podonoghue/SolderingStation/Mechanical/OLED_128x64_2-42inch.png

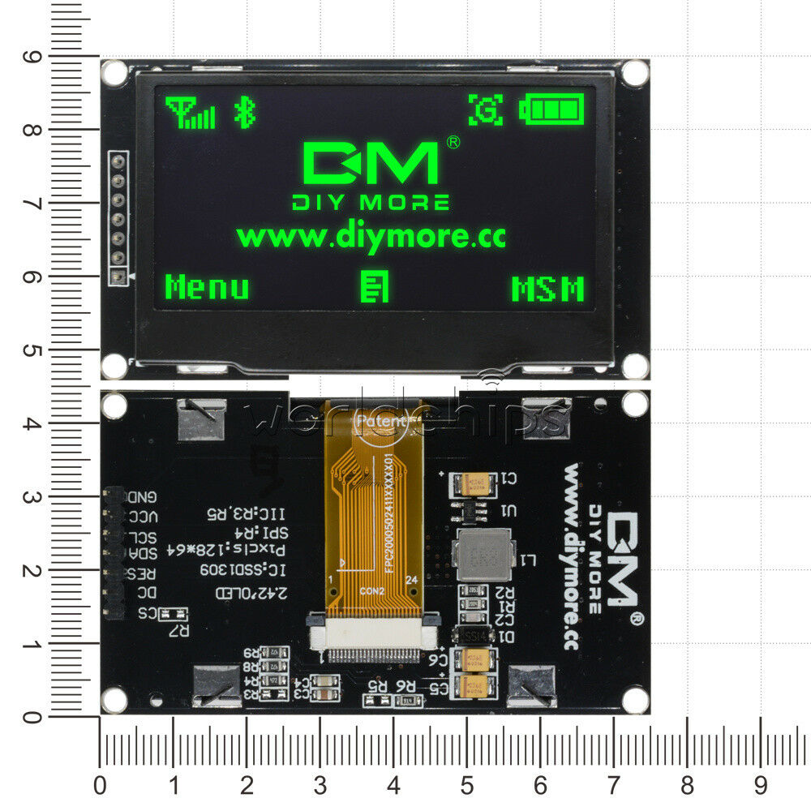
Mechanical/OLED_128x64_2-42inch.png
