podonoghue/SolderingStation/Mechanical/OLED_128x64_2-42inch#2.png

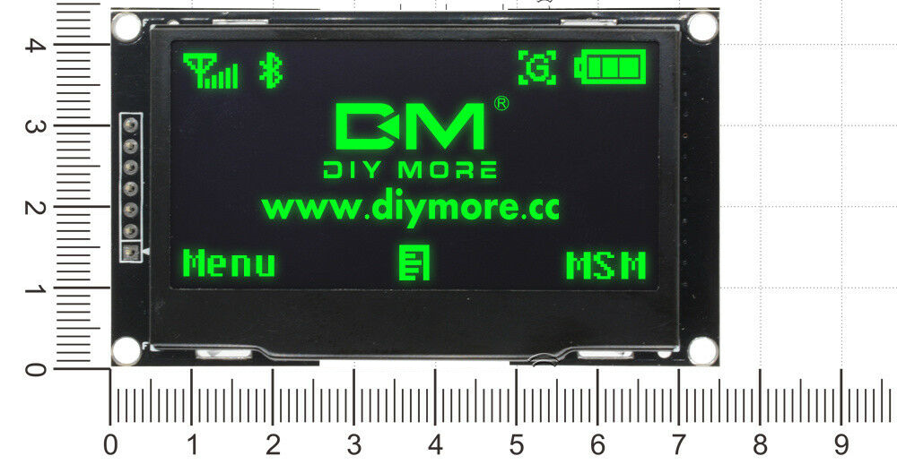
Mechanical/OLED_128x64_2-42inch#2.png
