podonoghue/SolderingStation/README.md

# SolderingStation

Soldering Station - Work in Progress
