podonoghue/SolderingStation/PCB_Controller_V4/ReadMe.md

# Main PCB
This PCB is mounted directly behind the fron panel and supports the main controls and buttons along with the majority of the circuitry.
 
[Documentation](https://raw.githubusercontent.com/podonoghue/SolderingStation/master/PCB_Controller_V4/SolderingStation_V4.PDF)
