podonoghue/SolderingStation/PCB_Setback/ReadMe.md

# Setback PCB

Small PCB mounted on back panel to allow connection of stand sensors
 
[Documentation](https://raw.githubusercontent.com/podonoghue/SolderingStation/master/PCB_Setback/Setback_V1.PDF)
