podonoghue/SolderingStation/PCB_Quad/ReadMe.md

# Quadrature Encoder daughter board
A small adapter board to transition between the main board and a quadrature encoder.  
Allows more flexible depth of the main board.
 
[Documentation](https://raw.githubusercontent.com/podonoghue/SolderingStation/master/PCB_Quad/QuadSwitch.PDF)
