podonoghue/SolderingStation/PCB_Rectifier/ReadMe.md

# Synchronous Rectifier
Synchronous Rectifier intended to provide 12/24V to a resitive load from centre-tapper 12V+12V transformer
 
[Documentation](https://raw.githubusercontent.com/podonoghue/SolderingStation/master/PCB_Rectifier/SynchronousRectifier.PDF)
