podonoghue/SolderingStation/Software/KinetisBootloader/README.md

# Booloader for Sodlering Station
This is a USB based bootloader.  
It is activated by holding down the menu button
while plugging in the usb lead.
