podonoghue/SolderingStation/Resources/Thermister (ntc_mf58, 10k B3950).pdf

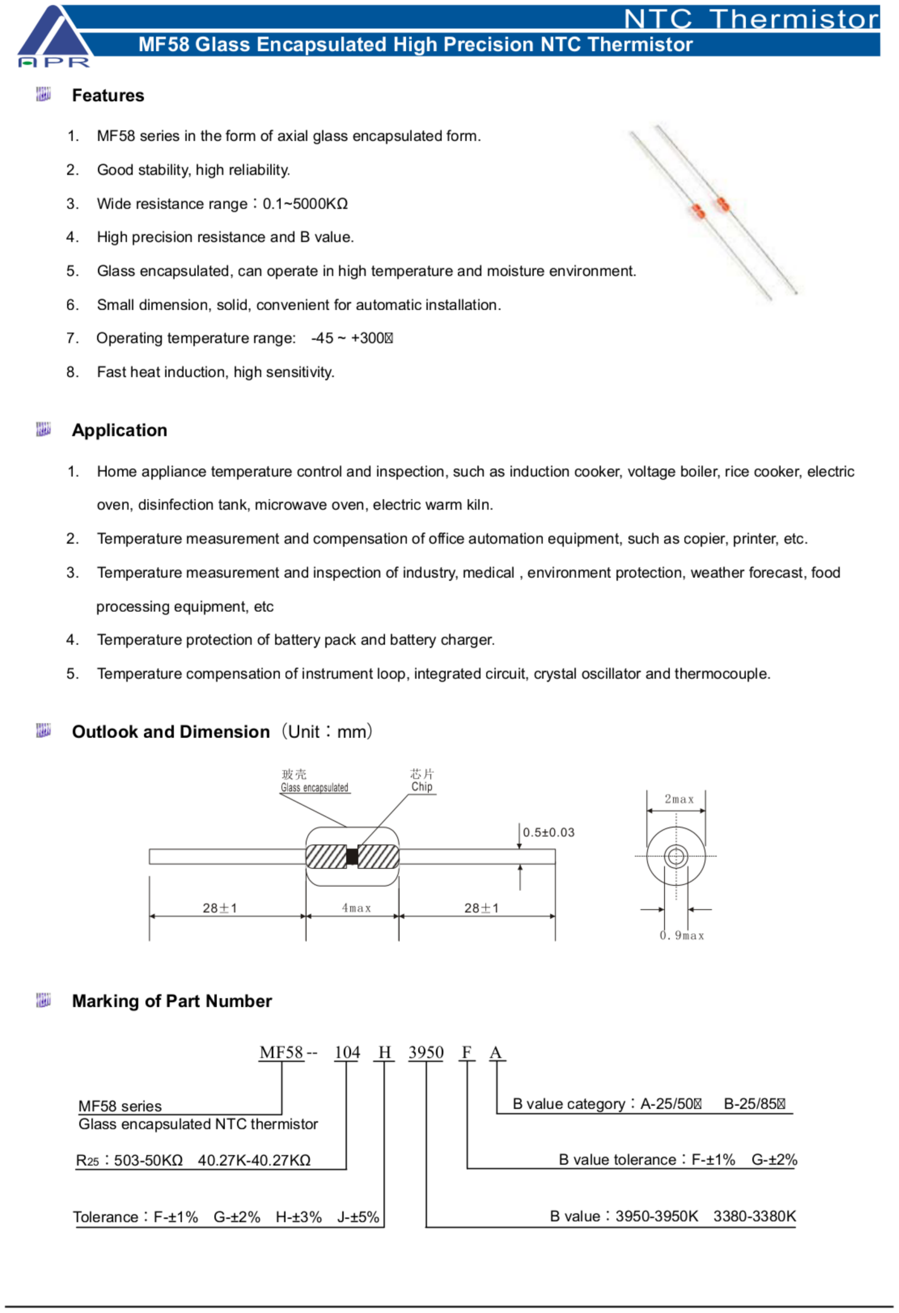
[picture p3: page 1]
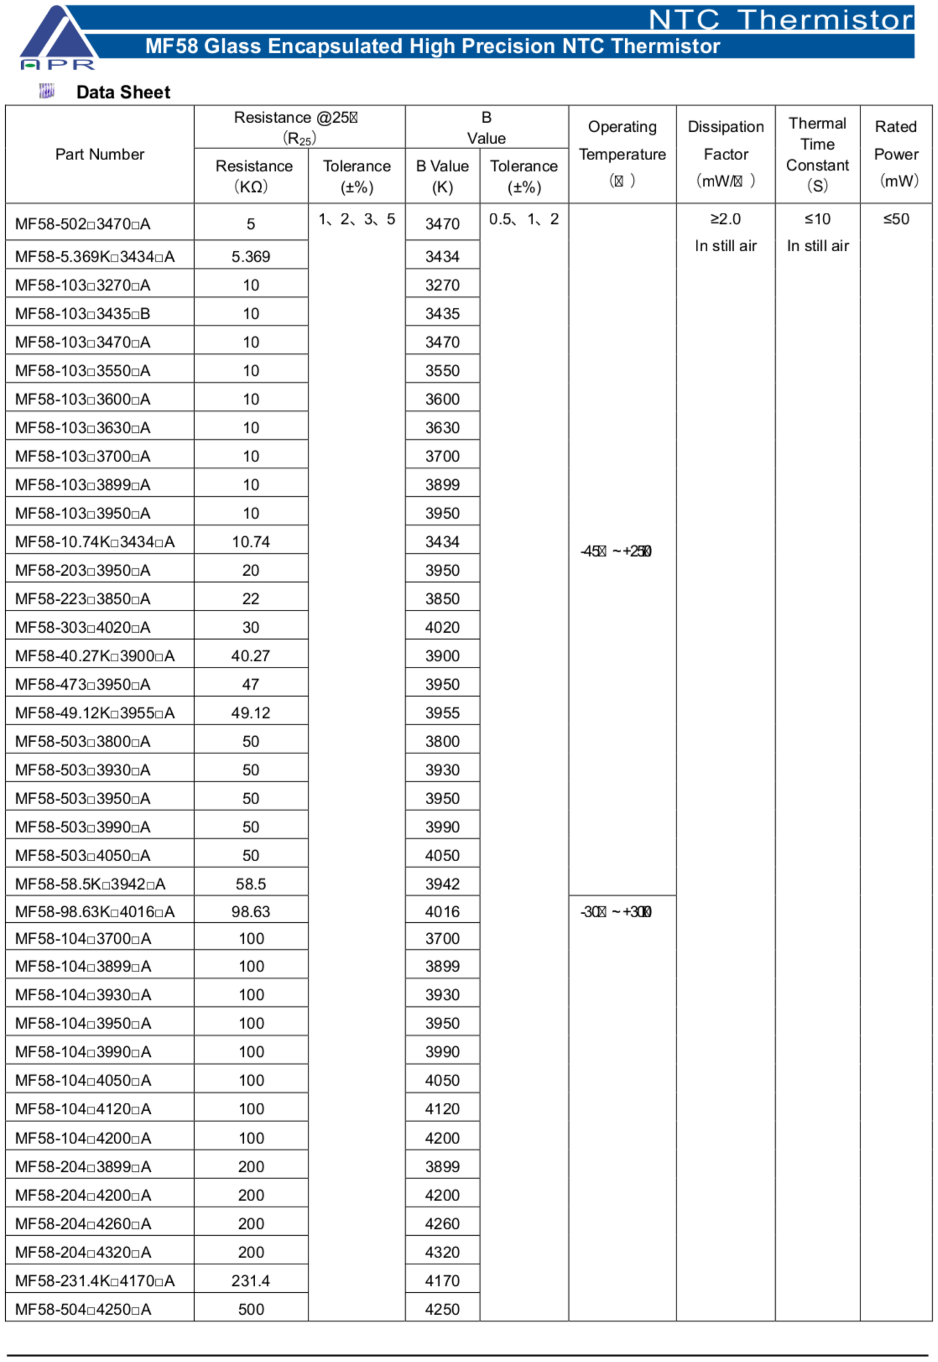
[picture p4: page 2]
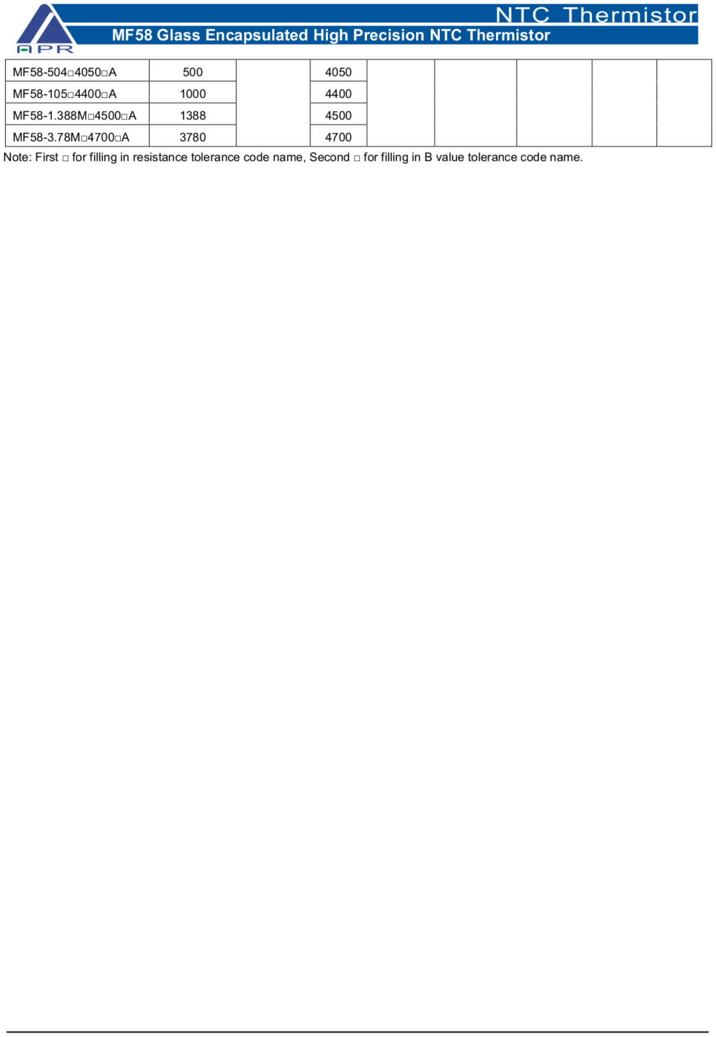
[picture p5: page 3]
