podonoghue/SolderingStation/Mechanical/Box2.png

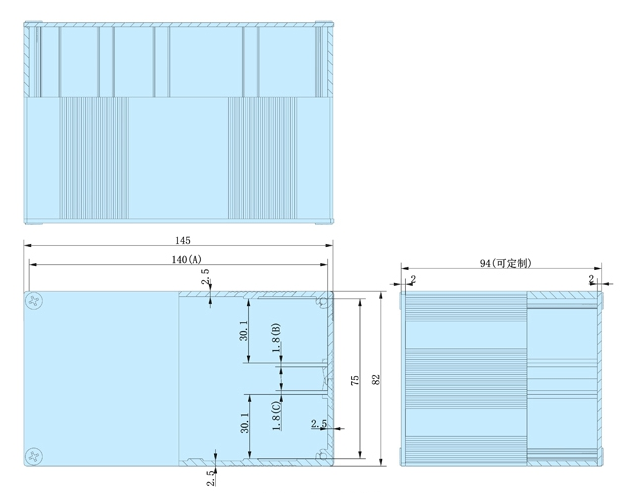
Mechanical/Box2.png
