podonoghue/SolderingStation/Mechanical/Box3.png

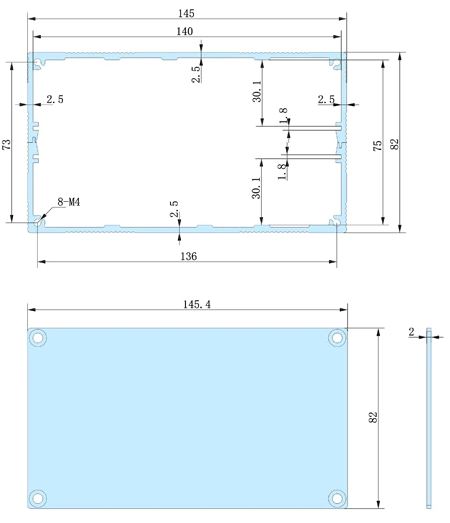
Mechanical/Box3.png
