podonoghue/SolderingStation/Mechanical/Box.png

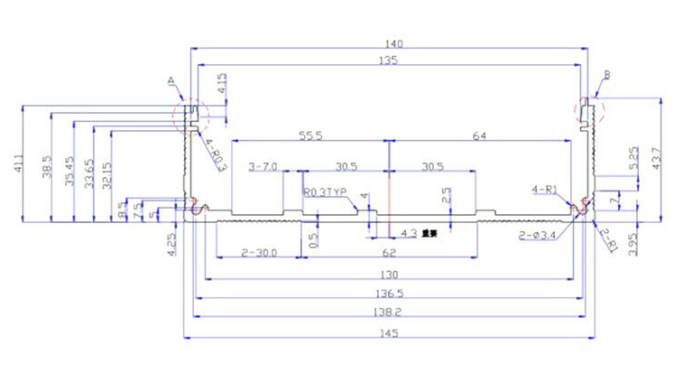
Mechanical/Box.png
