podonoghue/SolderingStation/Mechanical/Oled.png

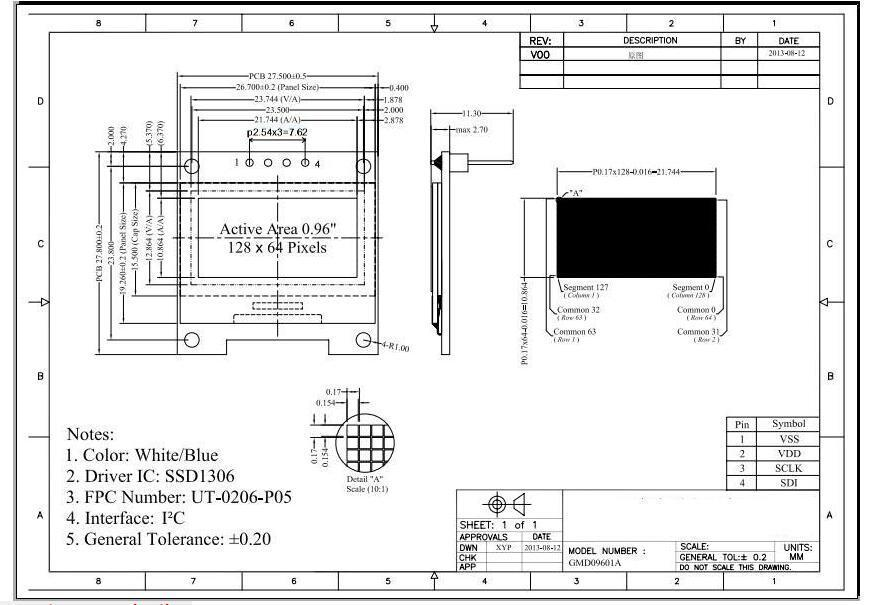
Mechanical/Oled.png
