podonoghue/SolderingStation/Resources/Thermocouple without clamping.png

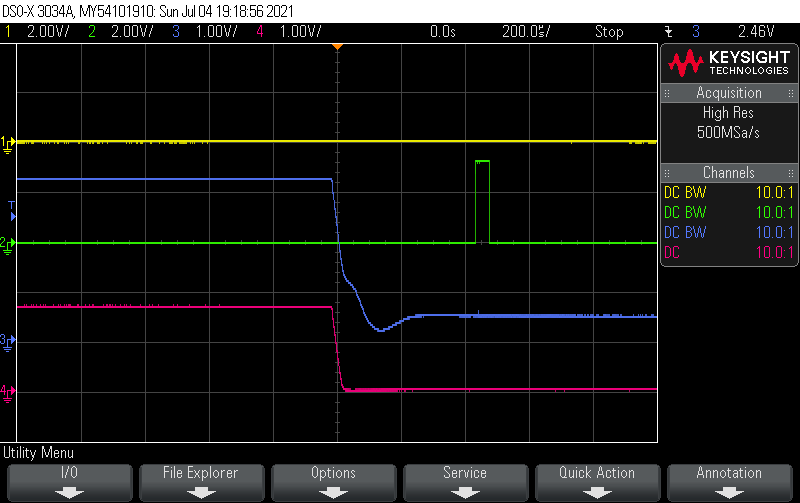
Resources/Thermocouple without clamping.png
