podonoghue/SolderingStation/Mechanical/User Library-3_5MM Panel Mount Audio Jack - 3 Connector/User Library-3.5MM Panel Mount Audio Jack - 3 Connector.sldasm

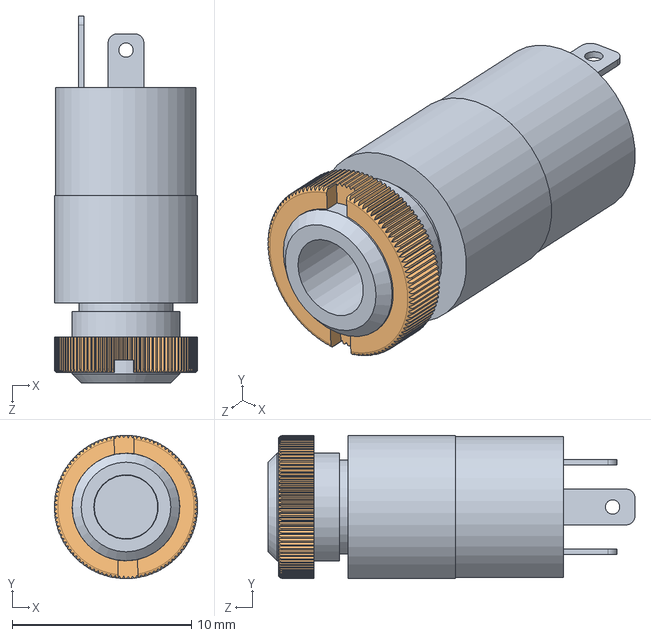
[picture p11: CAD file, 2021-06-08]
Mechanical/User Library-3_5MM Panel Mount Audio Jack - 3 Connector/User Library-3.5MM Panel Mount Audio Jack - 3 Connector.sldasm
8.00 x 8.00 x 20.5 mm
User Library-3.5MM Panel Mount Audio Jack - 3 Connector_3.5MM Panel Mount Audio Jack - 4 Connector - korpus
User Library-3.5MM Panel Mount Audio Jack - 3 Connector_3.5MM Panel Mount Audio Jack - 4 Connector - nakr_X2_0119_X0_tka
