podonoghue/SolderingStation/Mechanical/985IEC_Connector with Fuse/IEC_Connector with fuse.SLDASM

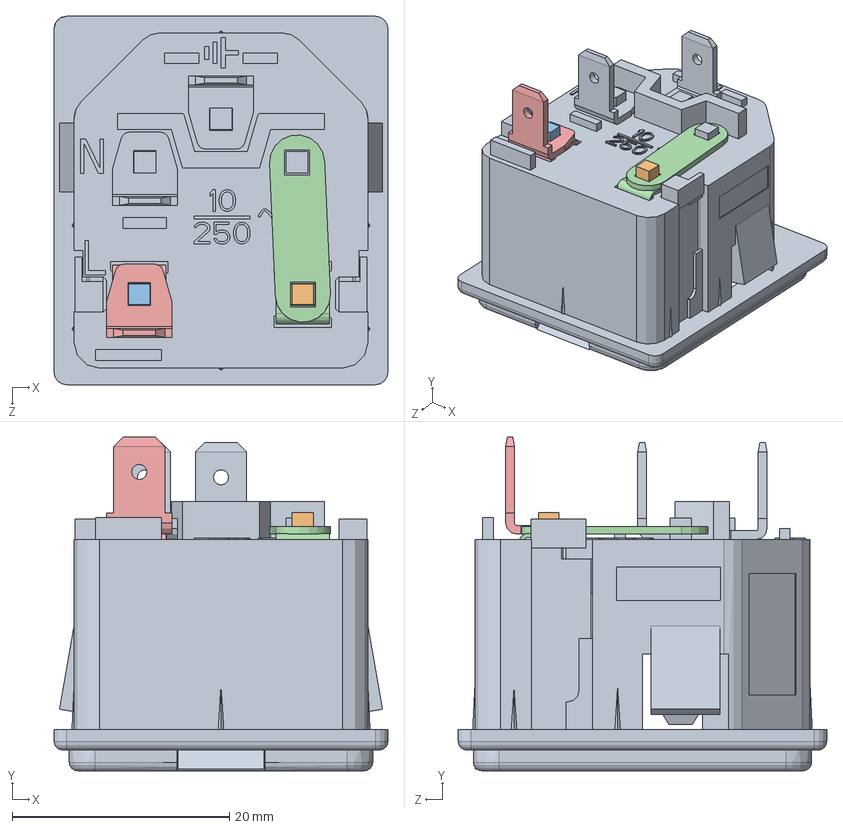
[picture p12: CAD file, 2021-06-08]
Mechanical/985IEC_Connector with Fuse/IEC_Connector with fuse.SLDASM
30.7 x 30.7 x 33.9 mm
pf0011-10-48_01
pf0011-10-48_02
pf0011-10-48_03
pf0011-10-48_04
pf0011-10-48_05
