podonoghue/SolderingStation/Mechanical/CaseExtrusion.SLDPRT

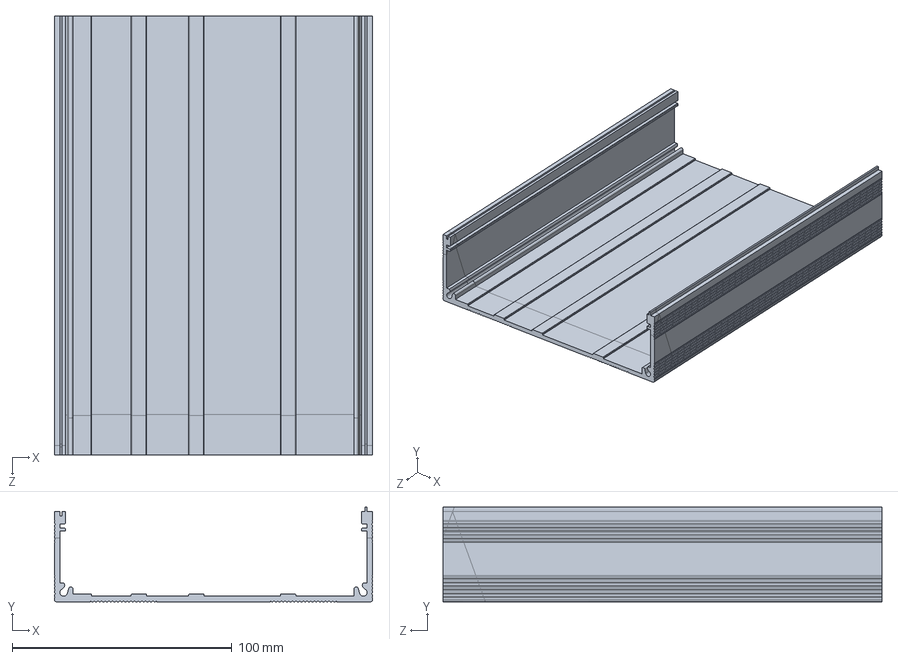
[picture p13: CAD file, 2021-06-08]
Mechanical/CaseExtrusion.SLDPRT
145.0 x 43.1 x 200.0 mm
