podonoghue/SolderingStation/PCB_Setback/Setback.step

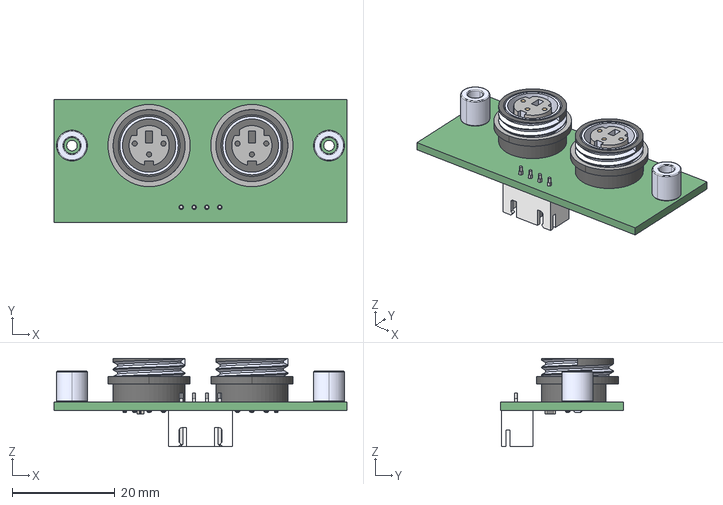
[picture p14: CAD file, 2021-06-08]
PCB_Setback/Setback.step
57.0 x 24.0 x 17.2 mm
