podonoghue/SolderingStation/Mechanical/RockerSwitch/RockerSwitch.SLDPRT

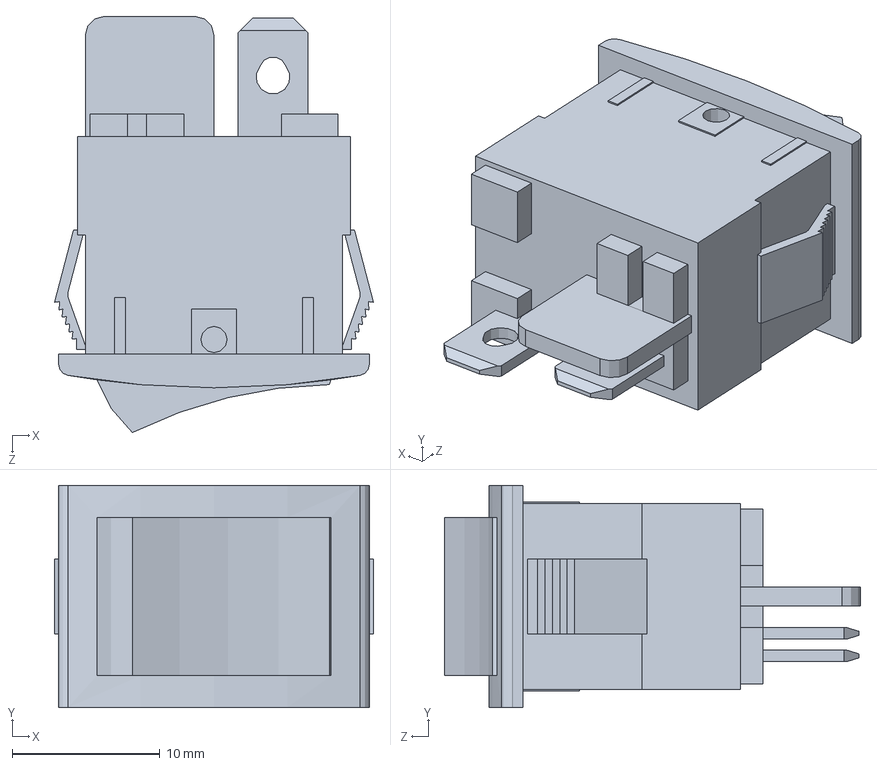
[picture p15: CAD file, 2021-06-08]
Mechanical/RockerSwitch/RockerSwitch.SLDPRT
21.6 x 15.0 x 28.1 mm
