podonoghue/SolderingStation/Mechanical/Triad Magnetics-VPT48-3300.SLDPRT

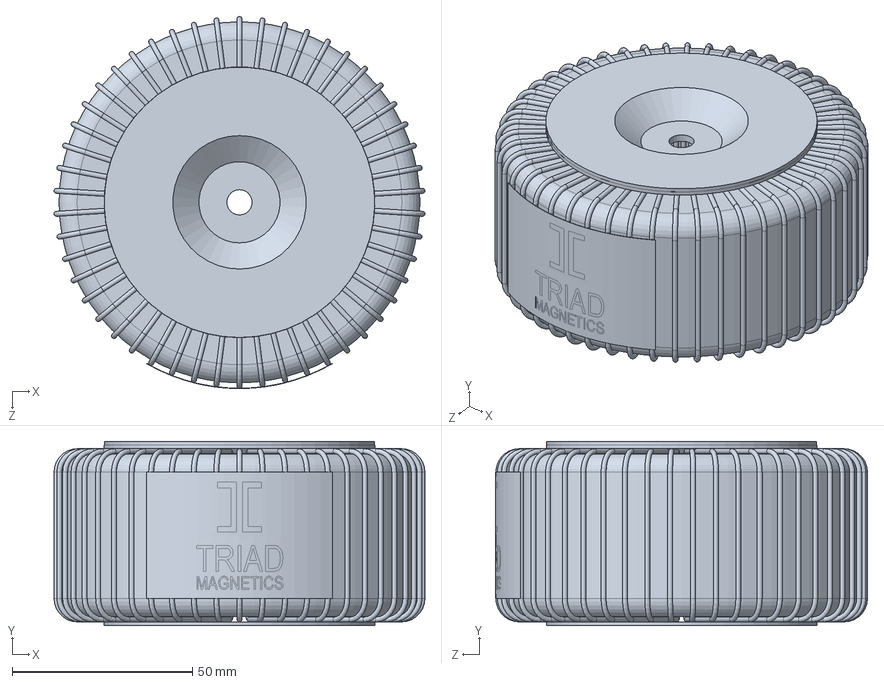
[picture p16: CAD file, 2021-06-08]
Mechanical/Triad Magnetics-VPT48-3300.SLDPRT
102.8 x 51.0 x 103.1 mm
