podonoghue/SolderingStation/Mechanical/OLED_128x64.STEP

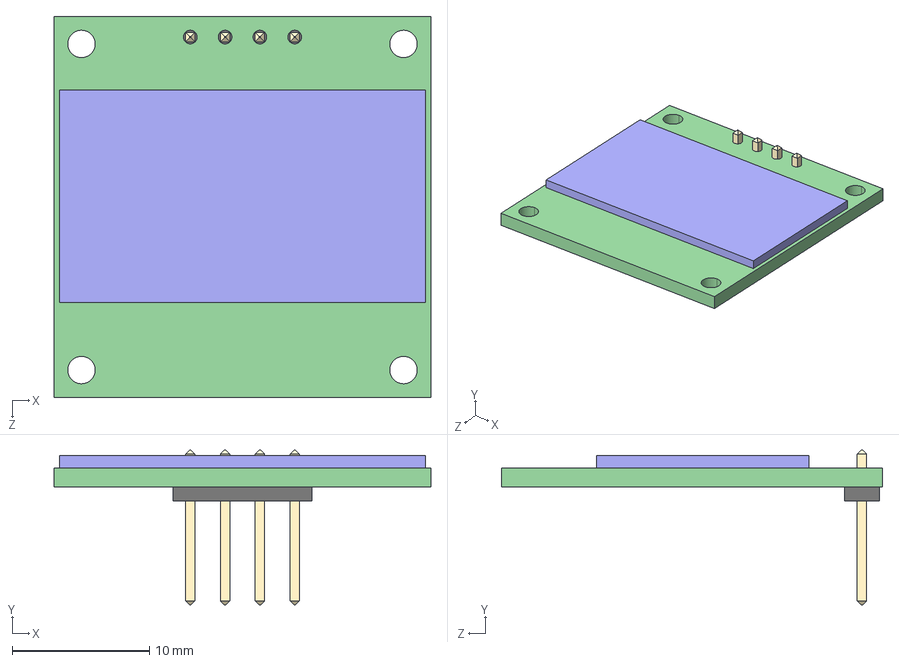
[picture p17: CAD file, 2021-06-08]
Mechanical/OLED_128x64.STEP
27.5 x 11.3 x 27.8 mm
