podonoghue/SolderingStation/Mechanical/CaseExtrusion-ModifiedTop.sldprt

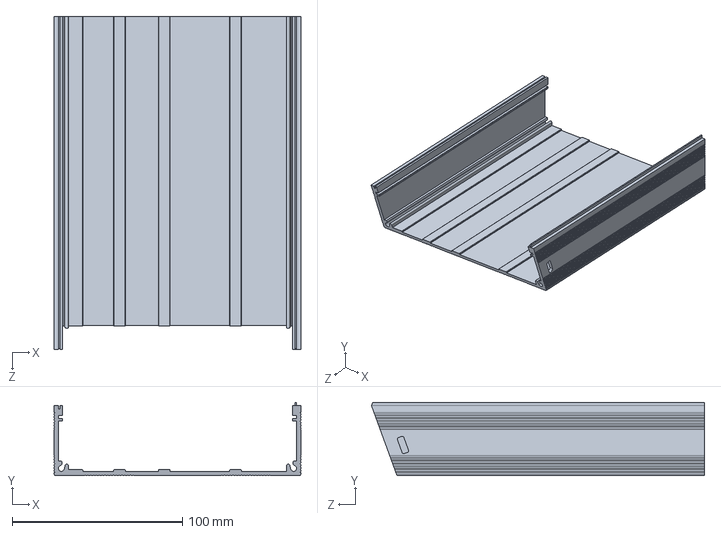
[picture p18: CAD file, 2021-06-08]
Mechanical/CaseExtrusion-ModifiedTop.sldprt
145.0 x 43.1 x 195.6 mm
