podonoghue/SolderingStation/Mechanical/AmphenolPlug.SLDPRT

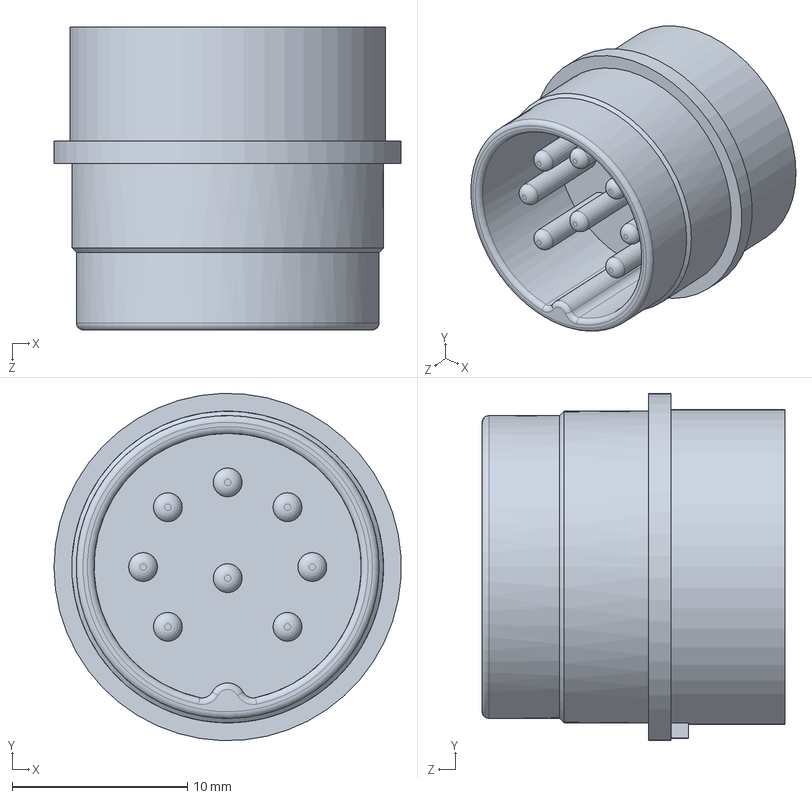
[picture p19: CAD file, 2021-06-08]
Mechanical/AmphenolPlug.SLDPRT
19.8 x 19.8 x 17.3 mm
