podonoghue/SolderingStation/Mechanical/CaseExtrusion-ModifiedBottom.sldprt

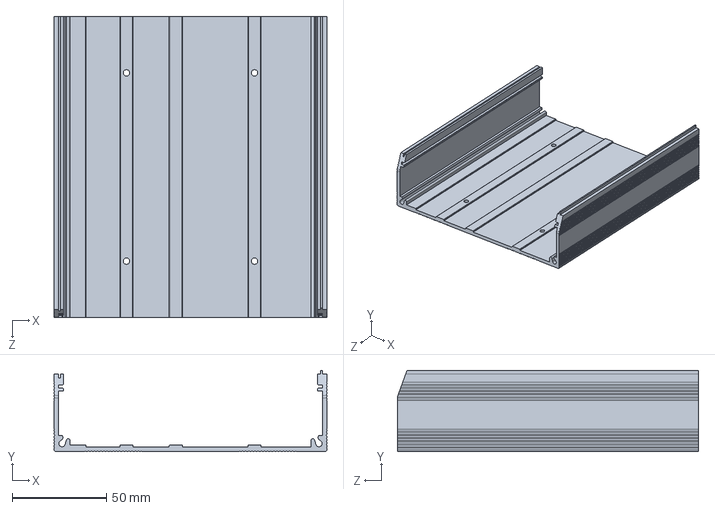
[picture p20: CAD file, 2021-06-08]
Mechanical/CaseExtrusion-ModifiedBottom.sldprt
145.0 x 43.1 x 160.0 mm
