podonoghue/SolderingStation/Mechanical/IEC_Connector_Fused_Flanges (Schurter 6200).step

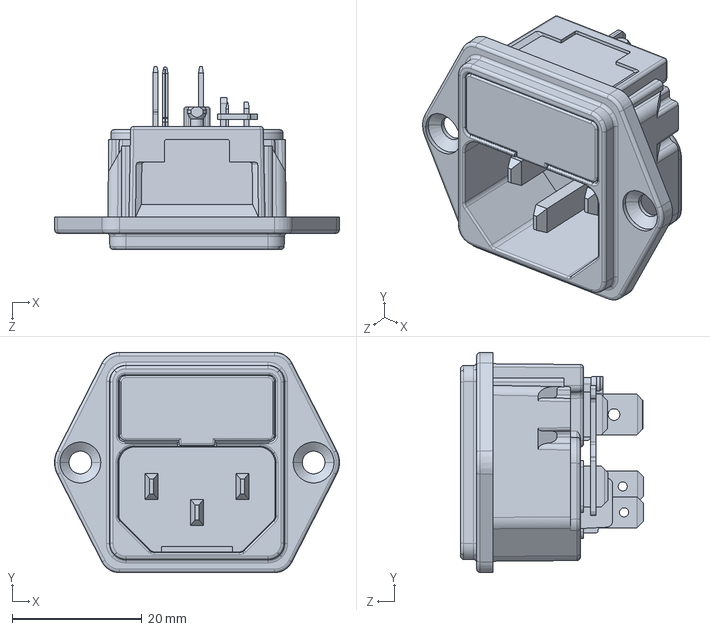
[picture p21: CAD file, 2021-06-08]
Mechanical/IEC_Connector_Fused_Flanges (Schurter 6200).step
44.0 x 34.0 x 28.3 mm
