podonoghue/SolderingStation/Mechanical/Knob.SLDPRT

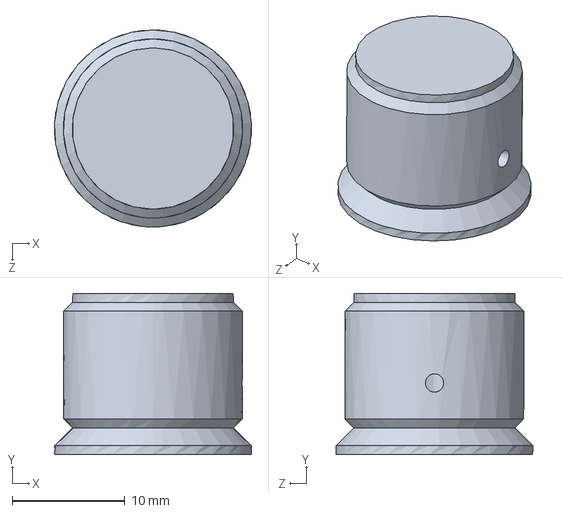
[picture p22: CAD file, 2021-06-08]
Mechanical/Knob.SLDPRT
17.4 x 14.3 x 17.5 mm
