podonoghue/SolderingStation/Mechanical/FrontPanel-Flat.STEP

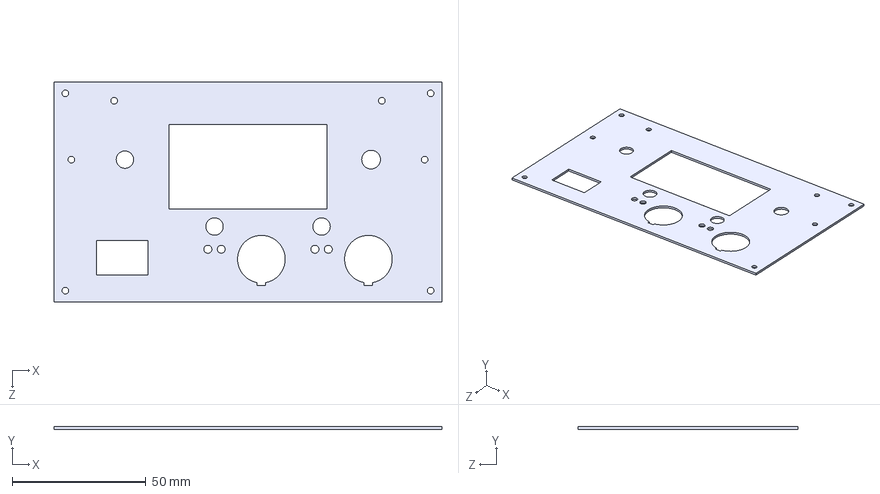
[picture p23: CAD file, 2021-06-08]
Mechanical/FrontPanel-Flat.STEP
145.0 x 1.00 x 82.2 mm
