podonoghue/SolderingStation/Mechanical/IEC_Connector with Fuse.SLDPRT

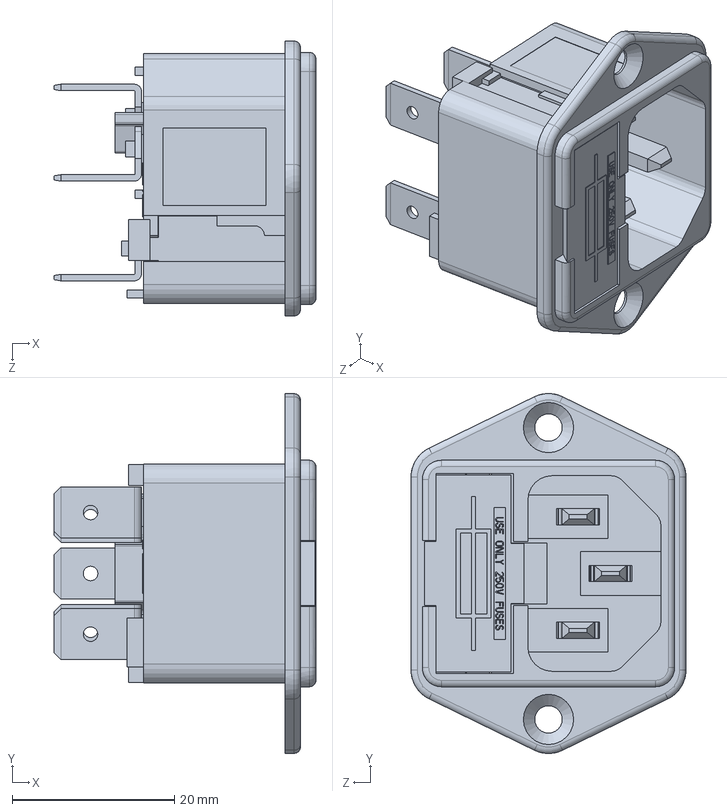
[picture p24: CAD file, 2021-06-08]
Mechanical/IEC_Connector with Fuse.SLDPRT
32.3 x 44.4 x 33.9 mm
