podonoghue/SolderingStation/Mechanical/Front Panel Bezel #2.SLDPRT

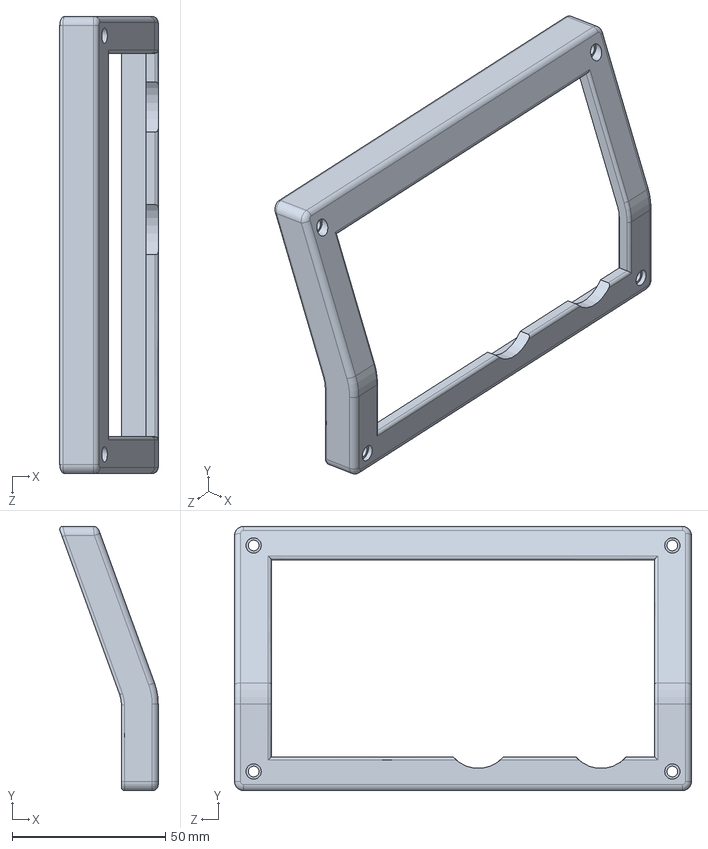
[picture p25: CAD file, 2021-06-08]
Mechanical/Front Panel Bezel #2.SLDPRT
32.1 x 86.2 x 149.0 mm
