podonoghue/SolderingStation/Mechanical/OledBezel.SLDPRT

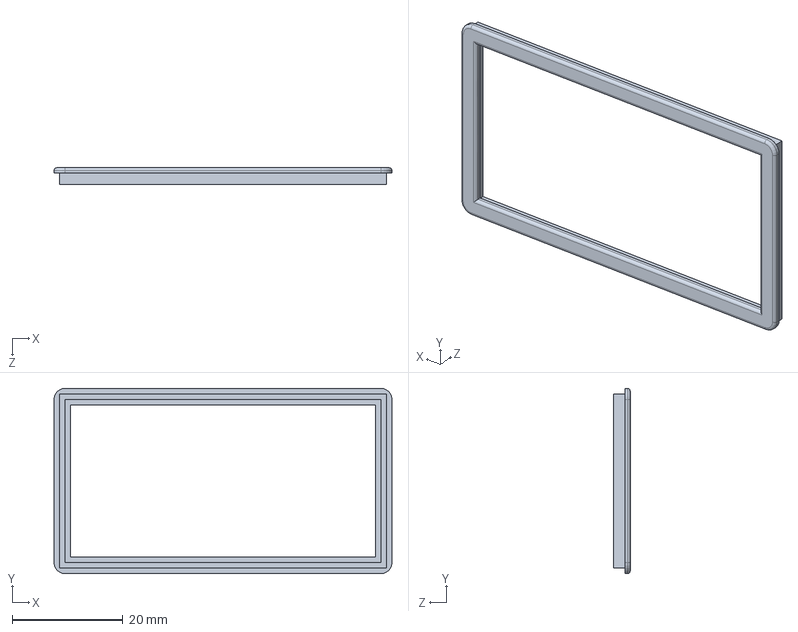
[picture p26: CAD file, 2021-06-08]
Mechanical/OledBezel.SLDPRT
61.1 x 33.5 x 3.00 mm
