podonoghue/SolderingStation/Mechanical/AmphenolSocket.SLDPRT

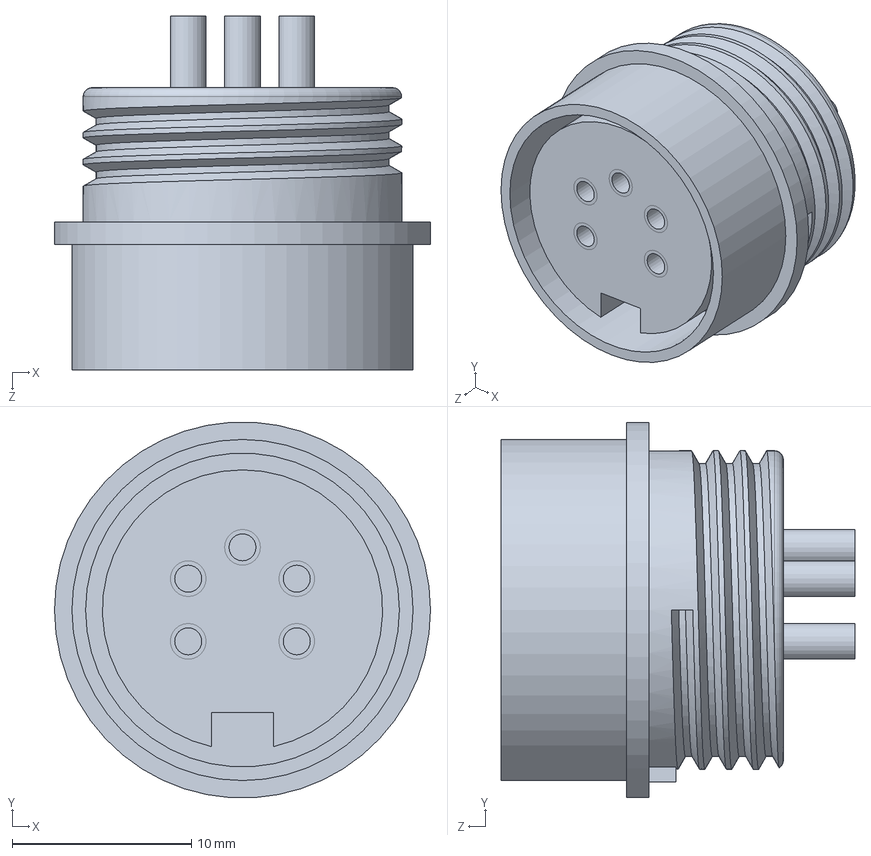
[picture p27: CAD file, 2021-06-08]
Mechanical/AmphenolSocket.SLDPRT
21.0 x 21.0 x 19.8 mm
