podonoghue/SolderingStation/Mechanical/Rear Panel.SLDPRT

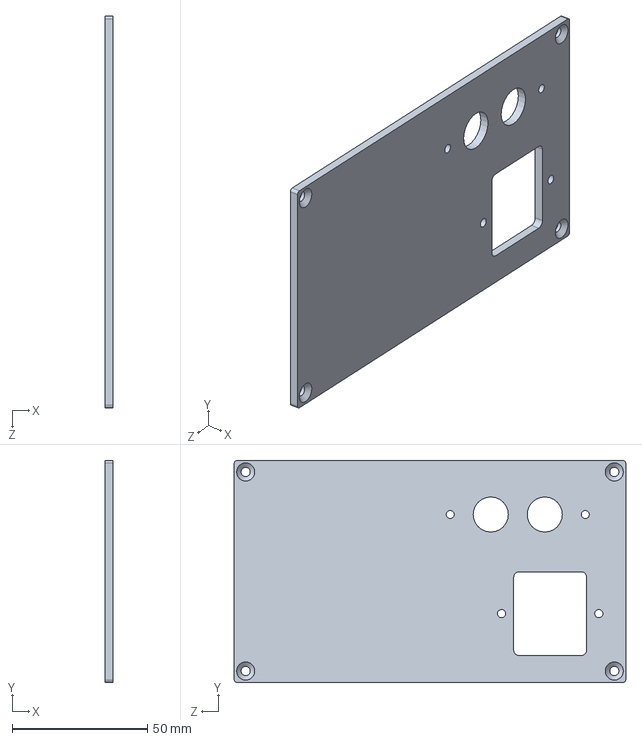
[picture p28: CAD file, 2021-06-08]
Mechanical/Rear Panel.SLDPRT
3.00 x 82.2 x 145.0 mm
