podonoghue/SolderingStation/Mechanical/Front Panel.SLDPRT

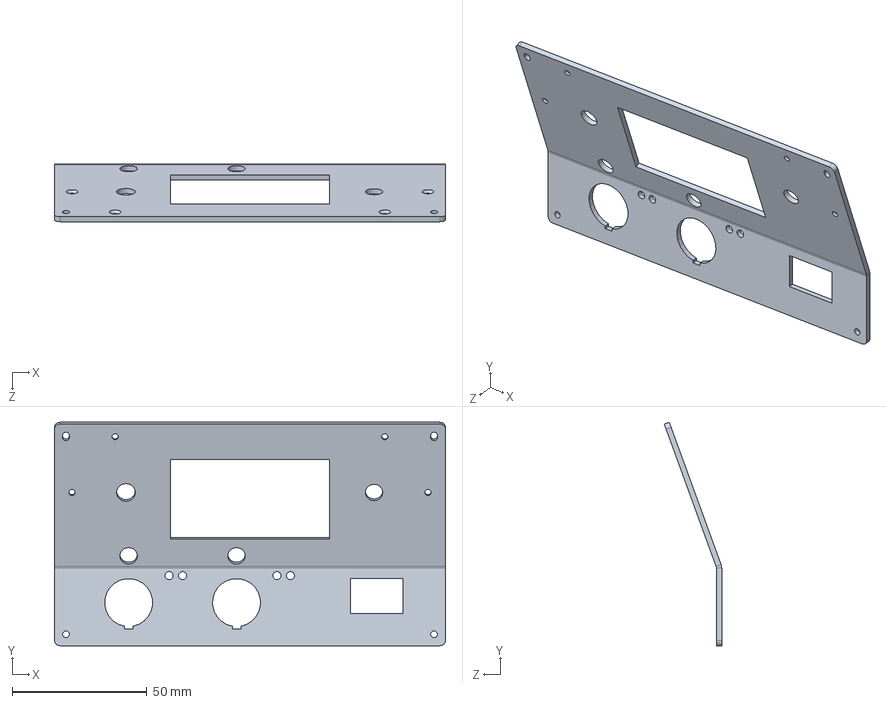
[picture p29: CAD file, 2021-06-08]
Mechanical/Front Panel.SLDPRT
145.0 x 82.9 x 21.3 mm
