podonoghue/SolderingStation/Mechanical/Transformer Mounting Plate.SLDPRT

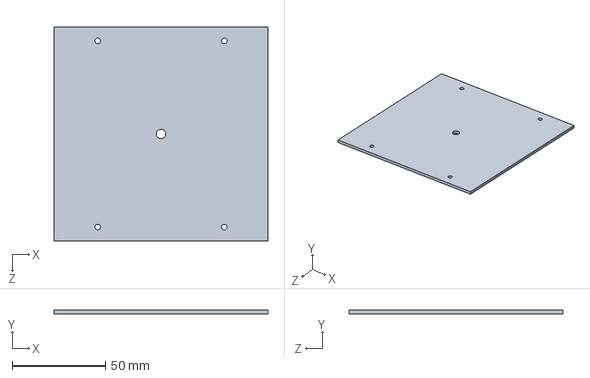
[picture p30: CAD file, 2021-06-08]
Mechanical/Transformer Mounting Plate.SLDPRT
115.0 x 2.00 x 115.0 mm
