podonoghue/SolderingStation/Mechanical/b32-2000.SLDPRT

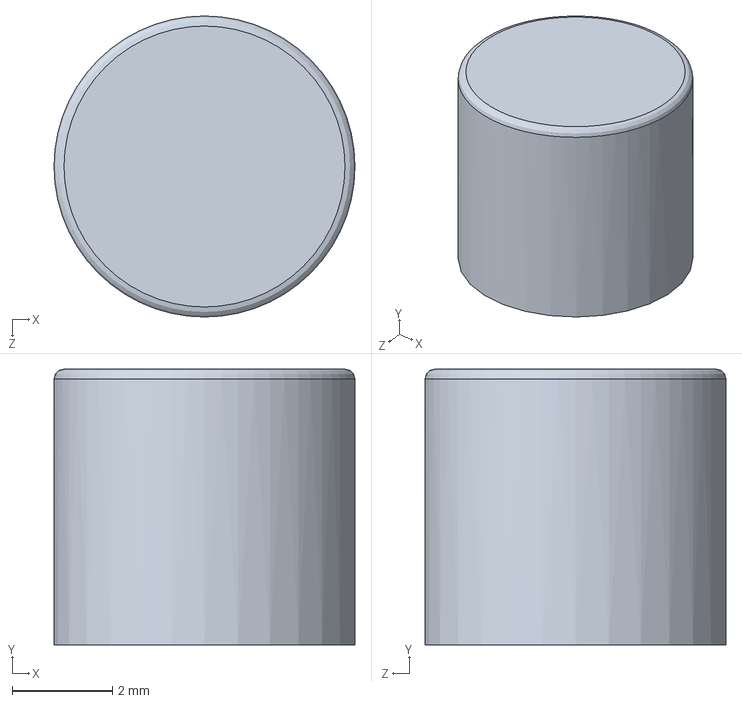
[picture p31: CAD file, 2021-06-08]
Mechanical/b32-2000.SLDPRT
6.00 x 5.50 x 6.00 mm
