podonoghue/SolderingStation/Mechanical/b32-1600.SLDPRT

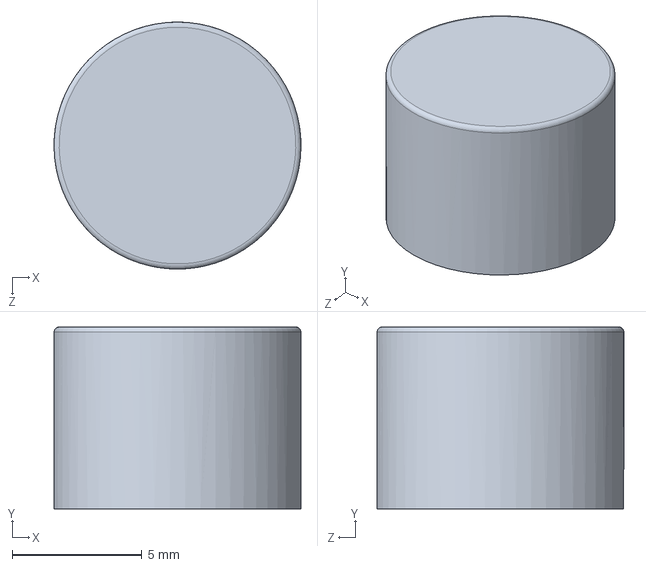
[picture p32: CAD file, 2021-06-08]
Mechanical/b32-1600.SLDPRT
9.50 x 7.00 x 9.50 mm
