podonoghue/SolderingStation/Mechanical/ToroidalTransformer.SLDPRT

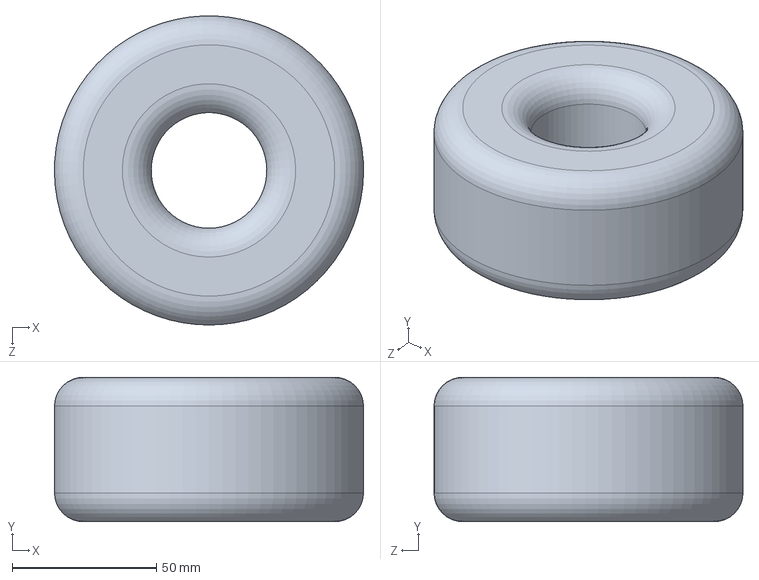
[picture p33: CAD file, 2021-06-08]
Mechanical/ToroidalTransformer.SLDPRT
107.0 x 50.0 x 107.0 mm
