podonoghue/SolderingStation/(list of files, cad)

Other CAD files:
Mechanical/985IEC_Connector with Fuse/pf0011-10-48.SLDASM
Mechanical/985IEC_Connector with Fuse/pf0011-10-48_02.SLDPRT
Mechanical/User Library-3_5MM Panel Mount Audio Jack - 3 Connector/User Library-3.5MM Panel Mount Audio Jack - 3 Connector_3.5MM Panel Mount Audio Jack - 4 Connector - nakr_X2_0119_X0_tka.sldprt
Mechanical/985IEC_Connector with Fuse/pf0011-10-48_01.SLDPRT
Mechanical/User Library-3_5MM Panel Mount Audio Jack - 3 Connector/User Library-3.5MM Panel Mount Audio Jack - 3 Connector_3.5MM Panel Mount Audio Jack - 4 Connector - korpus.sldprt
Mechanical/985IEC_Connector with Fuse/pf0011-10-48_05.SLDPRT
Mechanical/985IEC_Connector with Fuse/pf0011-10-48_04.SLDPRT
Mechanical/PTC_FUSE_0805.step.SLDPRT
Mechanical/985IEC_Connector with Fuse/pf0011-10-48_03.SLDPRT
Mechanical/AmphenolSocket2.SLDPRT
Mechanical/User Library-t3506-009.SLDPRT
Mechanical/Setback.step
Mechanical/Front Panel Bezel.SLDPRT
Mechanical/Mini-DIN-socket-3-pin.step.SLDPRT
Mechanical/430450412.SLDPRT
Mechanical/985IEC_Connector with Fuse/IEC_Connector with Fuse Screw mount.SLDPRT
Mechanical/Front Panel Bezel_old.SLDPRT
Mechanical/FrontPanel-Flat.SLDPRT
Mechanical/IEC_Connector_Fused_Flanges (Schurter 6200).SLDPRT
Mechanical/OLED_128x64.SLDPRT
Mechanical/RockerSwitch/46984.SLDPRT
Mechanical/Setback.SLDASM
