podonoghue/SolderingStation/Resources/Hakko Tip Guide (AliExpress).png

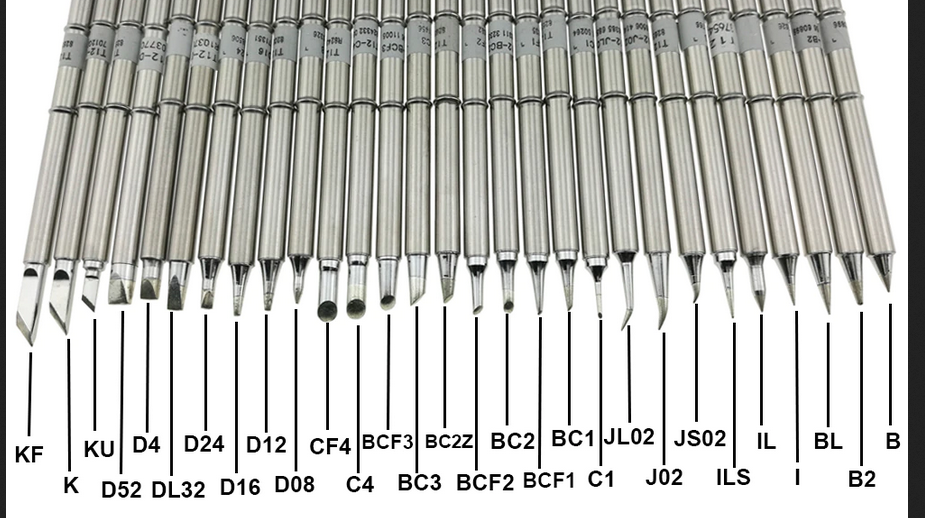
Resources/Hakko Tip Guide (AliExpress).png
