podonoghue/SolderingStation/Resources/Testing/BCF2/2_.01_loadtest.png

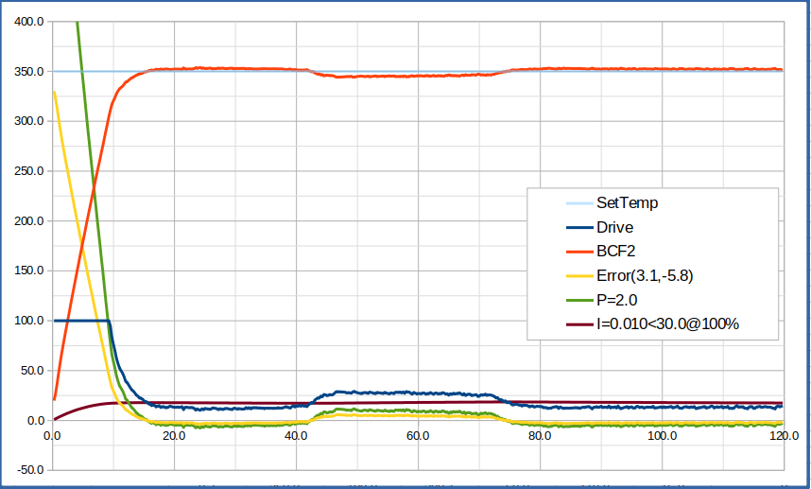
Resources/Testing/BCF2/2_.01_loadtest.png
