podonoghue/SolderingStation/PCB_Controller_V4/TipWiring.pdf

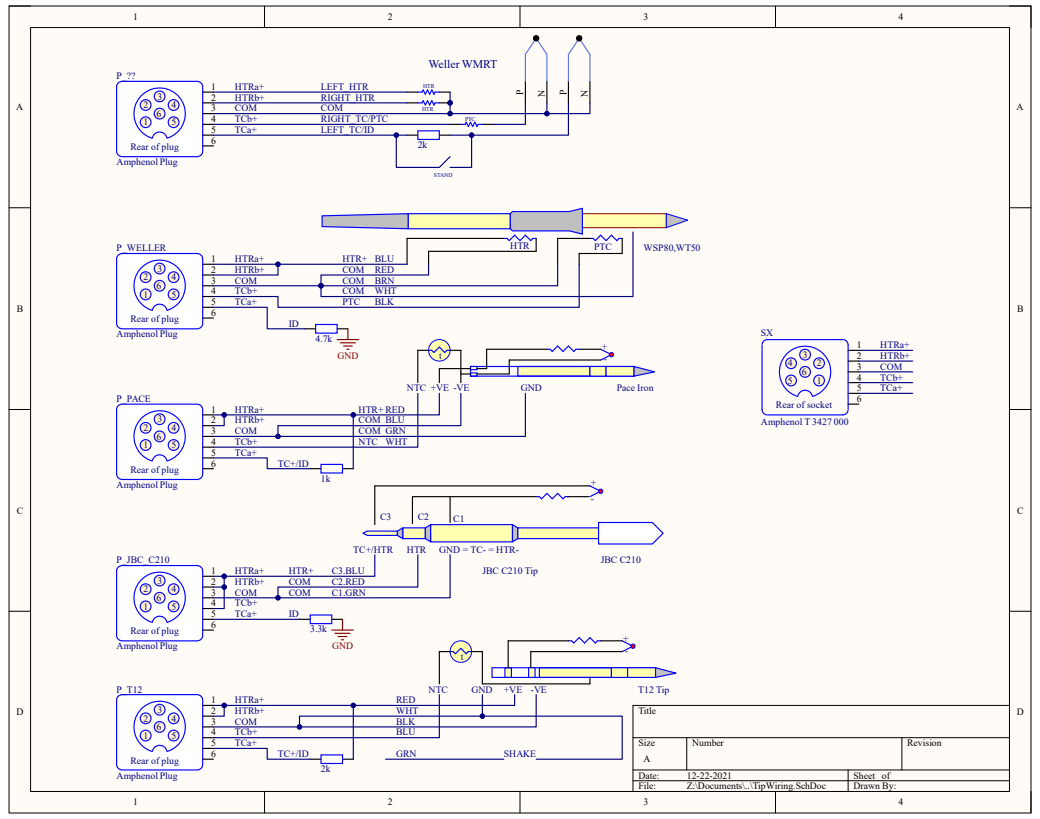
[picture p36: page 1]
Title; Size; Number; Revision; Date:; Sheet of; File:; Z:\Documents\..\TipWiring.SchDoc; Drawn By:; NTC; T12 Tip; RED; BLK; GRN; WHT; BLU; SHAKE; TC+/HTR; HTR GND = TC- = HTR-; JBC C210 Tip; JBC C210; P_JBC_C210; P_PACE; GRN WHT; C2.RED C1.GRN; C3.BLU; P_WELLER; WHT BLK; HTR; PTC; WSP80,WT50; GND; Pace Iron; BRN; HTRb+; HTRa+; TCa+; COM TCb+; HTR+ COM COM COM PTC; HTR+ COM COM NTC; HTR+ COM COM; COM; LEFT_HTR RIGHT_HTR; LEFT_TC/ID; RIGHT_TC/PTC; STAND; Weller WMRT

Rear of plug
Amphenol Plug

Rear of socket
Amphenol T 3427 000

GND +VE -VE
