podonoghue/SolderingStation/Simulation/12V-On-Waveforms.pdf

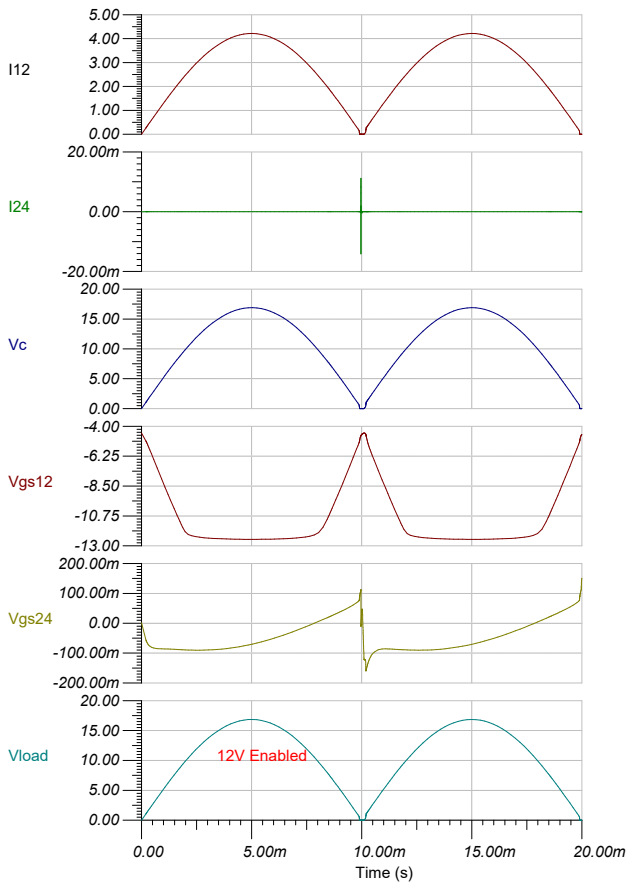
[picture p37: page 1]
Time (s); Vgs12; Vgs24; Vload; 12V Enabled
