podonoghue/SolderingStation/Simulation/24V-On-Waveforms.pdf

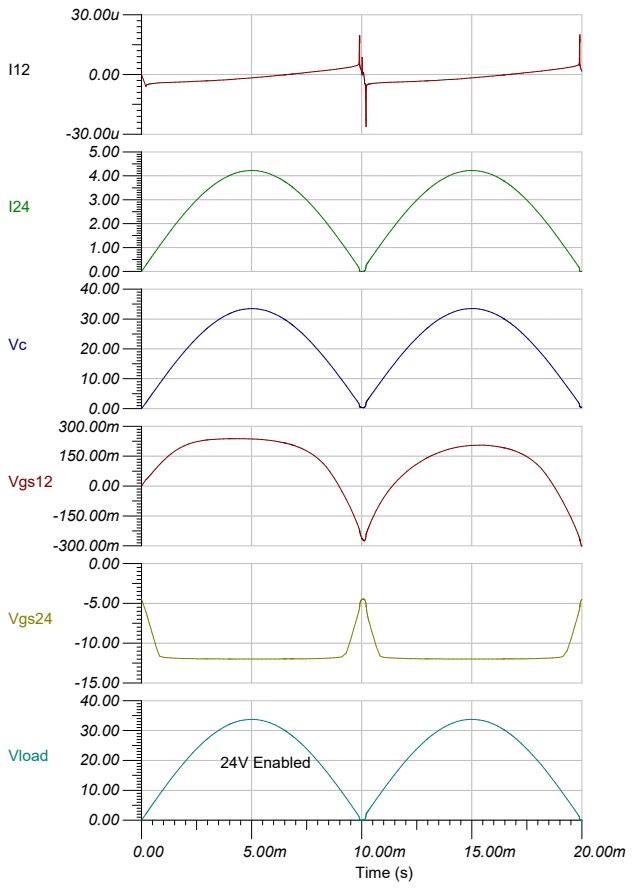
[picture p38: page 1]
Time (s); Vgs12; Vgs24; Vload; 24V Enabled
