podonoghue/SolderingStation/PCB_Setback/Setback_V1.PDF

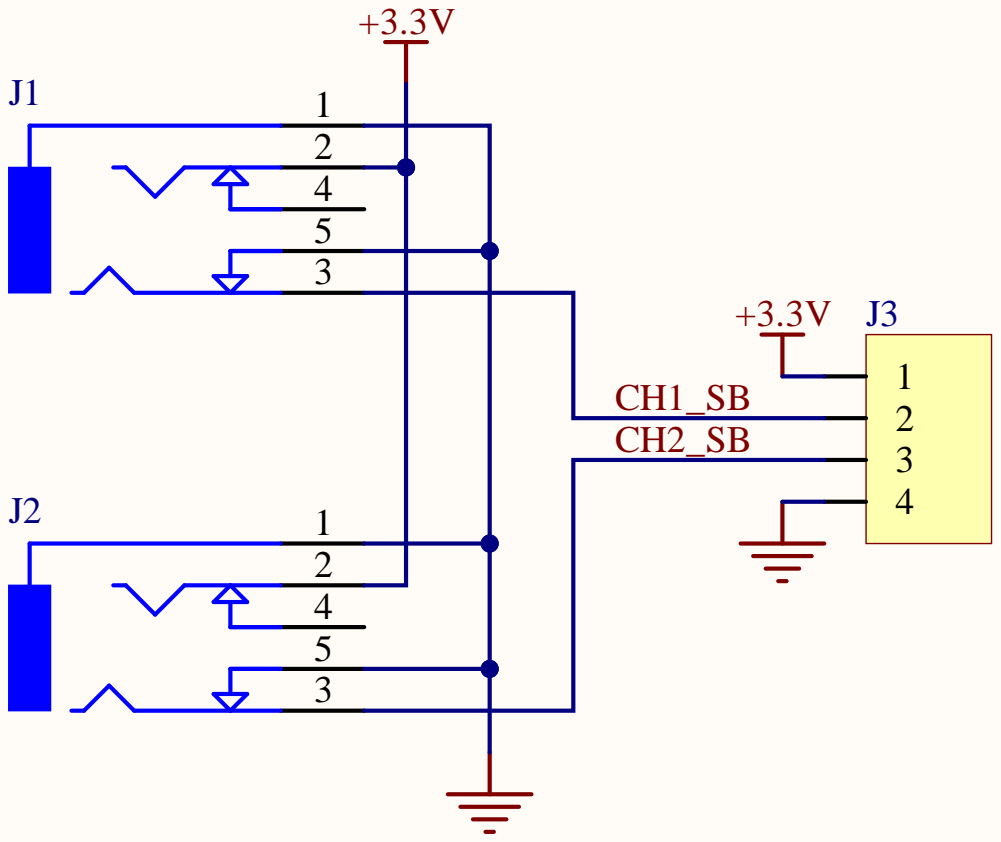
[picture p39: page 1]

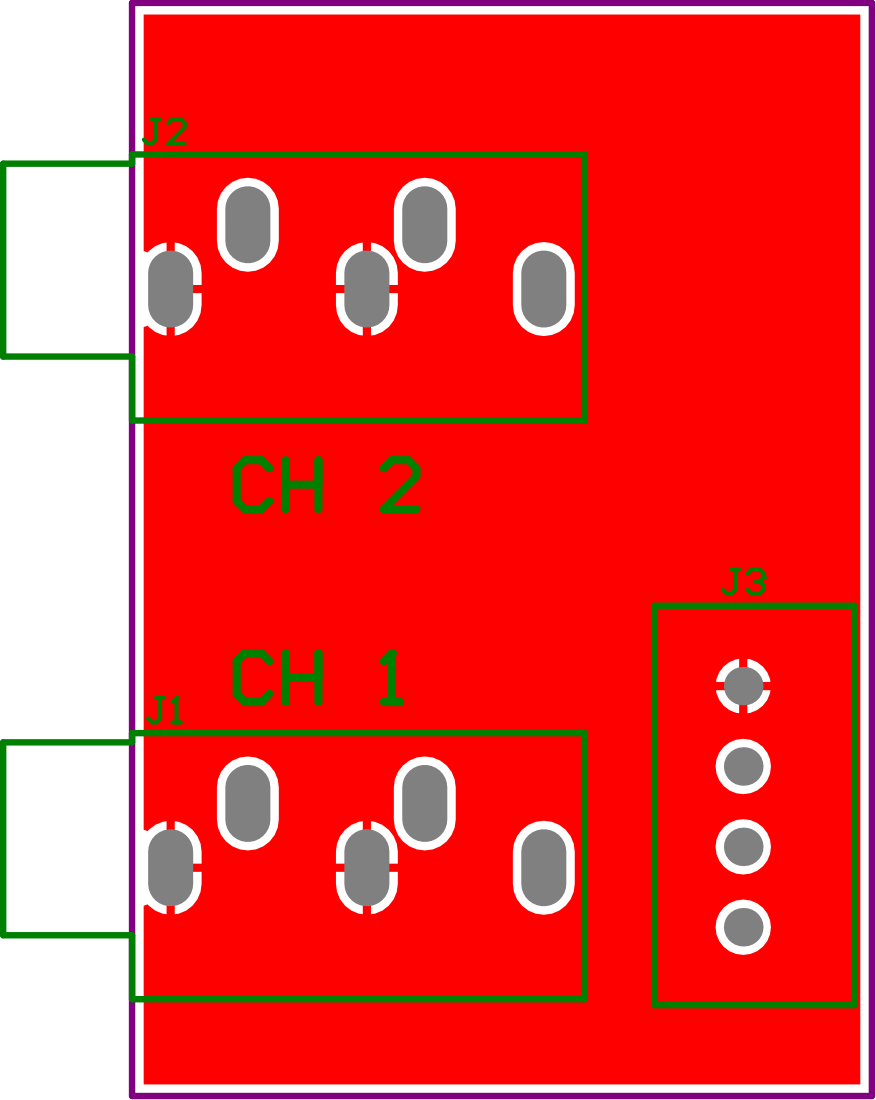
[picture p40: page 2]

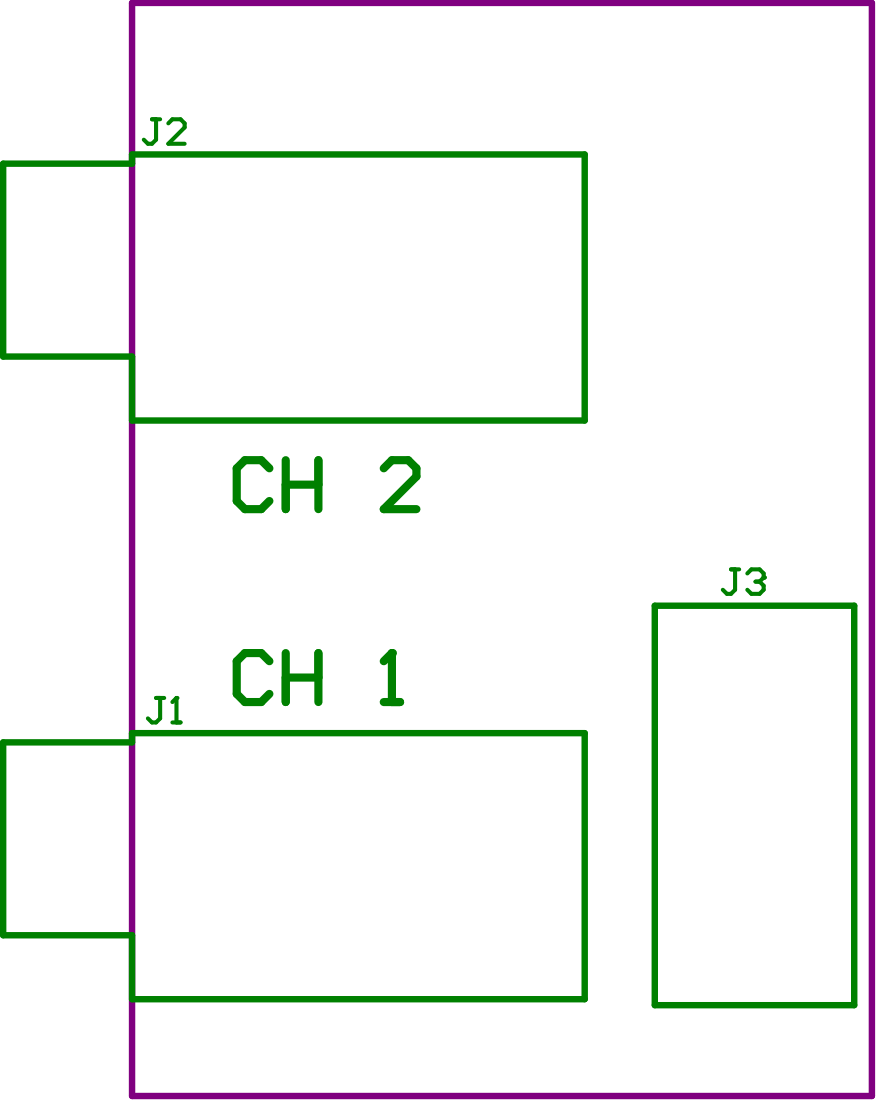
[picture p41: page 3]

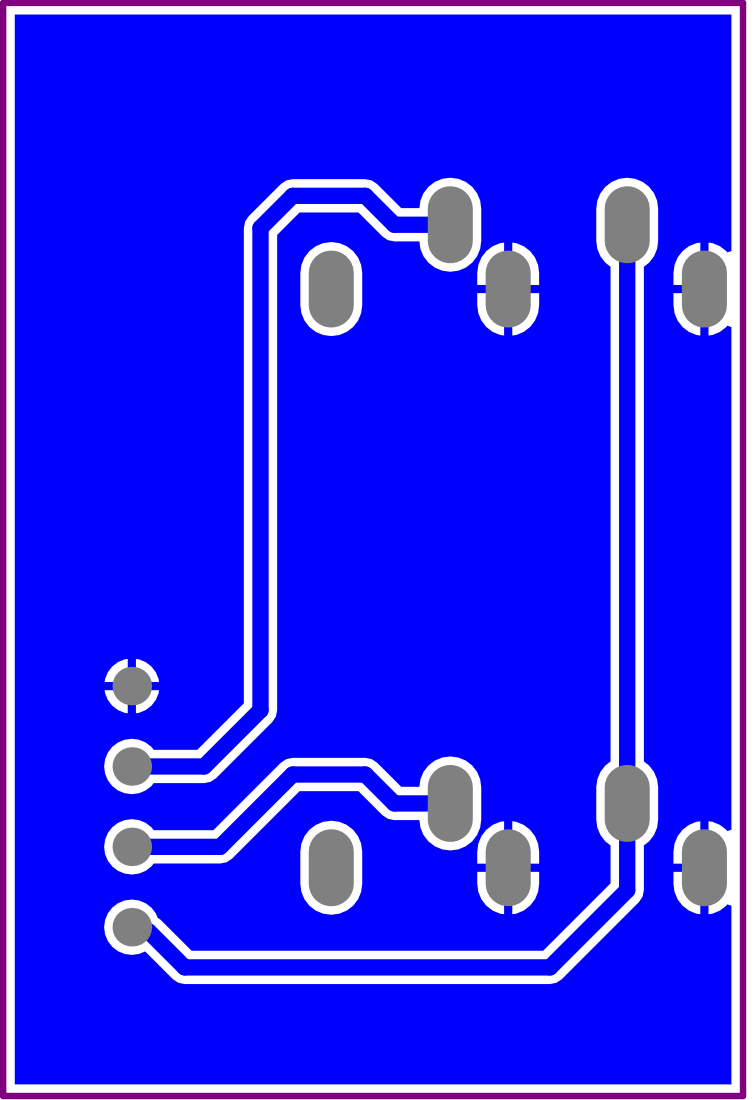
[picture p42: page 4]

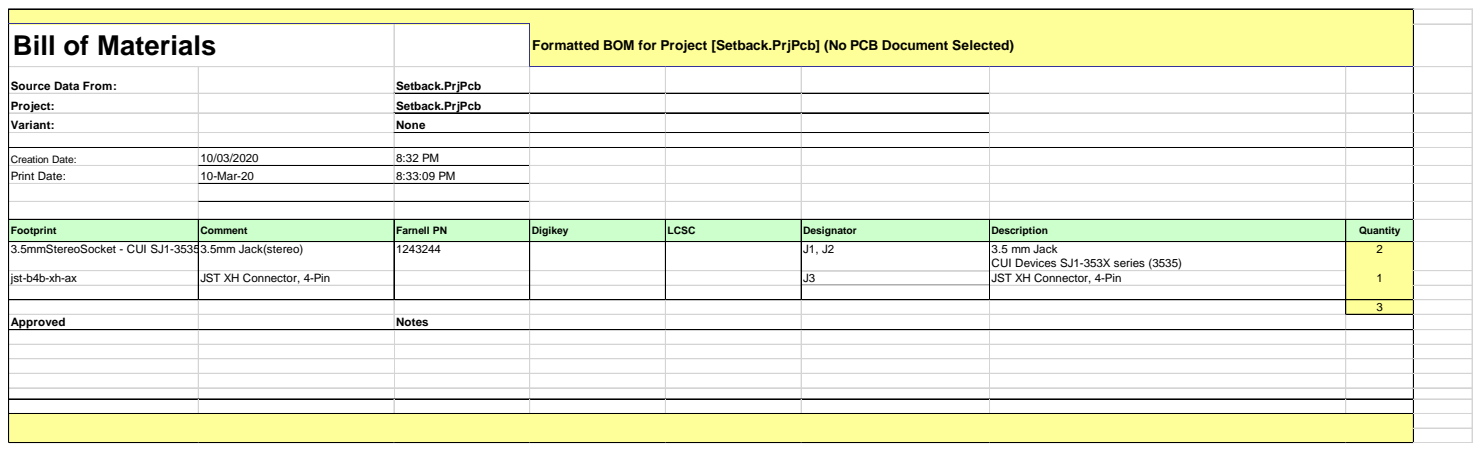
[picture p43: page 5]

Bill of Materials | Formatted BOM for Project [Setback.PrjPcb] (No PCB Document Selected)

Source Data From: | Setback.PrjPcb
Project: | Setback.PrjPcb
Variant: | None

Creation Date: | 10/03/2020 | 8:32 PM
Print Date: | 10-Mar-20 | 8:33:09 PM

Footprint | Comment | Farnell PN | Digikey | LCSC | Designator | Description | Quantity
3.5mmStereoSocket - CUI SJ1-35353.5mm Jack(stereo) | | 1243244 | | | J1, J2 | 3.5 mm Jack CUI Devices SJ1-353X series (3535) | 2

jst-b4b-xh-ax | JST XH Connector, 4-Pin | | | | J3 | JST XH Connector, 4-Pin | 1

Approved | Notes

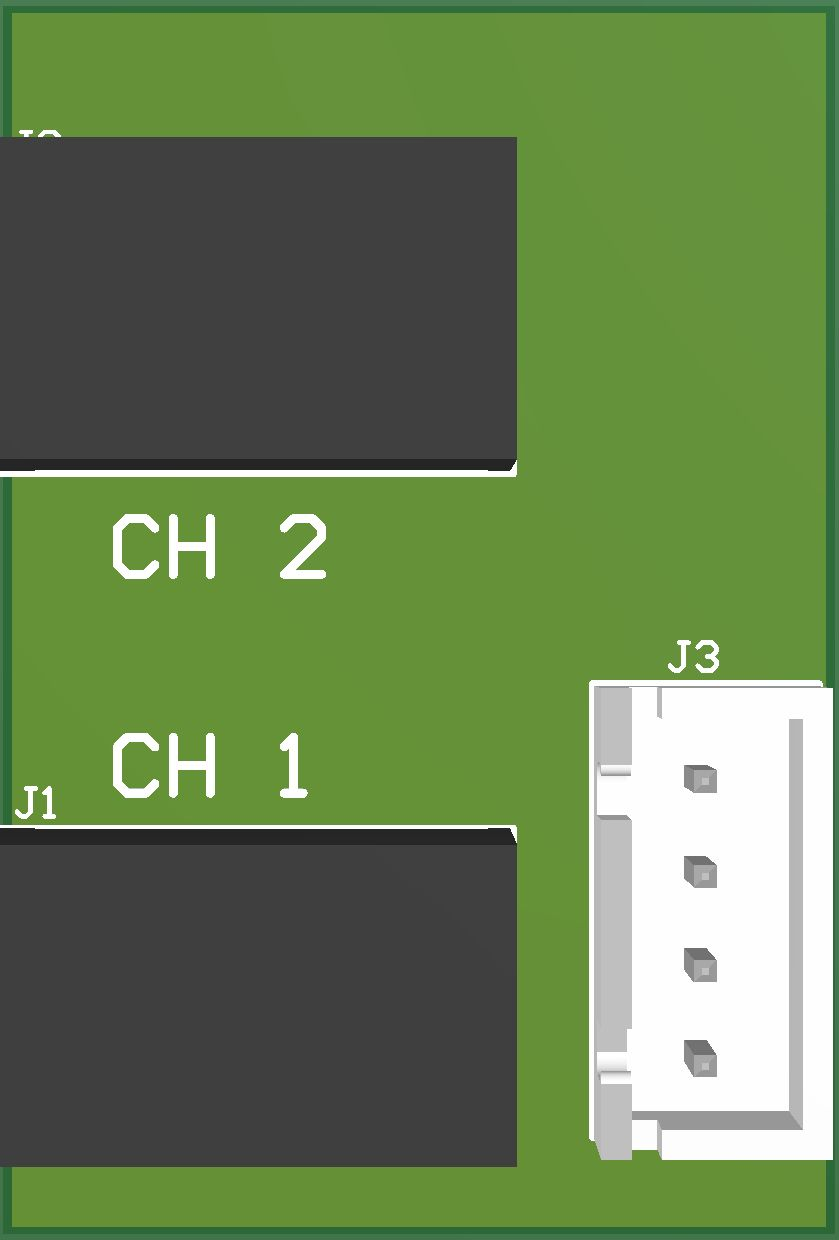
[picture p44: page 6]
