podonoghue/SolderingStation/Resources/Pace Schematic.pdf

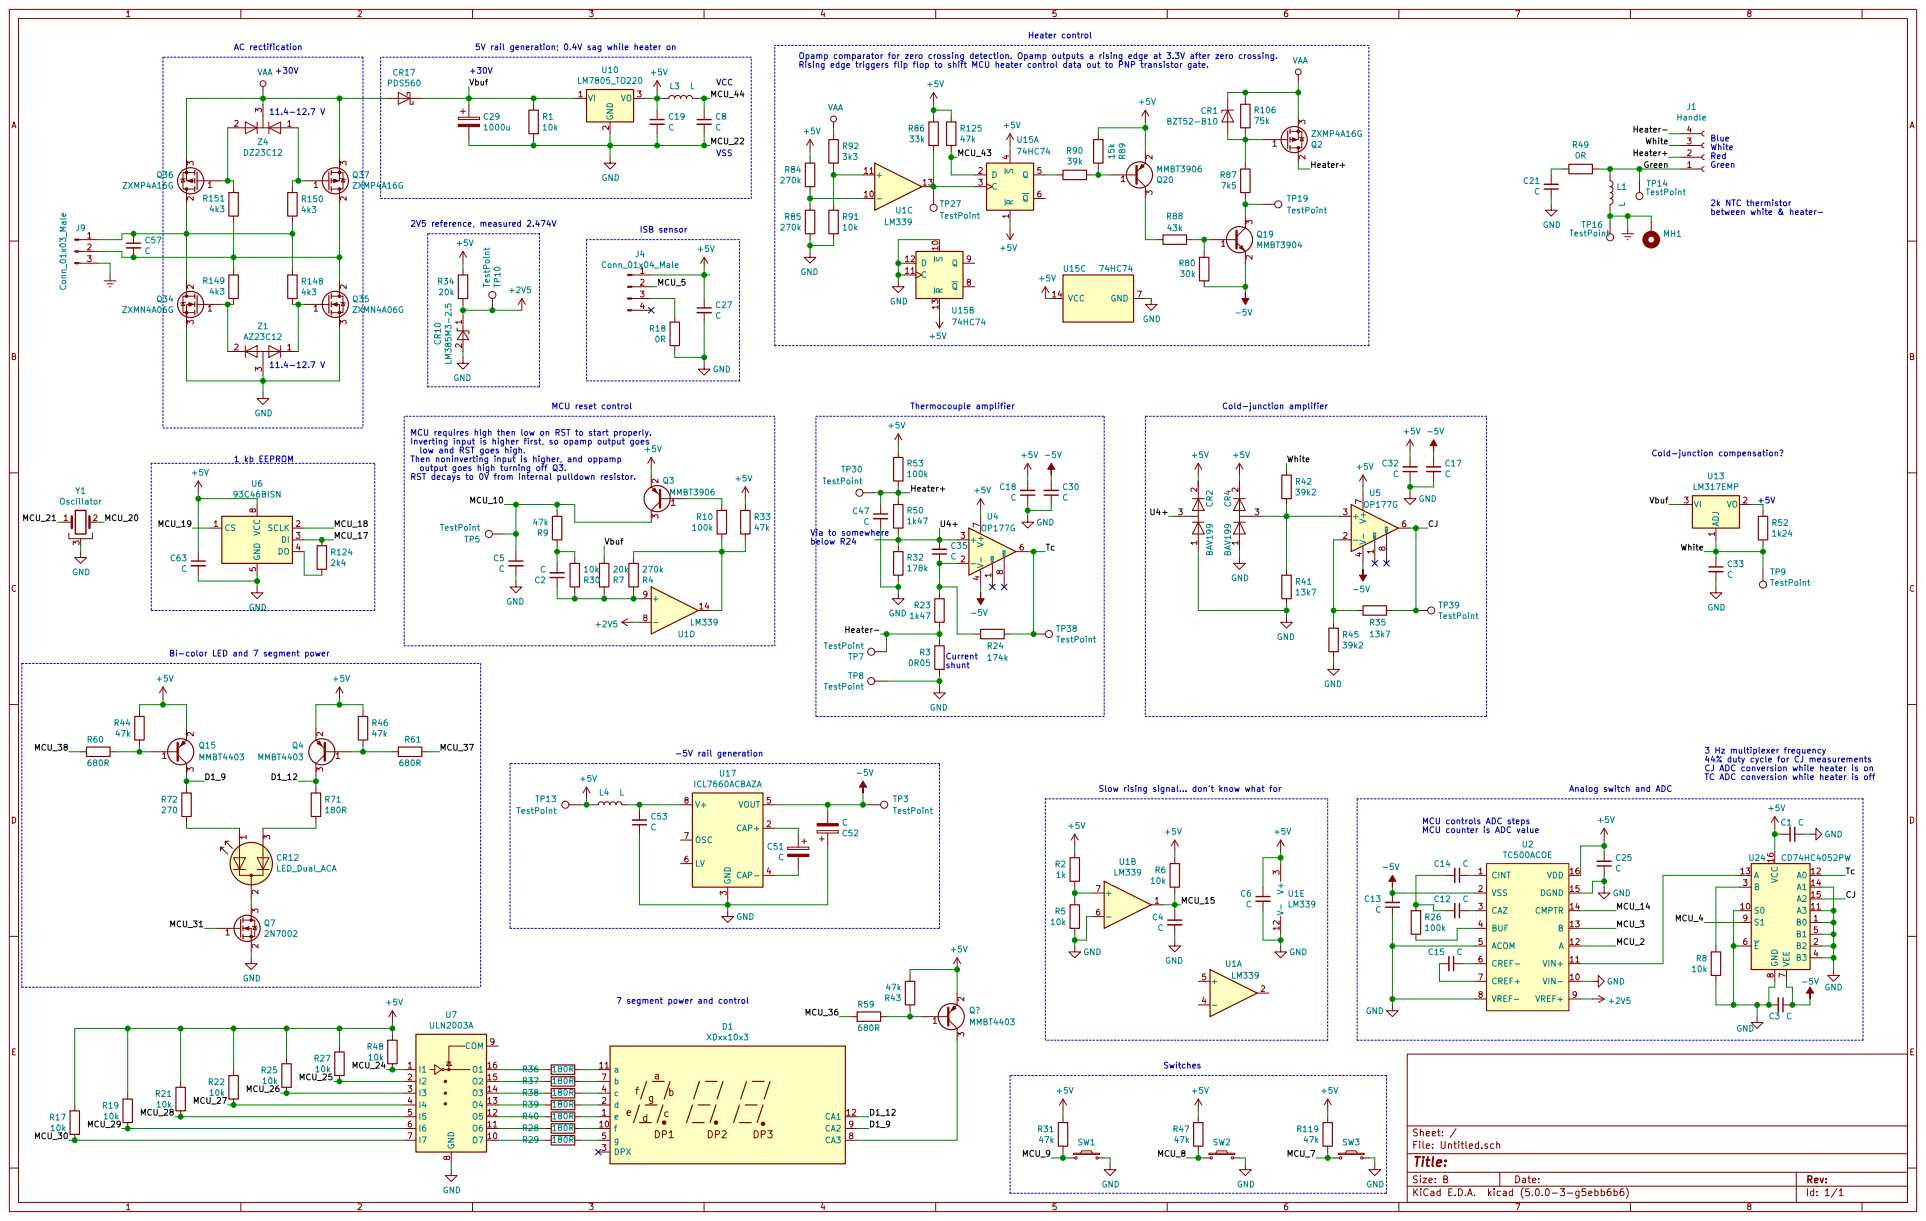
[picture p45: page 1]

3k3 VAA Opamp comparator for zero crossing detection. Opamp outputs a rising edge at 3.3V after zero crossing.
Rising edge triggers flip flop to shift MCU heater control data out to PNP transistor gate.
+5VMCU_44

C27 CMCU_22 C5C MCU_10 GND MCU requires high then low on RST to start properly.

2k NTC thermistor between white & heater- Heater+ R53

Inverting input is higher first, so opamp output goes
low and RST goes high.
Then noninverting input is higher, and oppamp
output goes high turning off Q3.
RST decays to 0V from internal pulldown resistor.

3 Y1 Oscillator MCU_21 MCU_20 CS 1 SCLK 2 DI 3 DO 4 GND

Bi-color LED and 7 segment power

3 Hz multiplexer frequency
44% duty cycle for CJ measurements CJ ADC conversion while heater is on TC ADC conversion while heater is off
+5V GND

Id: 1/1 Title: File: Untitled.sch Sheet: /
