podonoghue/SolderingStation/Resources/WMRT_Schaltbild_R1.00.pdf

D

1 | 2 | 3 | 4

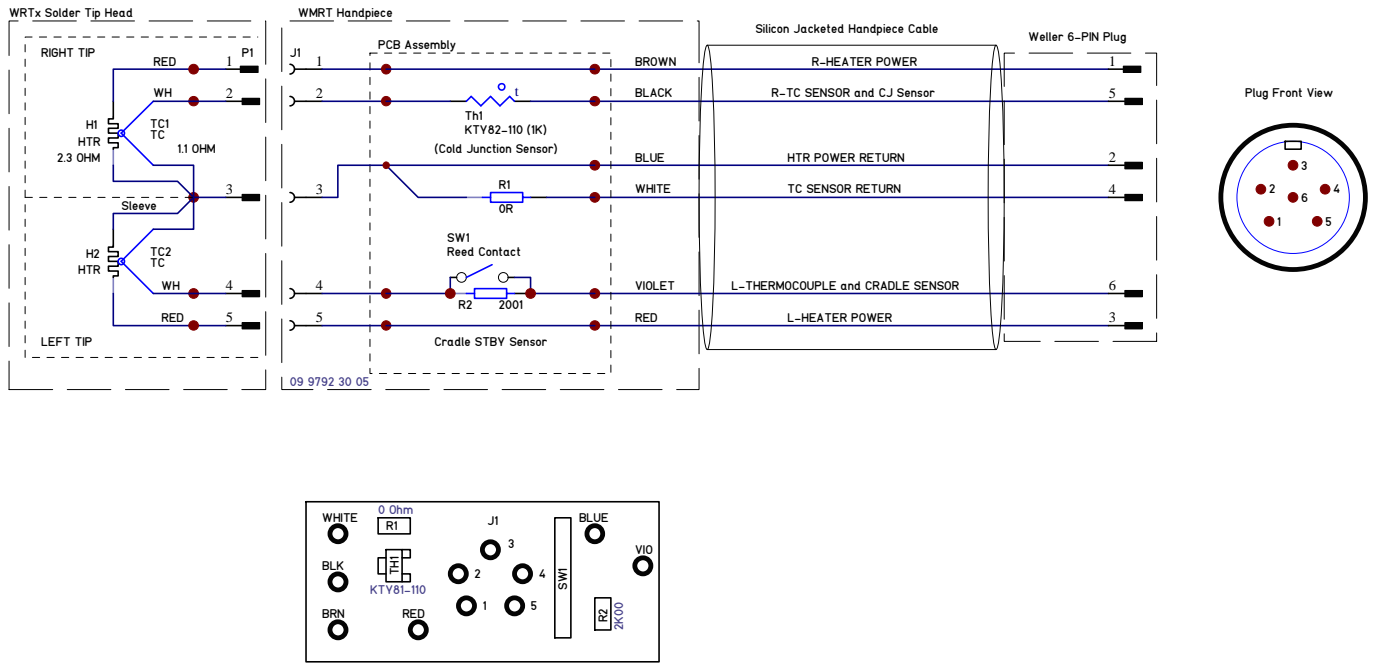
[picture p46: page 1]
GJO; 13028G-WMRT-E01; 5-Jun-2018; WMRT.sch; Size:; Drw. Nr; File:; Rev:; Sheet; Drw. Type:; Scale:; Prj. Nr; Date; Name; Drawn; Modified; Checked; Approval:; Change; PCB Nr.; Used in; Repl.for; Prototype; Production; EMR Technologies; PCB Name: n/a; PCB Type:; Build No.; BOM Done?; H1 HTR; H2 HTR; WRTx Solder Tip Head; WMRT Handpiece; SW1 Reed Contact; Th1 KTY82-110 (1K); BROWN; BLACK; BLUE; WHITE; VIOLET; RED; PCB Assembly; (Cold Junction Sensor); RIGHT TIP; LEFT TIP; 5 BRN; BLK; VIO; 2.3 OHM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

Silicon Jacketed Handpiece Cable

Weller 6-PIN Plug

R-TC SENSOR and CJ Sensor

Plug Front View

HTR POWER RETURN

TC SENSOR RETURN

L-THERMOCOUPLE and CRADLE SENSOR

Cradle STBY Sensor

Unless otherwise specified, all values are as follows:
resistor values are in Ohms, i.e. 0R47, 5R6, 220, 5K6, 22K
capacitor values are in Microfarads, i.e. 220p, 0u1, 2u2, 33
inductor values are in Microhenries, i.e. 0u22, 5u6, 68, 2m2

Title
Weller WMRT Wiring Schematic

11447 - 111A Ave
Edmonton, Alberta, Canada,

This drawing is our property. Duplication,
unauthorized use of any kind is prohibited.

Notification Nr. Index

Without Approval use only for inquiry.

Requires TGL-017 Font
