podonoghue/SolderingStation/Resources/weller_driver_v11_circuit_diagram.pdf

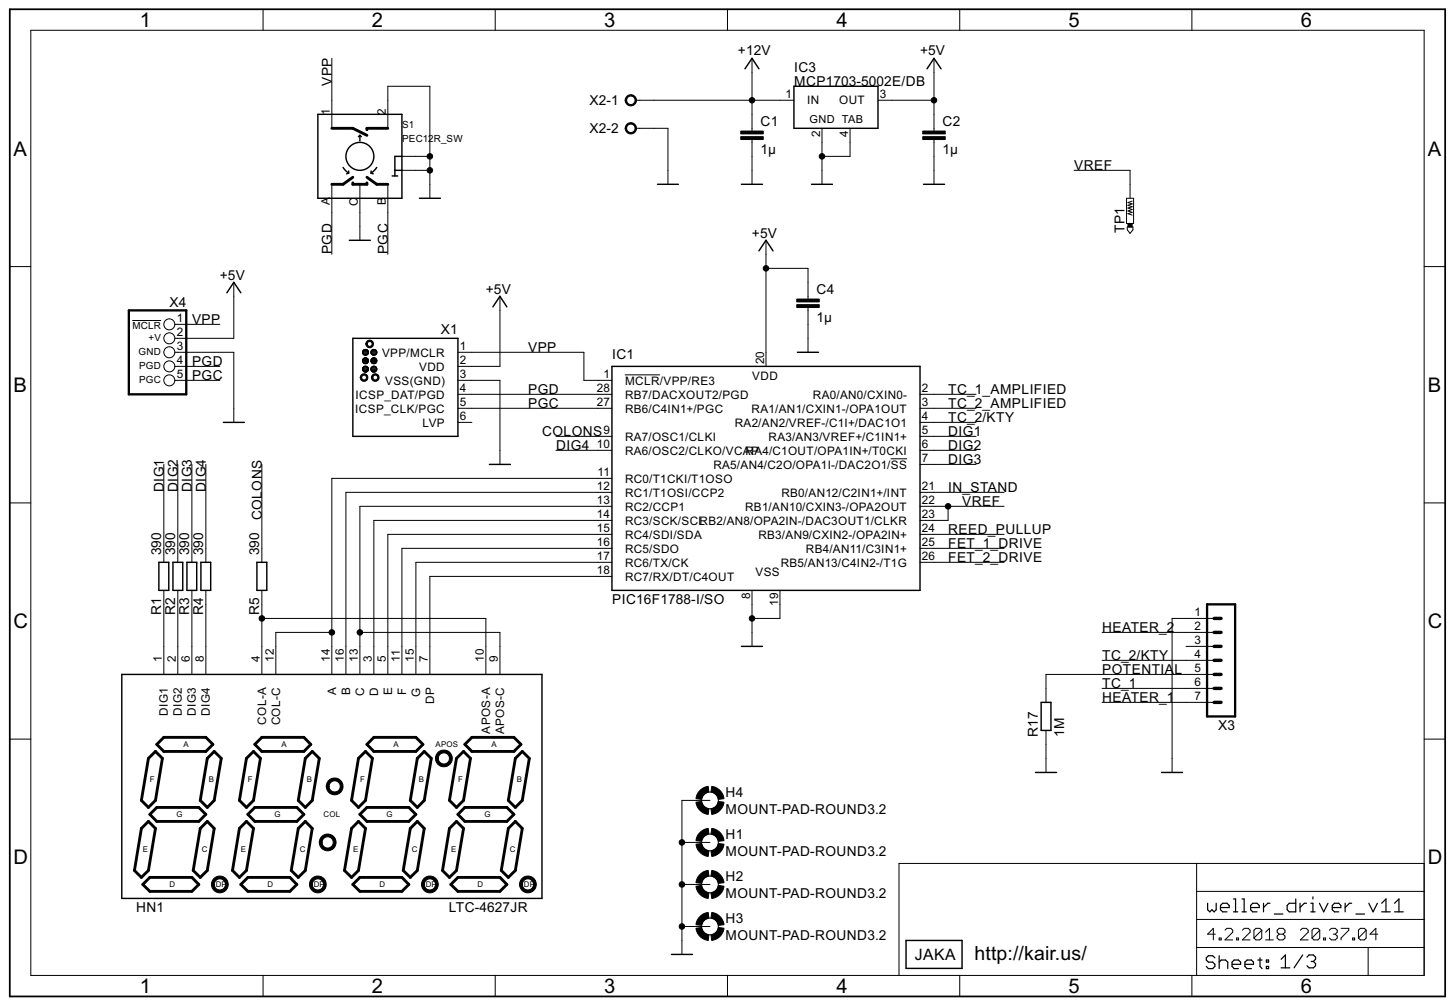
[picture p47: page 1]

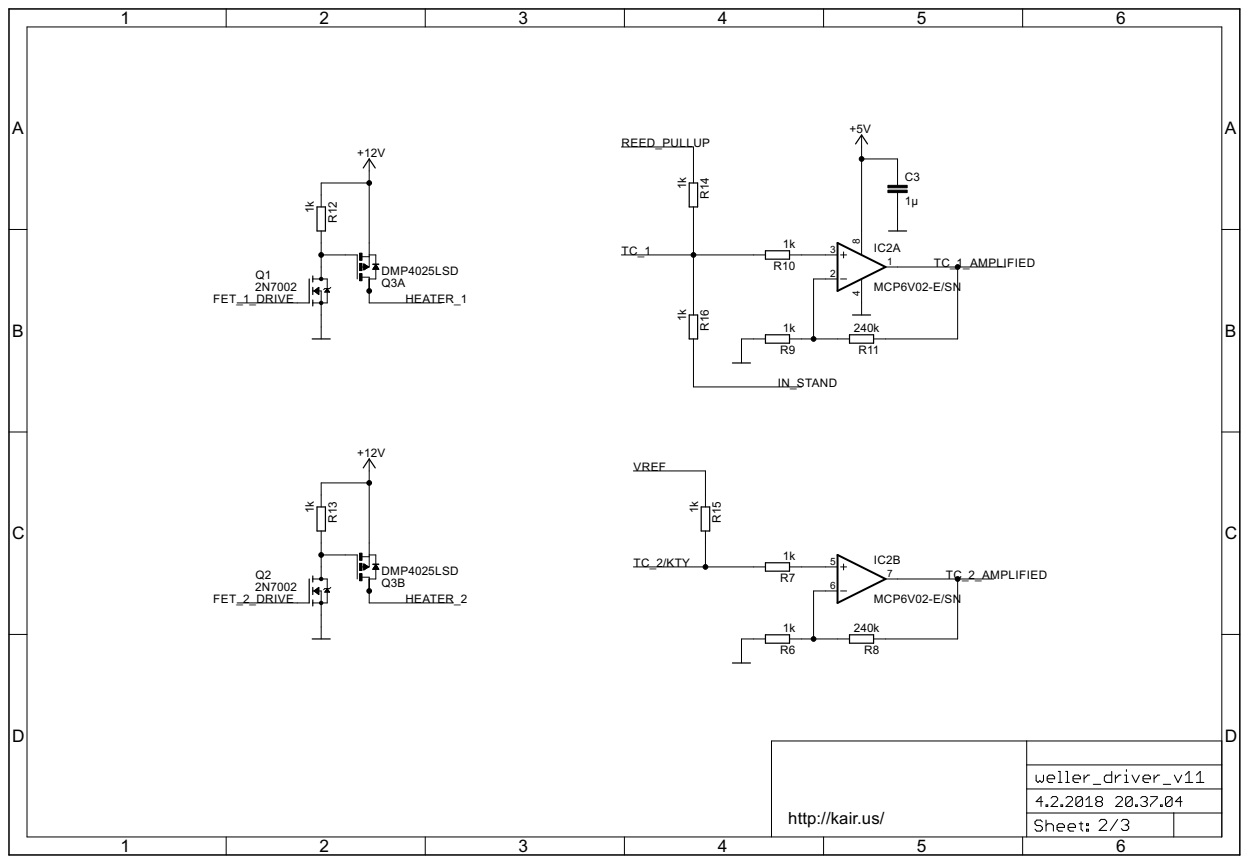
[picture p48: page 2]

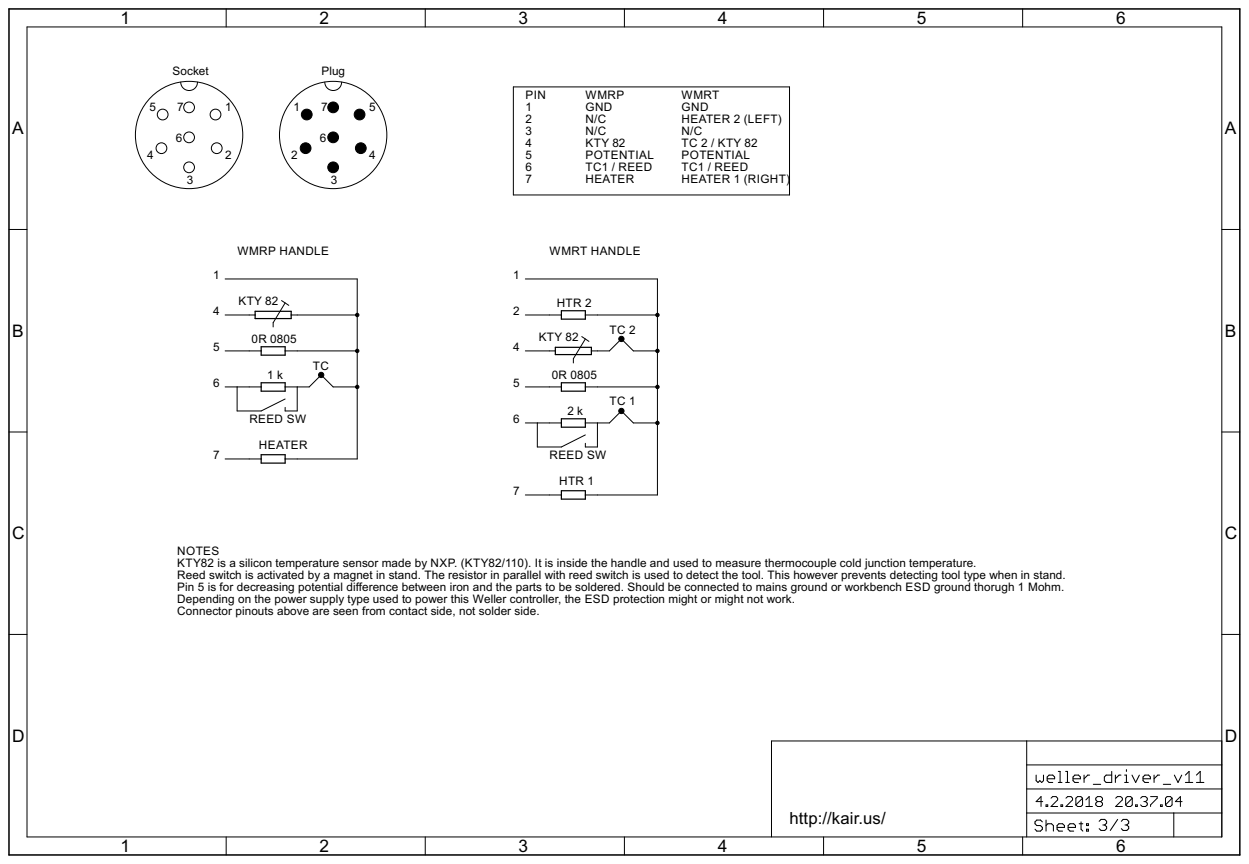
[picture p49: page 3]

Plug

NOTES
KTY82 is a silicon temperature sensor made by NXP. (KTY82/110). It is inside the handle and used to measure thermocouple cold junction temperature.
Reed switch is activated by a magnet in stand. The resistor in parallel with reed switch is used to detect the tool. This however prevents detecting tool type when in stand. Pin 5 is for decreasing potential difference between iron and the parts to be soldered. Should be connected to mains ground or workbench ESD ground thorugh 1 Mohm. Depending on the power supply type used to power this Weller controller, the ESD protection might or might not work. Connector pinouts above are seen from contact side, not solder side.
