podonoghue/SolderingStation/PCB_Controller_V4/TipWiring_alt.pdf

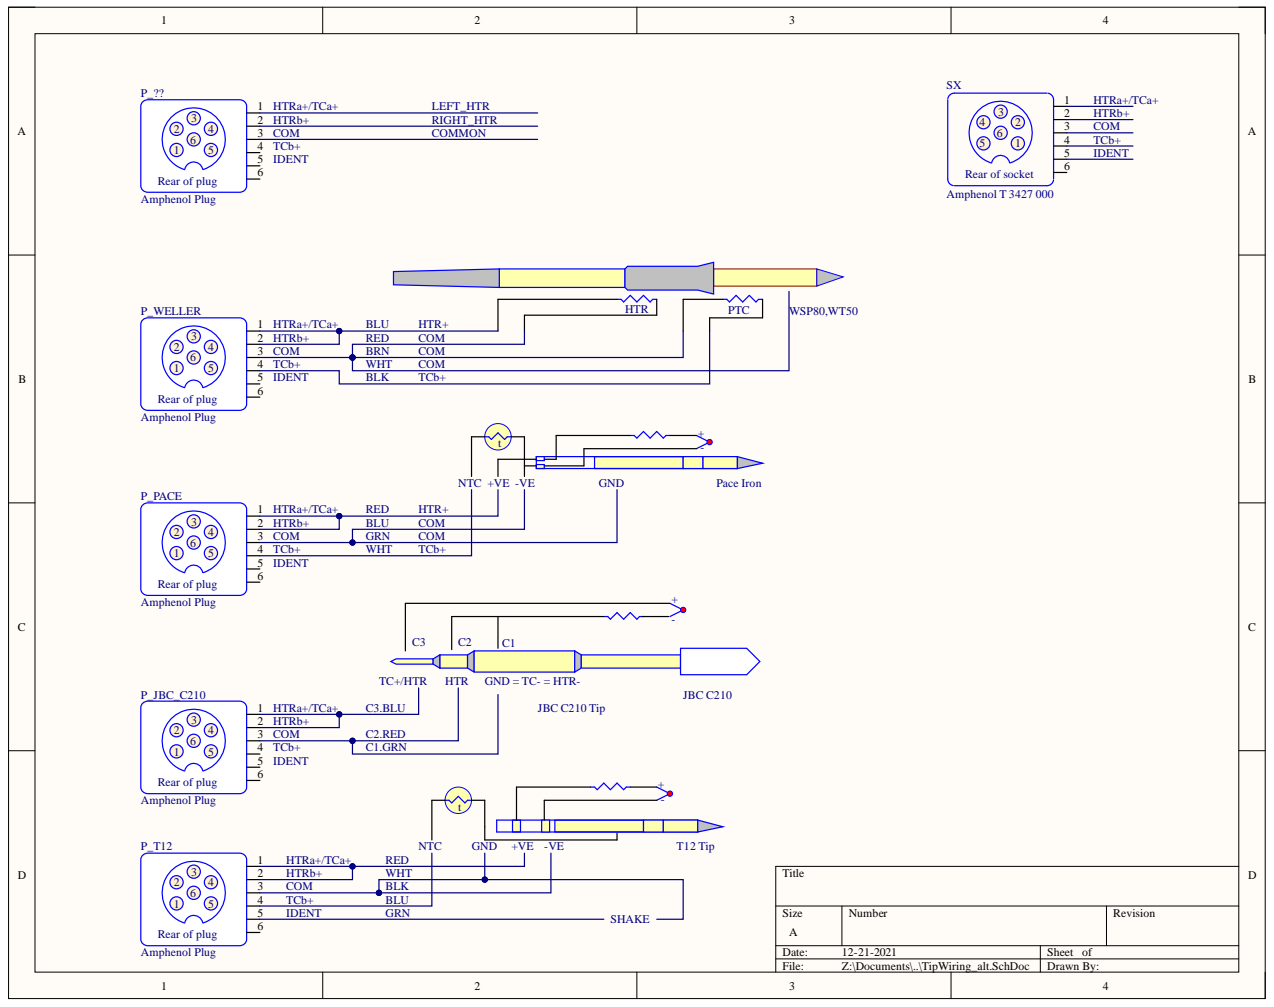
[picture p50: page 1]

Size A | Number | Revision

Date: 12-21-2021 | Sheet of
File: Z:\Documents\..\TipWiring_alt.SchDoc | Drawn By:
