podonoghue/SolderingStation/Simulation/Rectifier Schematic.pdf

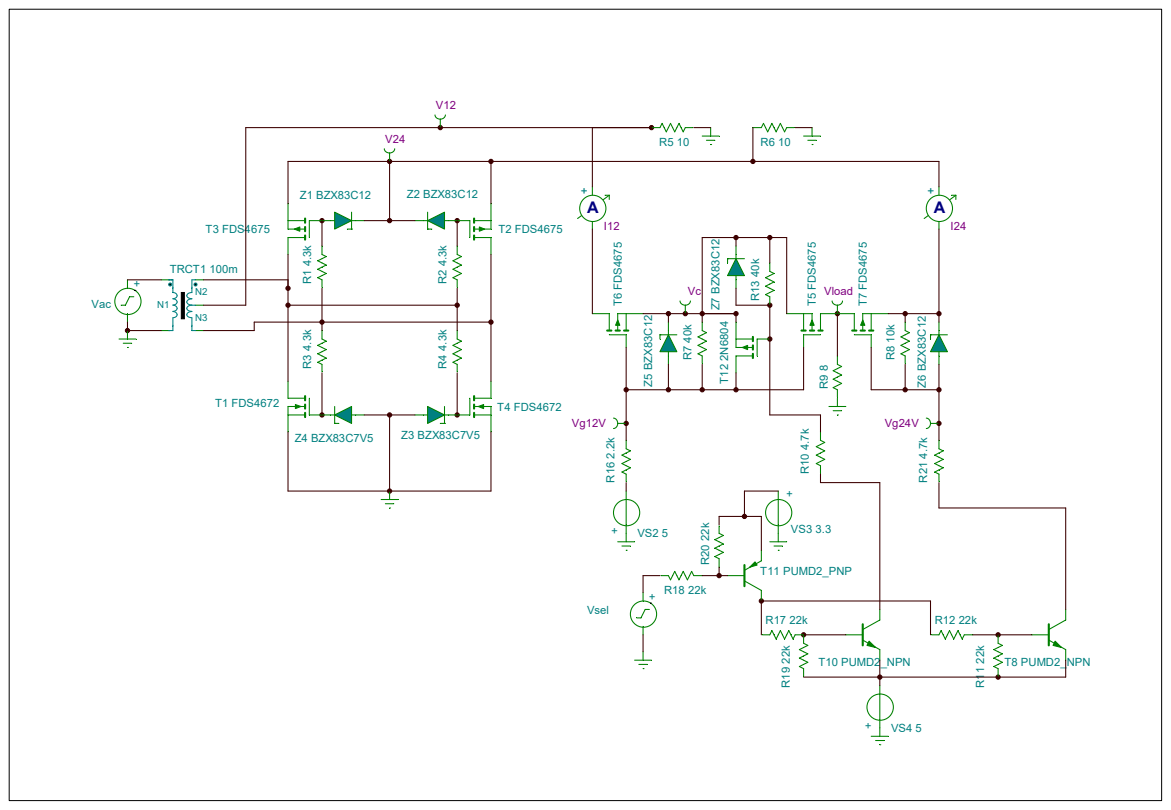
[picture p51: page 1]
