podonoghue/SolderingStation/PCB_Rectifier/SynchronousRectifier.PDF

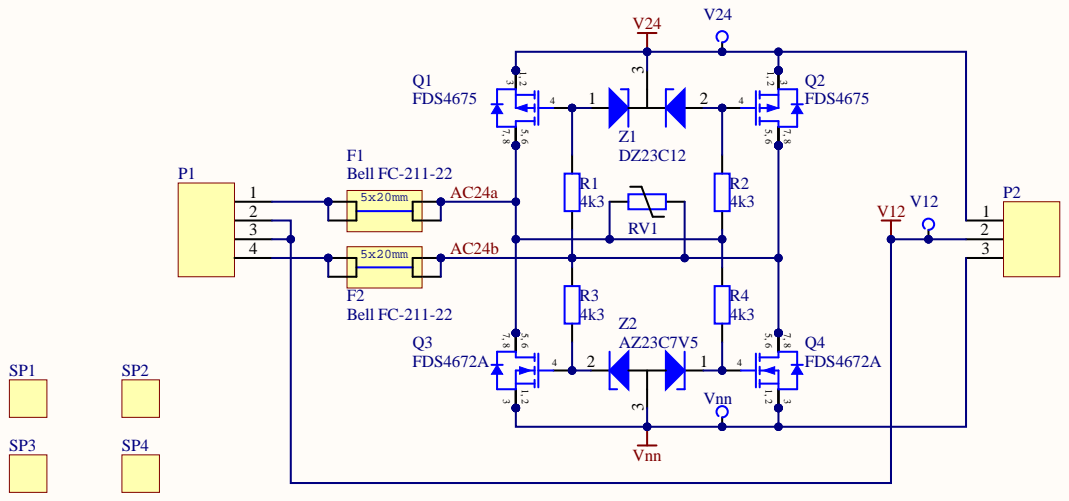
[picture p52: page 1]

Size A | Numbe r | Revision 1.0

Date: 12-05-2021 | Sheet of
File: Z:\Documents\..\SynchronousRectifier . S chDrawn oc | By:

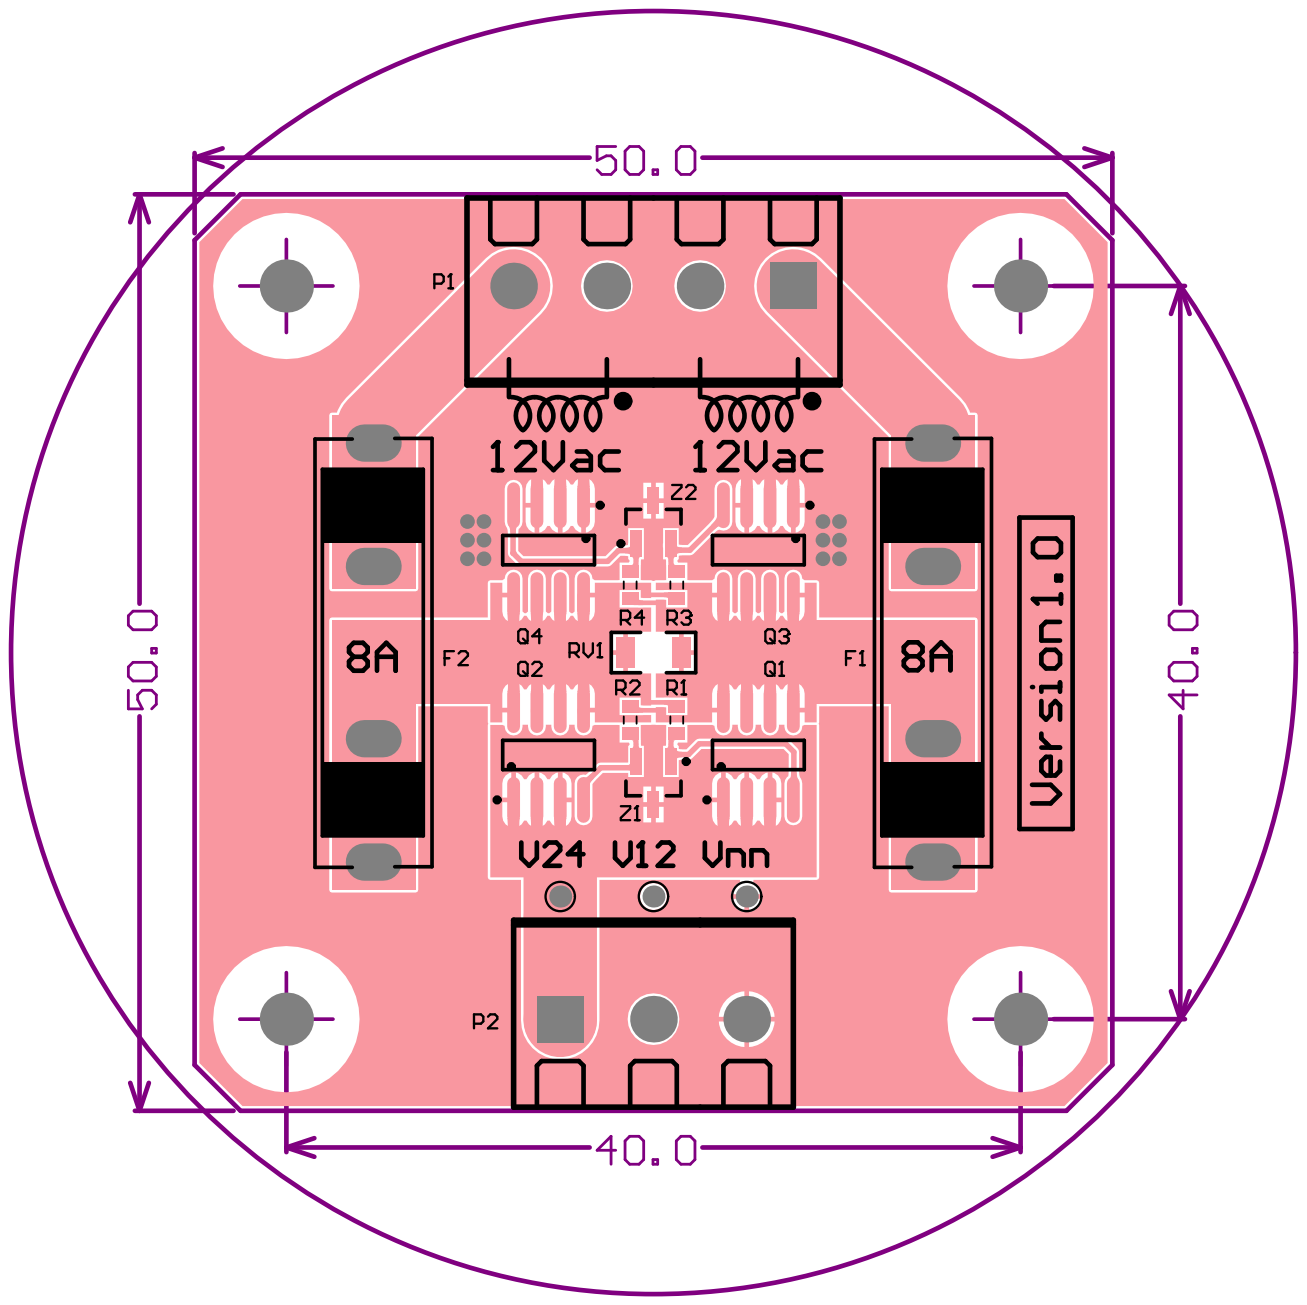
[picture p53: page 2]

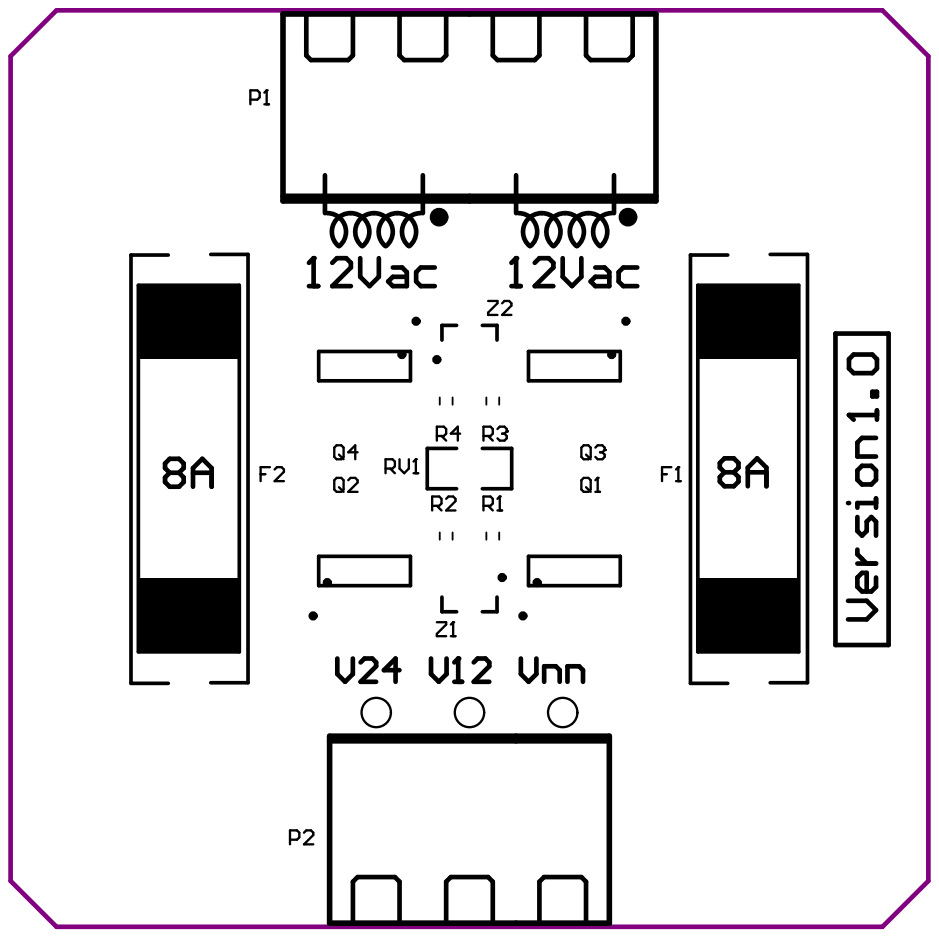
[picture p54: page 3]

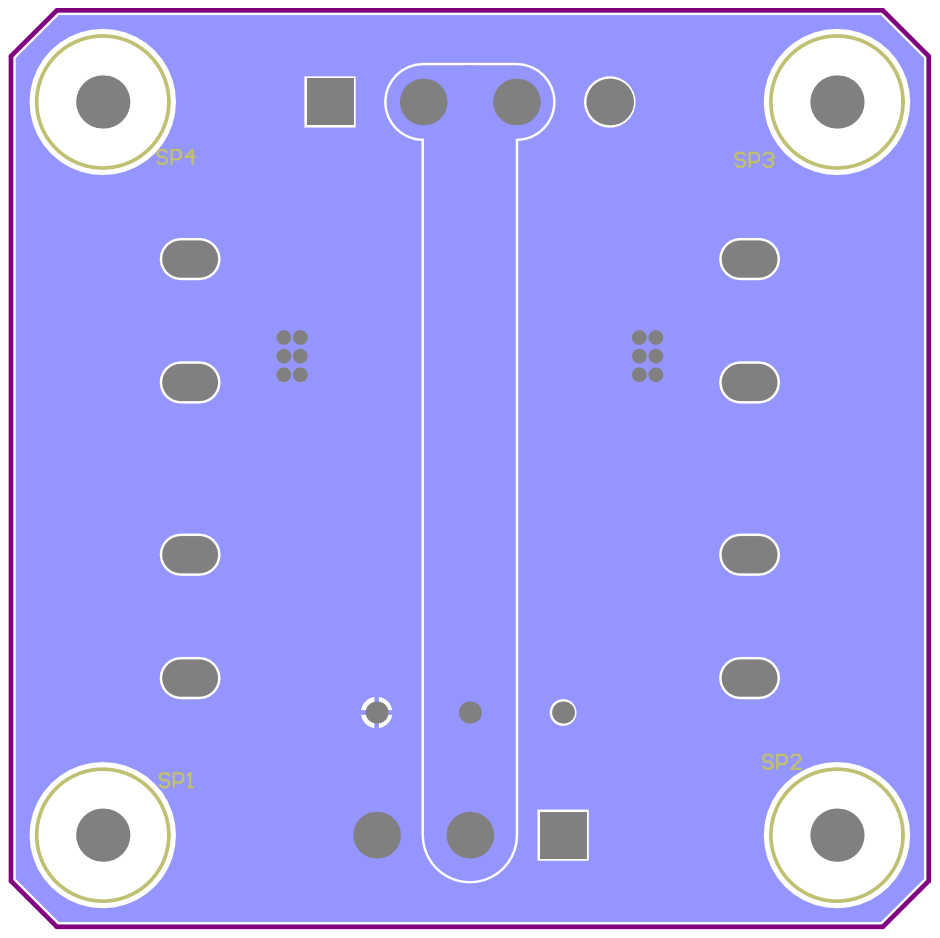
[picture p55: page 4]

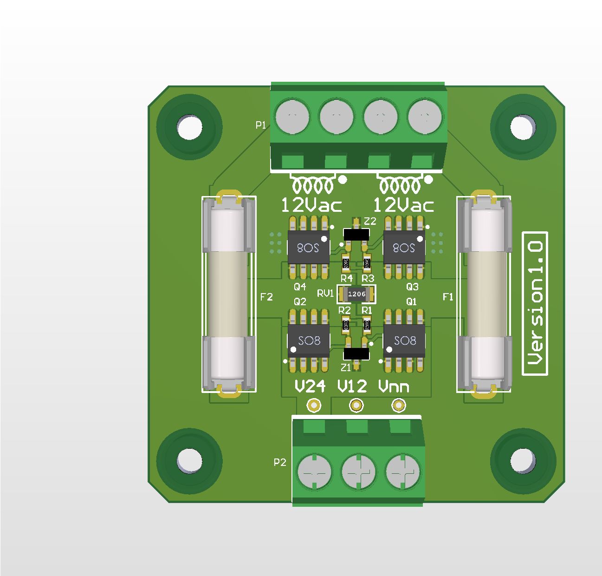
[picture p56: page 5]
