podonoghue/SolderingStation/PCB_Quad/QuadSwitch.PDF

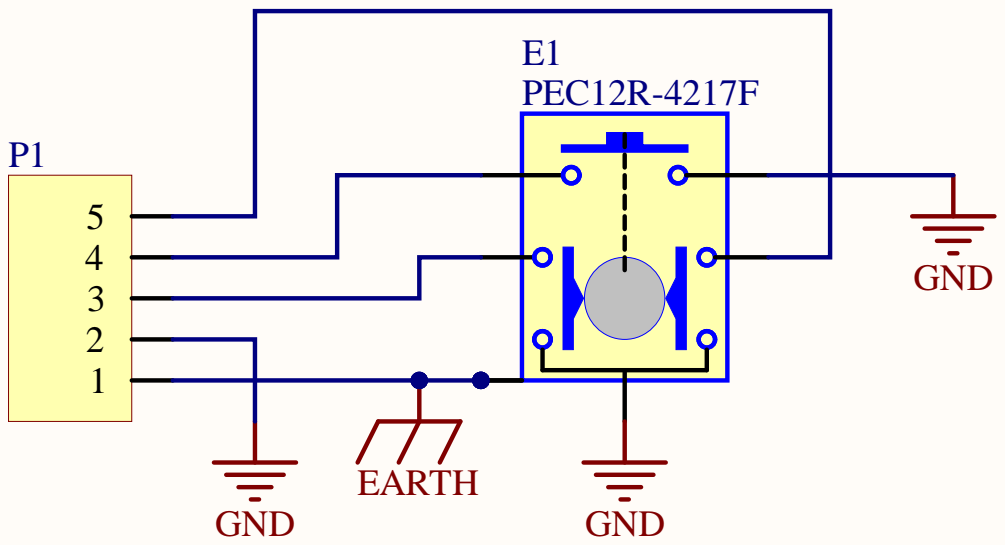
[picture p57: page 1]

Size A | Numbe r | Revision

Date: 7/27/2021 | Sheet of
File: Z:\Documents\..\QuadSwitch.S chDoc | Drawn By:

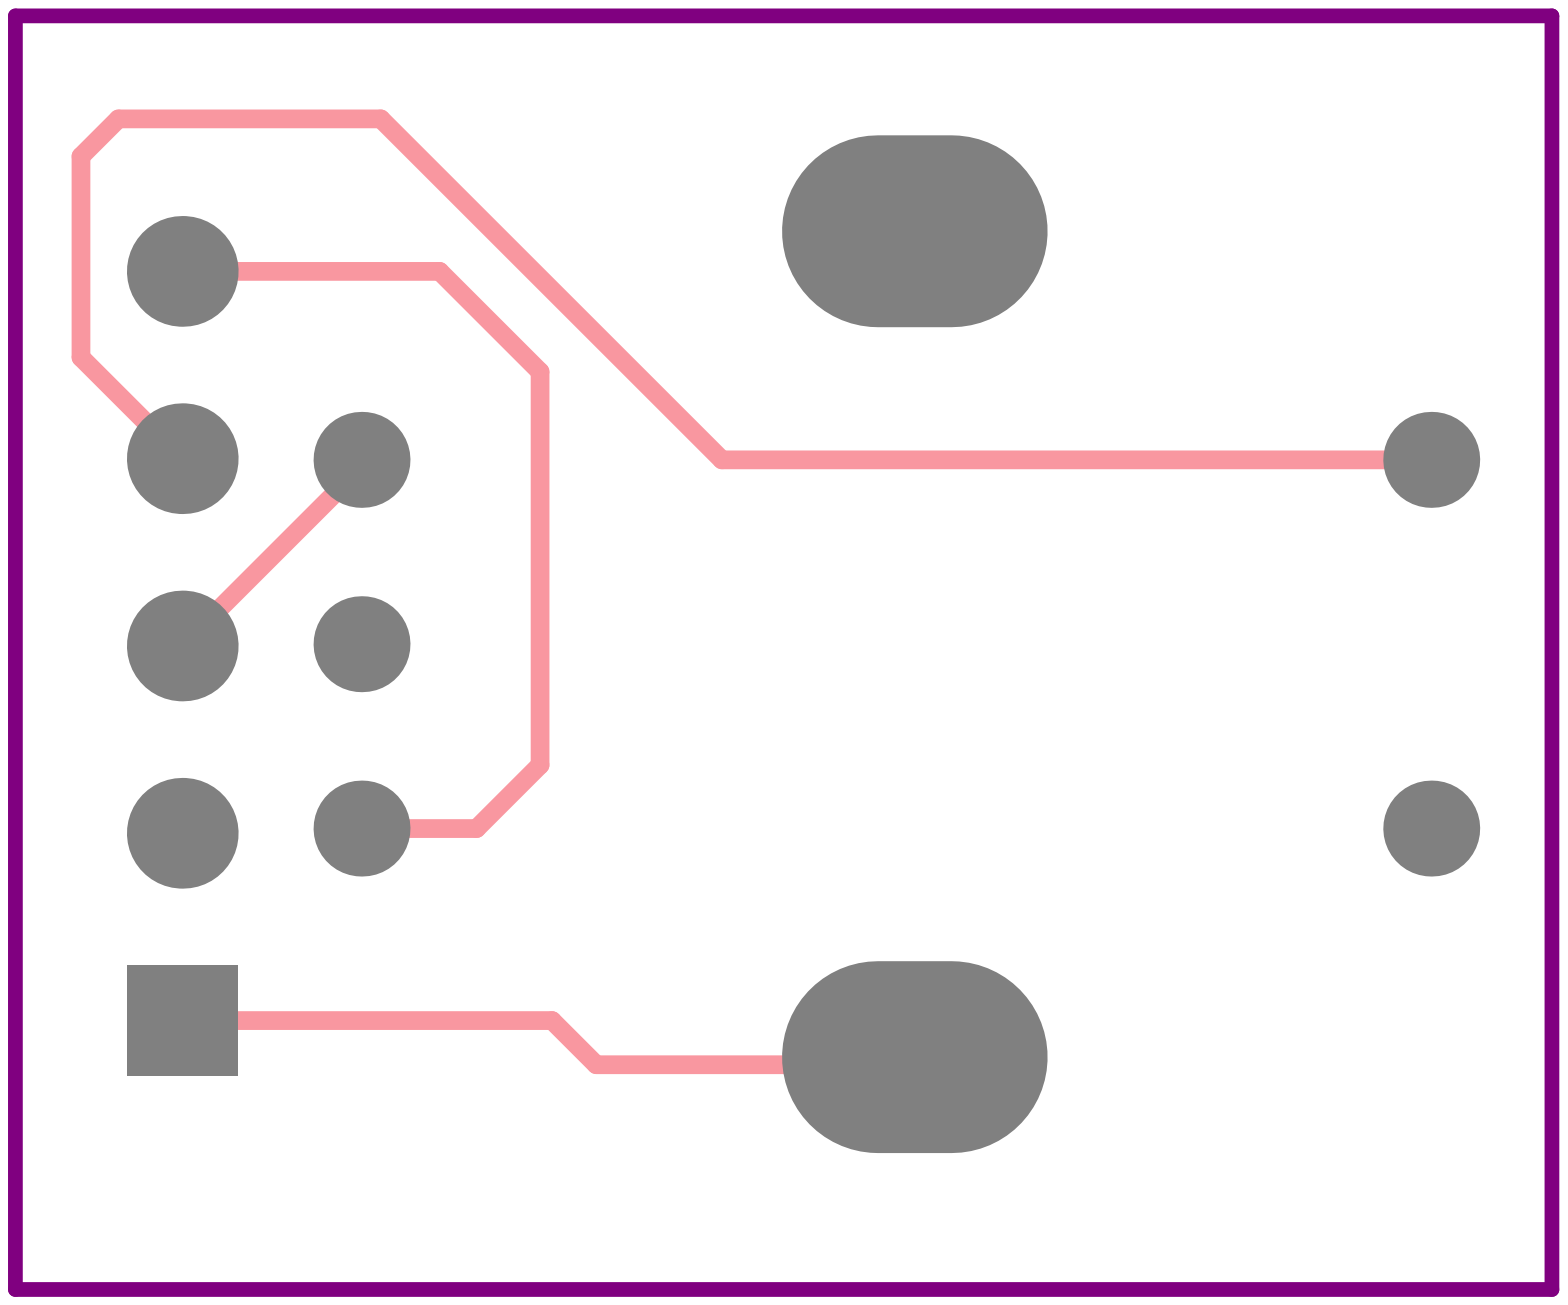
[picture p58: page 2]

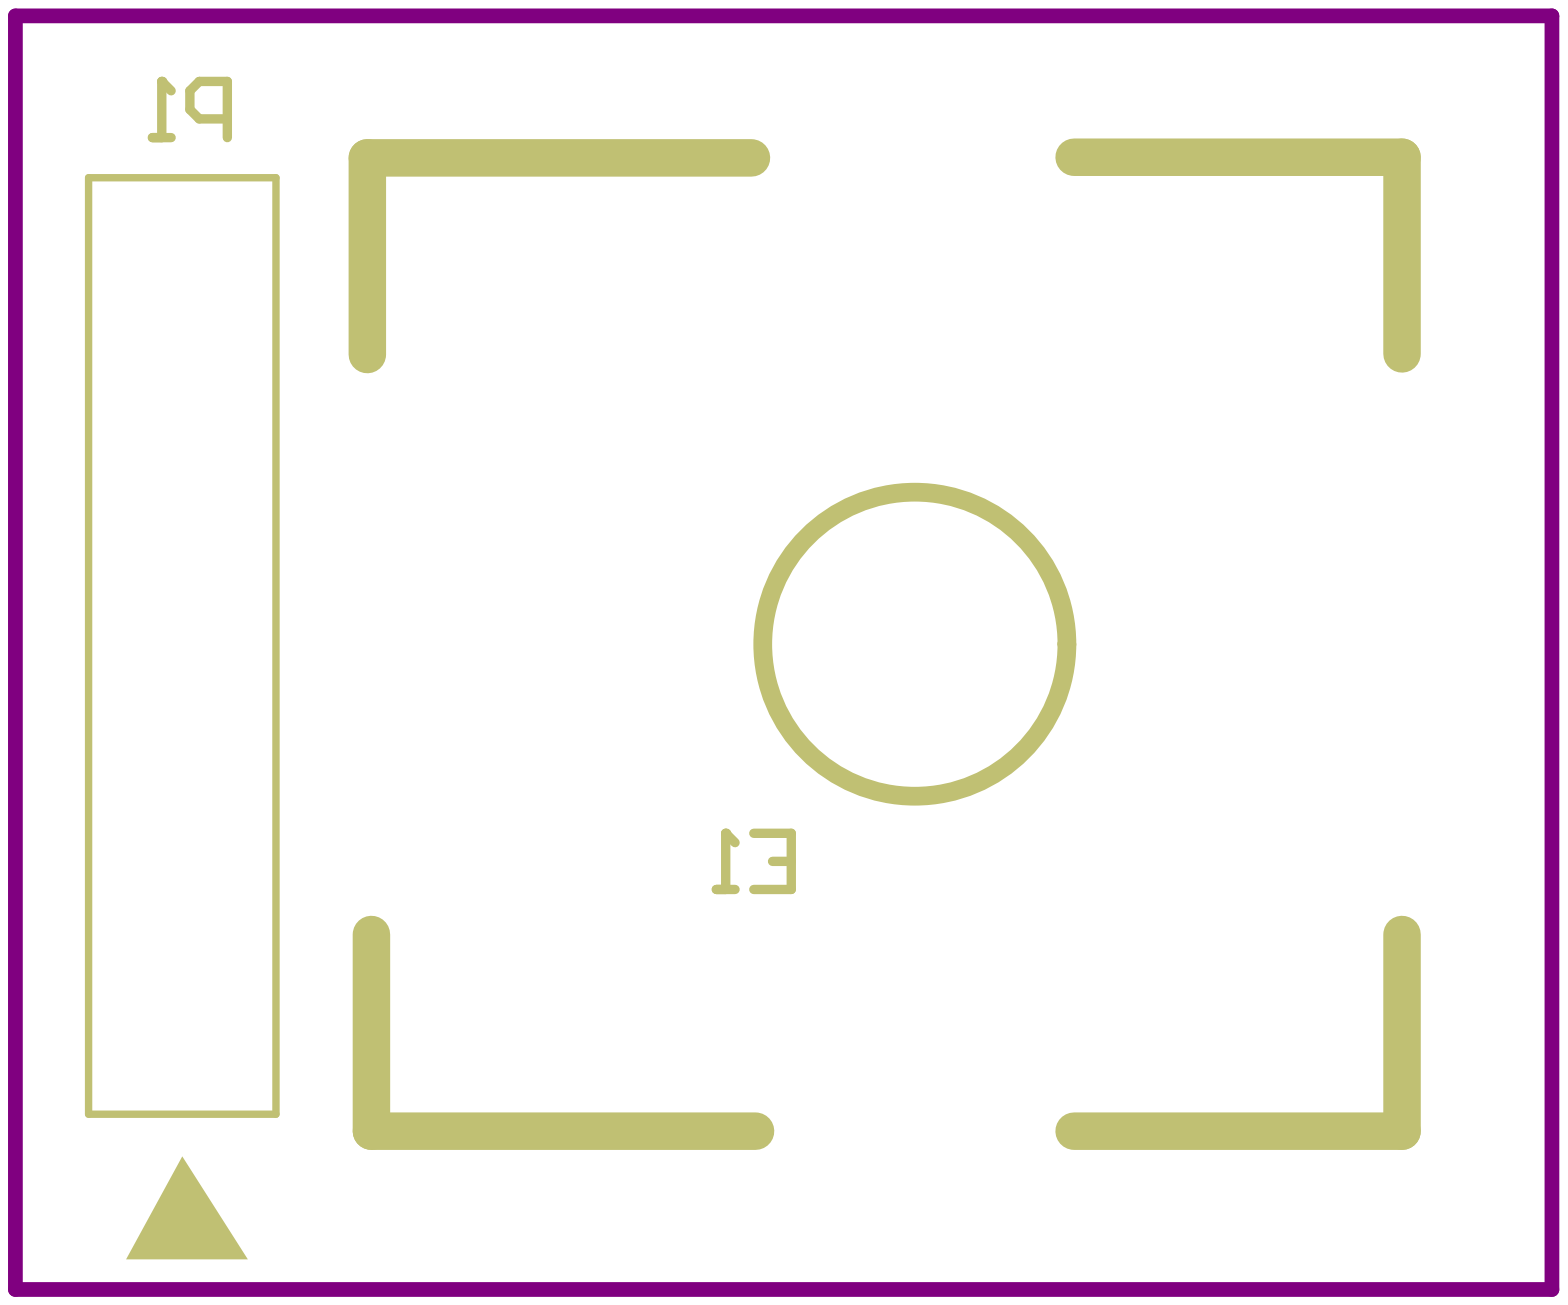
[picture p59: page 3]

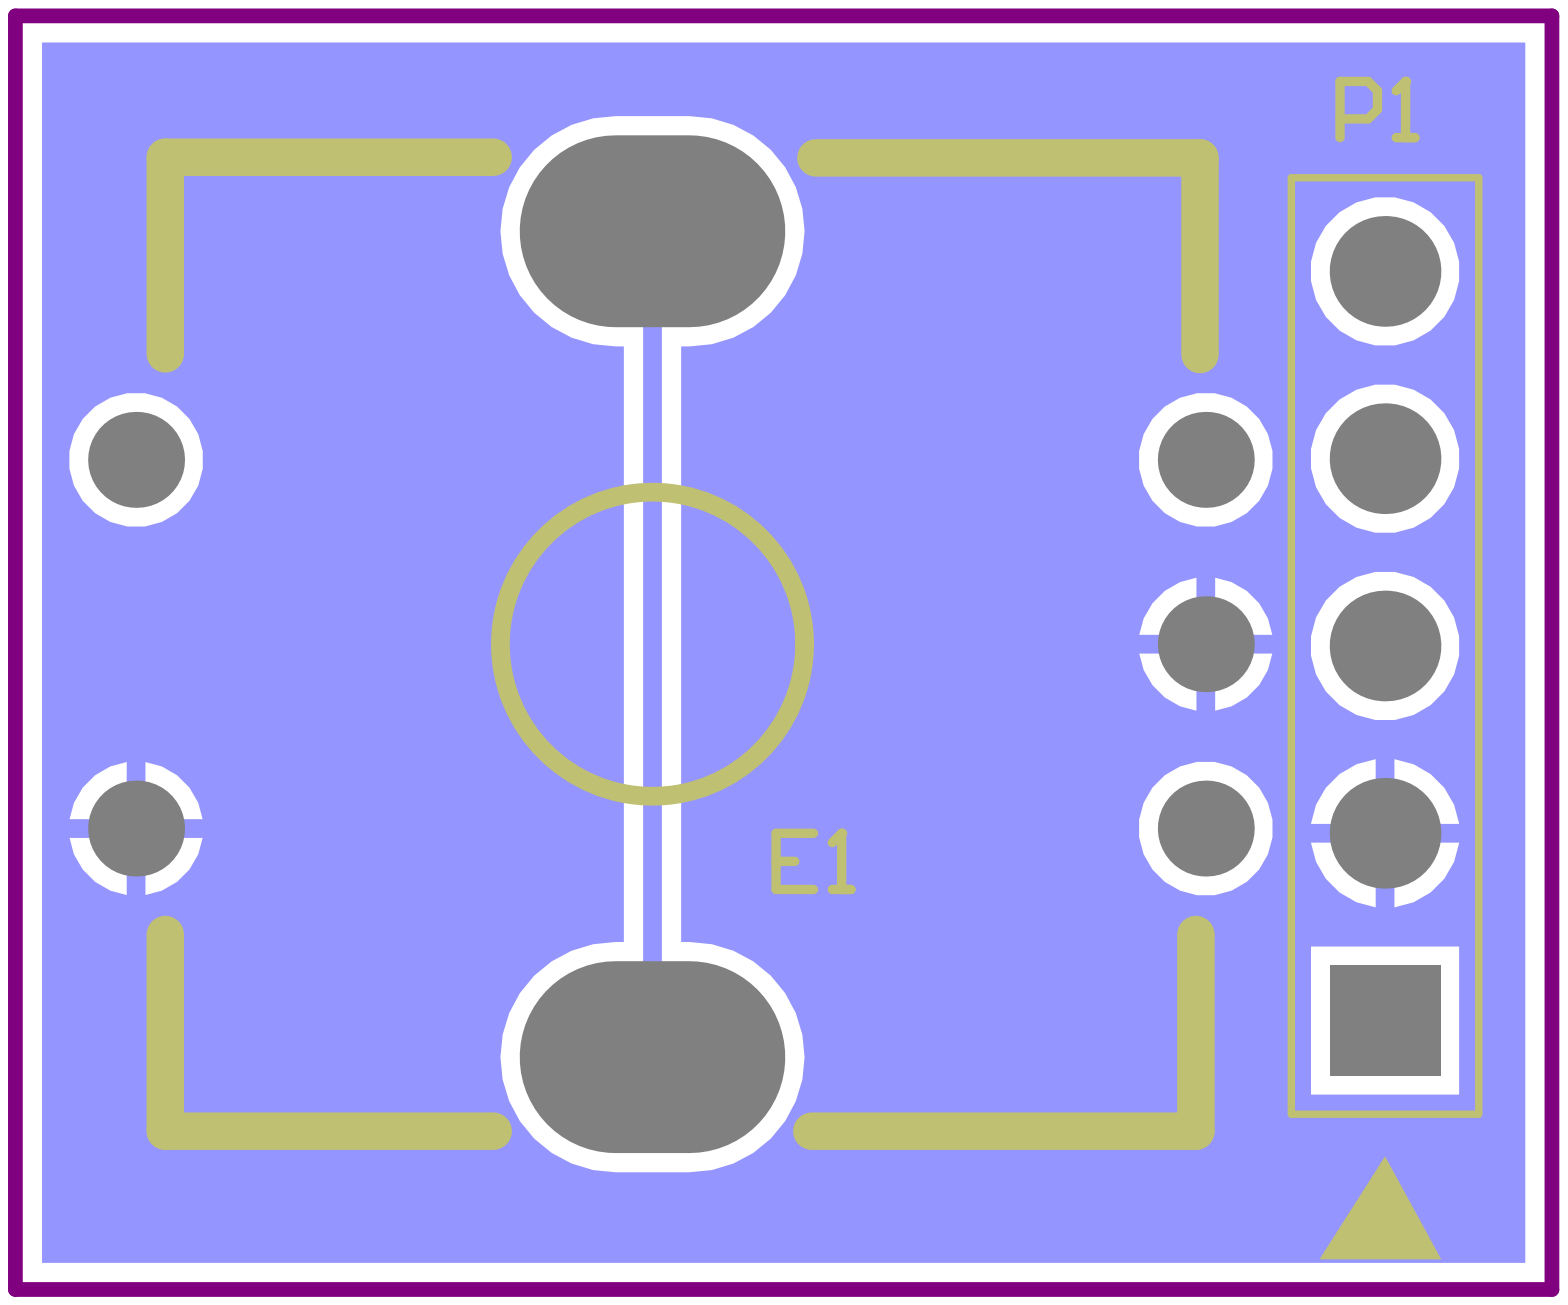
[picture p60: page 4]

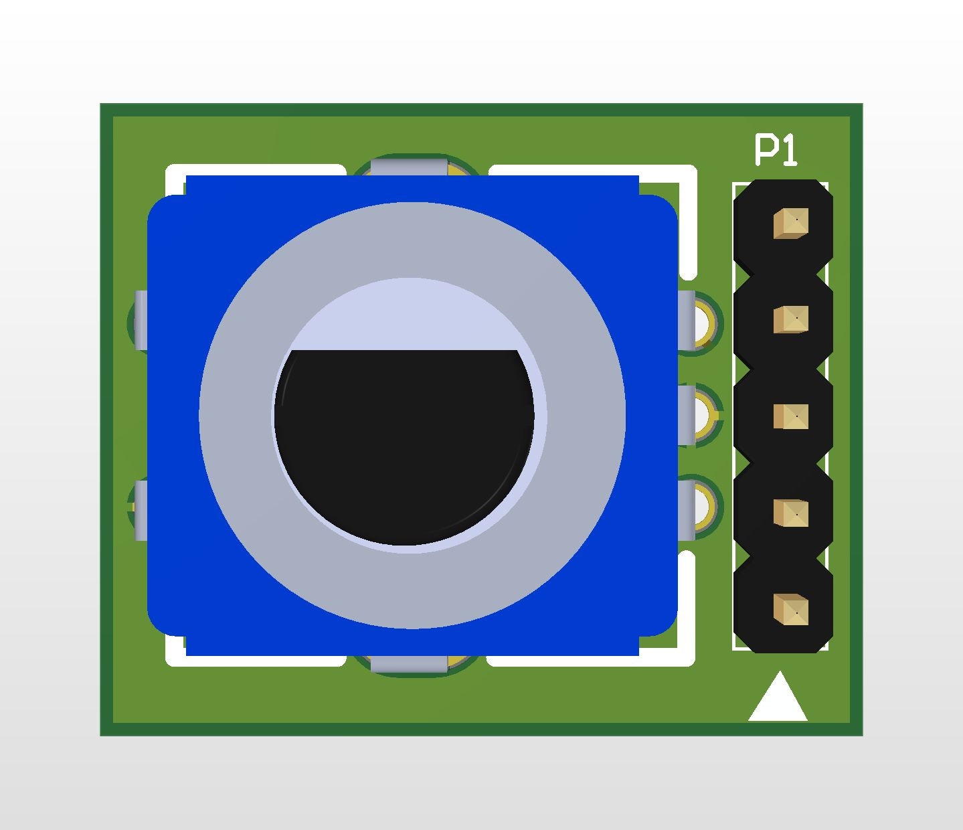
[picture p61: page 5]
