podonoghue/SolderingStation/(list of files, drawings)

Other design files:
FrontPanel/FrontPanel.PcbDoc
FrontPanel/FrontPanel.PrjPcb
PCB_Controller/SolderingStation.PrjPcb
PCB_Controller/SolderingStation_Control.SchDoc
PCB_Controller/SolderingStation_Power.SchDoc
PCB_Controller/SolderingStation_Processor.SchDoc
PCB_Controller_V4/SolderingStation_Control.SchDoc
PCB_Controller_V4/SolderingStation_Power.SchDoc
PCB_Controller_V4/SolderingStation_Processor.SchDoc
PCB_Controller_V4/SolderingStation_V4.PrjPcb
PCB_Controller_V4/TipWiring.SchDoc
PCB_Controller_V4/TipWiring_alt2.SchDoc
PCB_Controller_V4/TipWiring_alt.SchDoc
PCB_Quad/Quad.PrjPcb
PCB_Quad/QuadSwitch.PcbDoc
PCB_Quad/QuadSwitch.SchDoc
PCB_Rectifier/SynchronousRectifier.PcbAscii.PcbDoc
PCB_Rectifier/SynchronousRectifier.PcbDoc
PCB_Rectifier/SynchronousRectifier.PrjPcb
PCB_Rectifier/SynchronousRectifier.SchDoc
PCB_Rectifier/SynchronousRectifier_ASCII.PcbDoc
PCB_Setback/Setback.PcbDoc
PCB_Setback/Setback.PrjPcb
PCB_Setback/Setback.SchDoc
