podonoghue/SolderingStation/Software/SolderingStation_V4_MK20M7/Sources/oled.cpp

/*
 * Oled.cpp
 *
 *  Created on: 31 Oct 2019
 *      Author: podonoghue
 *
 *  Based loosely on Adafruit library (initialisation sequences and constants)
 */
#include <malloc.h>
#include <memory.h>
#include "oled.h"

using namespace USBDM;

// Control byte
//static constexpr uint8_t SINGLE_COMMAND    = 0b10000000; ///< Co=1, D/C=0: Byte(s) are command data followed by another control byte
static constexpr uint8_t MULTIPLE_COMMANDS = 0b00000000; ///< Co=0, D/C=0: Byte(s) are command data until I2C stop
static constexpr uint8_t MULTIPLE_GDRAM    = 0b01000000; ///< Co=0, D/C=1: Byte(s) are graphic data until I2C stop

/**
 * Clear internal frame buffer
 * The OLED is not affected until refreshImage() is called.
 */
Oled &Oled::clearDisplay(void) {
   memset((uint8_t *)&buffer, 0, sizeof(buffer));

   x = 0;
   y = 0;
   fontHeight = 0;

   return *this;
}

/**
 * Initialise OLED peripheral
 *
 * @note   This function must be called before any drawing or updates!
 * @note   Based loosely on Adafruit library initialisation sequence
 */
void Oled::initialise() {

   clearDisplay();

   // Initialise sequence
   static const uint8_t init1[] = {
         MULTIPLE_COMMANDS,                    // Co = 0, D/C = 0
         SSD1306_DISPLAYOFF,                   // 0xAE
         SSD1306_SETDISPLAYCLOCKDIV,           // 0xD5
         0x80,                                 // = Reset value (105Hz)
         SSD1306_SETMULTIPLEX,                 // 0xA8
         (HEIGHT - 1),
         SSD1306_SETDISPLAYOFFSET,             // 0xD3
         0x0,                                  // = Reset value, no offset
         SSD1306_SETSTARTLINE | 0x0,           // 0x40 - line #0
         SSD1306_CHARGEPUMP,                   // 0x8D
         ((VCC_CONTROL == OledVccControl_External) ? 0x10 : 0x14),
         SSD1306_MEMORYMODE,                   // 0x20
         0x00,                                 // Horizontal addressing mode
         SSD1306_SEGREMAP | 0x1,               // 0xA0 | 0x01 map col127->SEG0
         SSD1306_COMSCANDEC | 0x8,             // 0xC0 | 0x8  scan COM[N-1] -> COM0
         SSD1306_COLUMNADDR,                   // 0x21
         0,                                    // first column
         (WIDTH-1),                            // last column
         SSD1306_PAGEADDR,                     // 0x22
         0,                                    // first page
         (((HEIGHT+7)/8)-1),                   // last page
   };
   i2c.transmit(I2C_ADDRESS, init1);

   if constexpr ((WIDTH == 128) && (HEIGHT == 32)) {

      static const uint8_t init4a[] = {
            MULTIPLE_COMMANDS,                    // Co = 0, D/C = 0
            SSD1306_SETCOMPINS,                   // 0xDA
            0x02,                                 // = default
            SSD1306_SETCONTRAST,                  // 0x81
            0x10,
      };
      i2c.transmit(I2C_ADDRESS, init4a);

   } else if constexpr ((WIDTH == 128) && (HEIGHT == 64)) {

      static const uint8_t init4b[] = {
            MULTIPLE_COMMANDS,                    // Co = 0, D/C = 0
            SSD1306_SETCOMPINS,                   // 0xDA
            0x12,
            SSD1306_SETCONTRAST,                  // 0x81
            ((VCC_CONTROL == OledVccControl_External) ? 0x9F : 0xCF),
      };
      i2c.transmit(I2C_ADDRESS, init4b);

   } else if constexpr ((WIDTH == 96) && (HEIGHT == 16)) {

      static const uint8_t init4c[] = {
            MULTIPLE_COMMANDS,                    // Co = 0, D/C = 0
            SSD1306_SETCOMPINS,                   // 0xDA
            0x2,    // ada x12
            SSD1306_SETCONTRAST,                  // 0x81
            ((VCC_CONTROL == OledVccControl_External) ? 0x10 : 0xAF),
      };
      i2c.transmit(I2C_ADDRESS, init4c);
   } else {
      // Other screen varieties -- TBD
   }

   static const uint8_t init5[] = {
         MULTIPLE_COMMANDS,                    // Co = 0, D/C = 0
         SSD1306_SETPRECHARGE,                 // 0xD9
         ((VCC_CONTROL == OledVccControl_External) ? 0x22 : 0xF1),
         SSD1306_SETVCOMDETECT,                // 0xDB
         0x40,
         SSD1306_DISPLAYALLON_RESUME,          // 0xA4
         SSD1306_NORMALDISPLAY,                // 0xA6
         SSD1306_DEACTIVATE_SCROLL,
         SSD1306_DISPLAYON,                    // Main screen turn on
   };
   i2c.transmit(I2C_ADDRESS, init5);
}

/**
 * Turn display on or off
 */
void Oled::enable(bool enable) {
   static const uint8_t onCommand[] = {
         MULTIPLE_COMMANDS,                    // Co = 0, D/C = 0
         SSD1306_DISPLAYON,                    // 0xAF
   };
   static const uint8_t offCommand[] = {
         MULTIPLE_COMMANDS,                    // Co = 0, D/C = 0
         SSD1306_DISPLAYOFF,                   // 0xAE
   };
   i2c.transmit(I2C_ADDRESS, enable?onCommand:offCommand);
}

/**
 * Control display contrast/brightness
 *
 *  Has no appreciable effect on display tested
 *
 * @param level
 */
void Oled::setContrast(uint8_t level) {
   uint8_t contrastCommand[] = {
         MULTIPLE_COMMANDS,                    // Co = 0, D/C = 0
         SSD1306_SETCONTRAST,                  // 0x81
         level,
   };
   i2c.transmit(I2C_ADDRESS, contrastCommand);
}

/**
 * Refresh OLED from frame buffer
 */
void Oled::refreshImage() {
   buffer.controlByte = MULTIPLE_GDRAM;
   i2c.transmit(I2C_ADDRESS, buffer.rawData);
}

/**
 * Write image to frame buffer
 *
 * @param [in] dataPtr    Pointer to start of image
 * @param [in] x          X position of top-left corner
 * @param [in] y          Y position of top-left corner
 * @param [in] width      Width of image
 * @param [in] height     Height of image
 * @param [in] writeMode  Write mode (inverse, xor etc)
 */
Oled &Oled::writeImage(const uint8_t *dataPtr, int x, int y, int width, int height, WriteMode writeMode) {
   // Doesn't support negative clipping of images
   usbdm_assert((x>=0)||(y>=0), "Illegal image coordinate");

   if ((x>=WIDTH)||(y>=HEIGHT)) {
      // Entirely off screen
      return *this;
   }
   for(int h=0; h<height; h++) {
      if ((y+h) >= HEIGHT) {
         // Clip at bottom
         break;
      }
      for(int w=0;w<width; w++) {
         if ((x+w) >= WIDTH) {
            // Clip on right
            break;
         }
         // Get pixel value from image
         unsigned pixelIndex = (h*((width+7)/8))+(w/8);
         bool pixel = (dataPtr[pixelIndex]&(1<<(7-(w&0b111))));
         if constexpr (orientation == Orientation_Normal) {
            uint8_t mask = 0b1<<((y+h)&0b111);
            unsigned index = (x+w)+(((y+h)/8)*WIDTH);
            putPixel(index, mask, pixel, writeMode);
         }
         if constexpr (orientation == Orientation_Rotated_180) {
            uint8_t mask = 0b1<<(7-((y+h)&0b111));
            unsigned index = ((WIDTH-1)-x-w)+((((HEIGHT-1)-y-h)/8)*WIDTH);
            putPixel(index, mask, pixel, writeMode);
         }
      }
   }
   return *this;
}

/**
 * Write a character to the LCD in graphics mode at the current x,y location
 *
 * @param[in]  ch - character to send
 */
void Oled::_writeChar(char ch) {
   int width  = font->width;
   int height = font->height;
   if (ch == '\n') {
      putSpace(WIDTH-x);
      x  = 0;
      y += fontHeight;
      fontHeight = 0;
   }
   else {
      if ((x+width)>WIDTH) {
         // Don't display partial characters
         return;
      }
      writeImage((*font)[ch], x, y, width, height);
      x += width;
      fontHeight = max(fontHeight, height);
   }
   return;
}

/**
 * Writes whitespace to the frame buffer at the current x,y location
 *
 * @param[in] width Width of white space in pixels
 */
Oled &Oled::putSpace(int width) {
   static const uint8_t space[] = {0x00,0x00,0x00,0x00,0x00,0x00,0x00,0x00};
   while (width>0) {
      int t = 8;
      if (t>width) {
         t = width;
      }
      width -= t;
      putCustomChar(space, t, 8);
   }
   return *this;
}

/**
 *
 * @param [in] index      Index into frame buffer in bytes
 * @param [in] mask       Mask for pixel being manipulated in byte
 * @param [in] pixel      Pixel value
 * @param [in] writeMode  Mode of modification
 */
void Oled::putPixel(unsigned index, uint8_t mask, bool pixel, WriteMode writeMode) {
   usbdm_assert(index < IMAGE_DATA_SIZE, "Illegal index");
   switch(writeMode) {
      case WriteMode_Write:
         if (pixel) {
            buffer.data[index] |= mask;
         }
         else {
            buffer.data[index] &= ~mask;
         }
         break;
      case WriteMode_InverseWrite:
         if (pixel) {
            buffer.data[index] &= ~mask;
         }
         else {
            buffer.data[index] |= mask;
         }
         break;
      case WriteMode_Or:
         if (pixel) {
            buffer.data[index] |= mask;
         }
         break;
      case WriteMode_InverseAnd:
         if (!pixel) {
            buffer.data[index] &= ~mask;
         }
         break;
      case WriteMode_Xor:
         if (pixel) {
            buffer.data[index] ^= mask;
         }
         break;
      default:
         break;
   }

}

/**
 * Draw vertical line to frame buffer
 *
 * @param [in] x           X position in pixels
 * @param [in] y1          Top Y position
 * @param [in] y2          Bottom Y position
 * @param [in] writeMode   Mode of modification
 */
void Oled::drawVerticalLine(int x, int y1, int y2, WriteMode writeMode) {
   if ((x<0)||(x>=WIDTH)) {
      // Off screen
      return;
   }
   if constexpr (orientation == Orientation_Rotated_180) {
      x = (WIDTH-1)-x;
      y1 = (HEIGHT-1)-y1;
      y2 = (HEIGHT-1)-y2;
   }
   if (y1>y2) {
      int t = y1;
      y1 = y2;
      y2 = t;
   }
   if (y1<0) {
      y1 = 0;
   }
   if (y2>=HEIGHT) {
      y2 = HEIGHT-1;
   }
   uint8_t  startMask   = 0b11111111U<<(unsigned(y1&7));
   uint8_t  endMask     = ~(0b11111111U<<(unsigned(y2&7)+1));

   uint8_t mask = startMask;
   unsigned startRow = y1>>3;
   unsigned endRow   = y2>>3;

   unsigned index = (y1>>3)*WIDTH + x;
   for (unsigned row=startRow; row<endRow; row++) {
      putPixel(index, mask, 1, writeMode);
      mask = 0xFF;
      index += WIDTH;
   }
   mask &= endMask;
   putPixel(index, mask, 1, writeMode);
}

/**
 * Draw horizontal line to frame buffer
 *
 * @param [in] x1          Left X position in pixel
 * @param [in] x2          Right X position in pixel
 * @param [in] y           Y position
 * @param [in] writeMode   Mode of modification
 */
void Oled::drawHorizontalLine(int x1, int x2, int y, WriteMode writeMode) {
   if ((y<0)||(y>=HEIGHT)) {
      // Off screen
      return;
   }
   if constexpr (orientation == Orientation_Rotated_180) {
      x1 = (WIDTH-1)-x1;
      x2 = (WIDTH-1)-x2;
      y = (HEIGHT-1)-y;
   }
   if (x1>x2) {
      int t = x1;
      x1 = x2;
      x2 = t;
   }
   if (x1<0) {
      x1 = 0;
   }
   if (x2>=WIDTH) {
      x2 = WIDTH-1;
   }
   uint8_t mask = 0b1<<(y&0b111);
   unsigned baseIndex = ((y>>3) * WIDTH);
   for (unsigned xx=(unsigned)x1; xx<=(unsigned)x2; xx++) {
      unsigned index = xx + baseIndex;
      putPixel(index, mask, 1, writeMode);
   }
}

/**
 * Draw pixel to frame buffer
 *
 * @param [in] x          Horizontal position in pixel
 * @param [in] y          Vertical position in pixel
 * @param [in] pixel      Pixel value
 * @param [in] writeMode  Mode of modification
 */
void Oled::drawPixel(int x, int y, bool pixel, WriteMode writeMode) {
   if ((x<0)||(x>=WIDTH)) {
      // Off screen
      return;
   }
   if ((y<0)||(y>=HEIGHT)) {
      // Off screen
      return;
   }
   if constexpr (orientation == Orientation_Rotated_180) {
      x = (WIDTH-1)-x;
      y = (HEIGHT-1)-y;
   }
   uint8_t mask = 0b1<<(y&7);
   unsigned index = x+((y>>3)*WIDTH);
   putPixel(index, mask, pixel, writeMode);
}

/**
 *   Draw filled rectangle
 *
 * @param x1         Top-left X
 * @param y1         Top-left Y
 * @param x2         Bottom-right X
 * @param y2         Bottom-right Y
 * @param writeMode  Write mode (inverse, xor etc)
 */
void Oled::drawRect(int x1, int y1, int x2, int y2, WriteMode writeMode) {
   if (y1>y2) {
      int t = y1;
      y1 = y2;
      y2 = t;
   }
   for (int y=y1; y<=y2; y++) {
      drawHorizontalLine(x1, x2, y, writeMode);
   }
}
