podonoghue/SolderingStation/Software/SolderingStation_V4_MK20M7/Sources/SwitchPolling.cpp

/*
 * Switches.cpp
 *
 *  Created on: 5 Apr 2020
 *      Author: podonoghue
 */
#include "SwitchPolling.h"
#include "QuadDecoder.h"
#include "Channels.h"
#include "queue"
#include "Control.h"

using namespace USBDM;

/// How often the switches are polled
constexpr Seconds POLL_INTERVAL        = 10_ms;                        // Polled every 10 ms

/// Number of consistent samples to confirm debouncing
constexpr unsigned DEBOUNCE_COUNT      = round(40_ms/POLL_INTERVAL);   // Number if polls in 40 ms

/// How long to hold a button for long press in samples
constexpr unsigned HOLD_COUNT          = round(1_s/POLL_INTERVAL);     // Number if polls in 1 s

/**
 * Get name of event from event type
 *
 * @param eventType_ Event to describe
 *
 * @return Pointer to static string
 */
const char * getEventName(const EventType eventType) {
   static const char * const table[] = {
         "ev_None",
         "ev_QuadPress",
         "ev_QuadRelease",
         "ev_QuadHold",
         "ev_Ch1Press",
         "ev_Ch1Release",
         "ev_Ch1Hold",
         "ev_Ch2Press",
         "ev_Ch2Release",
         "ev_Ch2Hold",
         "ev_SelPress",
         "ev_SelRelease",
         "ev_SelHold",
         "ev_Ch1Ch2Press",
         "ev_Ch1Ch2Release",
         "ev_Ch1Ch2Hold",
         "ev_QuadRotate",
         "ev_Tool1Active",
         "ev_Tool2Active",
         "ev_Tool1Idle",
         "ev_Tool2Idle",
         "ev_Tool1LongIdle",
         "ev_Tool2LongIdle",
   };
   if (eventType>=(sizeof(table)/sizeof(table[0]))) {
      return "???";
   }
   return table[eventType];
}

/**
 * Button polling
 */
EventType SwitchPolling::pollSwitches() {

   // How long the buttons have been unchanged
   static unsigned stableButtonCount = 0;

   // Result from when the buttons were last polled
   static unsigned lastButtonPoll    = 0;

   // Button held event but pending until released
   static EventType pendingEvent = ev_None;

   // Poll buttons
   unsigned  currentButtonValue = Buttons::read();

   // Count stable time with roll-over prevention
   if (stableButtonCount < UINT_MAX) {
      stableButtonCount++;
   }

   if (currentButtonValue != lastButtonPoll) {
      // Button change - start over
      stableButtonCount = 0;
      lastButtonPoll    = currentButtonValue;
      return ev_None;
   }

   if (currentButtonValue == 0) {
      EventType event = ev_None;
      if (pendingEvent == ev_None) {
         // Not a button release
      }
      else if (quadState == QuadState_Pressed_Rotate) {
         // Swallow quad-release
      }
      else {
         // Regular button release
         event = pendingEvent;
      }
      pendingEvent = ev_None;
      quadState = QuadState_Normal;
      return event;
   }

   // Check at debounce time for valid button
   if (stableButtonCount == DEBOUNCE_COUNT) {

      // We have button(s) pressed for the debounce time - regular button press
      switch(currentButtonValue) {
         case (1<<(Ch1Button::BITNUM-Buttons::RIGHT))  : pendingEvent = ev_Ch1Release;    break;
         case (1<<(Ch2Button::BITNUM-Buttons::RIGHT))  : pendingEvent = ev_Ch2Release;    break;
         case (1<<(MenuButton::BITNUM-Buttons::RIGHT)) : pendingEvent = ev_SelRelease;    break;
         case (1<<(QuadButton::BITNUM-Buttons::RIGHT)) : pendingEvent = ev_QuadRelease;   quadState = QuadState_Pressed; break;
         case (1<<(Ch1Button::BITNUM-Buttons::RIGHT))|
               (1<<(Ch2Button::BITNUM-Buttons::RIGHT)) : pendingEvent = ev_Ch1Ch2Release; break;
         default:                                        pendingEvent = ev_None;        break;
      }
      // Don't report button presses - only releases
      // This allows use of hold events
      return ev_None;
   }

   // Check at hold time for valid button
   if (stableButtonCount == HOLD_COUNT) {
      //      console.write('l');
      EventType event = ev_None;

      // Ignore button releases after hold
      pendingEvent = ev_None;

      // We have a button pressed for the hold time - long held button
      switch(currentButtonValue) {
         case (1<<(Ch1Button::BITNUM-Buttons::RIGHT))  : event = ev_Ch1Hold;    break;
         case (1<<(Ch2Button::BITNUM-Buttons::RIGHT))  : event = ev_Ch2Hold;    break;
         case (1<<(MenuButton::BITNUM-Buttons::RIGHT)) : event = ev_SelHold;    break;
         case (1<<(QuadButton::BITNUM-Buttons::RIGHT)) :
            // Swallow QuadHold when rotating
            if (quadState != QuadState_Pressed_Rotate) {
               event = ev_QuadHold;
            }
            break;
         case (1<<(Ch1Button::BITNUM-Buttons::RIGHT))|
               (1<<(Ch2Button::BITNUM-Buttons::RIGHT)) : event = ev_Ch1Ch2Hold; break;
         default                                       : event = ev_None;       break;
      }
      return event;
   }
   return ev_None;
}

/**
 * Set-back Polling
 */
void SwitchPolling::pollSetbacks() {

   // Indicates tool was in use when last polled
   static bool lastToolBusy[channels.NUM_CHANNELS] = {false};

   // Indicates tool is in use currently
   bool toolBusy[channels.NUM_CHANNELS];

//   // Get current tool rest state
//   unsigned toolPoll = Setbacks::read();
//
//   // Poll tools
//   toolBusy[0] = toolPoll & (1<<(Ch1Stand::BITNUM-Setbacks::RIGHT));
//   toolBusy[1] = toolPoll & (1<<(Ch2Stand::BITNUM-Setbacks::RIGHT));

   toolBusy[0] = false;
   toolBusy[1] = false;

   for (unsigned tool=0; tool<channels.NUM_CHANNELS; tool++) {

      Channel &channel = channels[tool+1];

      if (lastToolBusy[tool] != toolBusy[tool]) {

         // Tool moved - start over
         channel.restartIdleTimer();
         lastToolBusy[tool] = toolBusy[tool];
      }
      else if (!toolBusy[tool]) {

         // Tool in holder - increment idle time
         channel.incrementIdleTime(POLL_INTERVAL/1_ms);
      }
   }
   control.updateDisplayInUse(POLL_INTERVAL/1_ms);
}

/**
 * Get last input event
 *
 * @return Event or ev_None if none.
 */
Event SwitchPolling::getEvent() {
   Event t = {ev_None, 0};

   t.type = eventQueue.get();

   if (t.type == ev_None) {
      // Check rotary encoder
      static int16_t lastQuadPosition = 0;
      int16_t currentQuadPosition = encoder.getPosition();
      t.change = currentQuadPosition - lastQuadPosition;
      if (t.change != 0) {

//         // Restart timers on use of rotary encoder
//         channels.restartIdleTimers();
//
         if (quadState == QuadState_Normal) {
            t.type   = ev_QuadRotate;
         }
         else {
            quadState = QuadState_Pressed_Rotate;
            t.type = ev_QuadRotatePressed;
         }
         lastQuadPosition = currentQuadPosition;
      }
   }
   return t;
}

/**
 * Initialise the switch polling
 */
void SwitchPolling::initialise() {

   encoder.initialise();

   quadState = QuadState_Normal;

   Buttons::setInput(PinPull_Up, PinAction_None, PinFilter_Passive);

//   Setbacks::setInput(PinPull_Up, PinAction_None, PinFilter_Passive);

   /**
    * Call-back handling switch and set-back polling
    */
   static const auto callBack = []() {
      This->eventQueue.add(This->pollSwitches());
      This->pollSetbacks();
   };

   PollingTimerChannel::configureIfNeeded(PitDebugMode_Stop);
   PollingTimerChannel::configure(POLL_INTERVAL, PitChannelIrq_Enabled);
   PollingTimerChannel::setCallback(callBack);
   PollingTimerChannel::enableNvicInterrupts(NvicPriority_Normal);
}

SwitchPolling *SwitchPolling::This = nullptr;
