podonoghue/SolderingStation/Software/SolderingStation_V4_MK20M7/Sources/BoundedInteger.h

/*
 * BoundedInteger.h
 *
 *  Created on: 17 Jun. 2021
 *      Author: peter
 */

#ifndef SOURCES_BOUNDEDINTEGER_H_
#define SOURCES_BOUNDEDINTEGER_H_

class LimitedInteger {

protected:
   const int min;
   const int max;
   int value;

protected:
   /**
    * Constructor for a limited integer
    *
    * @param min           Minimum value
    * @param max           Maximum value
    * @param initialValue  Initial value
    */
   LimitedInteger(int min, int max, int initialValue) : min(min), max(max), value(initialValue) {
   }

   /**
    * Constructor for a limited integer
    * The minimum value defaults to zero
    *
    * @param max           Maximum value
    * @param initialValue  Initial value
    */
   LimitedInteger(int max, int initialValue) : min(0), max(max), value(initialValue) {
      usbdm_assert((min<=value)&&(value<=max), "Invalid parameters!");
   }

   virtual ~LimitedInteger() {}

   /**
    * Limit value to acceptable range
    */
   virtual void limit() = 0;

public:
   /**
    * Add delta to current value
    *
    * @param delta Amount to increment value by
    *
    * @return  New current value
    */
   LimitedInteger &operator+=(int delta) {
      value += delta;
      limit();
      return *this;
   }

   /**
    * Subtract delta from current value
    *
    * @param delta Amount to decrement value by
    *
    * @return  New current value
    */
   LimitedInteger &operator-=(int delta) {
      value -= delta;
      limit();
      return *this;
   }

   /**
    * Add 1 to current value
    *
    * @return  New current value
    */
   LimitedInteger &operator++(int) {
      value++;
      limit();
      return *this;
   }

   /**
    * Subtract 1 from current value
    *
    * @return  New current value
    */
   LimitedInteger &operator--(int) {
      value--;
      limit();
      return *this;
   }

   /**
    * Get current value
    */
   operator int() const {
      return value;
   }

   /**
    * Assign value
    *
    * @param value Value to assign
    *
    * @return  Current value (may differ from value)
    */
   LimitedInteger &operator=(int value) {
      this->value = value;
      limit();
      return *this;
   }

   int getMax() const {
      return max;
   }

   int getMin() const {
      return min;
   }
};

/**
 * Class representing an integer restricted to a given range.
 * The integer 'sticks' at either boundary.
 */
class BoundedInteger : public LimitedInteger {

public:
   /**
    * Constructor for a bounded integer
    *
    * @param min           Minimum value
    * @param max           Maximum value
    * @param initialValue  Initial value
    */
   BoundedInteger(int min, int max, int initialValue) : LimitedInteger(min, max, initialValue) {
   }

   /**
    * Constructor for a bounded integer
    * The minimum value defaults to zero
    *
    * @param max           Maximum value
    * @param initialValue  Initial value
    */
   BoundedInteger(int max, int initialValue) : LimitedInteger(max, initialValue) {
   }

private:
   /**
    * Limit value to acceptable range
    */
   virtual void limit() override {
      if (value>max) {
         value = max;
      }
      if (value<min) {
         value = min;
      }
   }
};

/**
 * Class representing an integer restricted to a given range.
 * The integer 'rolls-over' at either boundary.
 */
class CircularInteger : public LimitedInteger {

public:
   /**
    * Constructor for a bounded integer
    *
    * @param min           Minimum value
    * @param max           Maximum value
    * @param initialValue  Initial value
    */
   CircularInteger(int min, int max, int initialValue) : LimitedInteger(min, max, initialValue) {
   }

   /**
    * Constructor for a bounded integer
    * The minimum value defaults to zero
    *
    * @param max           Maximum value
    * @param initialValue  Initial value
    */
   CircularInteger(int max, int initialValue) : LimitedInteger(max, initialValue) {
   }

private:
   /**
    * Limit value to acceptable range
    */
   virtual void limit() override {
      if (value>max) {
         value = min  + (value - max - 1);
      }
      if (value<min) {
         value = max - (min - value - 1);
      }
   }
};

#endif /* SOURCES_BOUNDEDINTEGER_H_ */
