podonoghue/SolderingStation/Software/SolderingStation_V4_MK20M7/Sources/TipSettings.cpp

/*
 * TipSettings.cpp
 *
 *  Created on: 12 Jun. 2021
 *      Author: peter
 */

#include <string.h>
#include <Weller.h>

#include "TipSettings.h"
#include "error.h"
#include "NonvolatileSettings.h"
#include "T12.h"
#include "Jbc.h"
#include "AttenTweezers.h"

using namespace USBDM;

const InitialTipInfo TipSettings::initialTipInfo[SIZE_OF_TIP_ARRAY] = {
      {"NoTip", IronType_Unknown },
      {"B0",    IronType_T12 },
      {"B1",    IronType_T12 },
      {"B2",    IronType_T12 },
      {"B3",    IronType_T12 },
      {"B4",    IronType_T12 },
      {"B2Z",   IronType_T12 },
      {"BC1",   IronType_T12 },
      {"BC1.5", IronType_T12 },
      {"BC2",   IronType_T12 },
      {"BC3",   IronType_T12 },
      {"BC1Z",  IronType_T12 },
      {"BC2Z",  IronType_T12 },
      {"BC4Z",  IronType_T12 },
      {"BCF1",  IronType_T12 },
      {"BCF2",  IronType_T12 },
      {"BCF3",  IronType_T12 },
      {"BCF4",  IronType_T12 },
      {"BCF1Z", IronType_T12 },
      {"BCF2Z", IronType_T12 },
      {"BCF3Z", IronType_T12 },
      {"BCM2",  IronType_T12 },
      {"BCM3",  IronType_T12 },
      {"BL",    IronType_T12 },
      {"BZ",    IronType_T12 },
      {"C1",    IronType_T12 },
      {"C2",    IronType_T12 },
      {"C3",    IronType_T12 },
      {"C4",    IronType_T12 },
      {"D08",   IronType_T12 },
      {"D12",   IronType_T12 },
      {"D16",   IronType_T12 },
      {"D24",   IronType_T12 },
      {"D52",   IronType_T12 },
      {"D4",    IronType_T12 },
      {"DL12",  IronType_T12 },
      {"DL32",  IronType_T12 },
      {"DL52",  IronType_T12 },
      {"D12Z",  IronType_T12 },
      {"D24Z",  IronType_T12 },
      {"D4Z",   IronType_T12 },
      {"I",     IronType_T12 },
      {"IL",    IronType_T12 },
      {"ILS",   IronType_T12 },
      {"J02",   IronType_T12 },
      {"JL02",  IronType_T12 },
      {"JS02",  IronType_T12 },
      {"K",     IronType_T12 },
      {"KF",    IronType_T12 },
      {"KL",    IronType_T12 },
      {"KR",    IronType_T12 },
      {"KFZ",   IronType_T12 },
      {"KRZ",   IronType_T12 },
      {"KU",    IronType_T12 },
      {"WB2",   IronType_T12 },
      {"WD08",  IronType_T12 },
      {"WD12",  IronType_T12 },
      {"WD16",  IronType_T12 },
      {"WD52",  IronType_T12 },
      {"WI",    IronType_T12 },
      {"N1-06", IronType_T12 },
      {"N1-08", IronType_T12 },
      {"N1-10", IronType_T12 },
      {"N1-13", IronType_T12 },
      {"N1-16", IronType_T12 },
      {"N1-20", IronType_T12 },
      {"N1-23", IronType_T12 },
      {"N1-L1", IronType_T12 },
      {"WT50S", IronType_Weller },
      {"WT50M", IronType_Weller },
      {"WT50L", IronType_Weller },
      {"WSP80", IronType_Weller },
      {"C-20",  IronType_JBC_C210 },
      {"C-18",  IronType_JBC_C210 },
      {"C-IS",  IronType_JBC_C210 },
      {"Atten", IronType_AttenTweezers },
};

/**
 * Get TipNameIndex for given tip name
 *
 * @param tipName  Tip name
 *
 * @return TipNameIndex (index into tip name table)
 */
TipSettings::TipNameIndex TipSettings::getTipNameIndex(const char *tipName) {
   for(TipNameIndex index=FIRST_TIP; index<=LAST_VALID_TIP; inc(index)) {
      if (strcmp(initialTipInfo[index].name, tipName) == 0) {
         return index;
      }
   }
   usbdm_assert(false, "Tip not found");
   abort();
}

/**
 * Get tip name for given TipNameIndex
 *
 * @param index Index into name table
 *
 * @return Pointer to static string
 */
const char *TipSettings::getTipName(TipNameIndex index) {
   if (index >= LAST_VALID_TIP) {
      return "----";
   }
   return initialTipInfo[index].name;
}

const char *TipSettings::getIronTypeName(IronType ironType) {
   static const char *names[] = {
         "Unknown",
         "Weller",
         "T12",
         "JBC-C210",
         "Atten",
   };
   if (ironType >= USBDM::sizeofArray(names)) {
      return "----";
   }
   return names[ironType];
}

/**
 * Load default calibration values for given tip
 *
 * @param tipNameIndex  Tip name index for this setting
 */
void TipSettings::loadDefaultCalibration(TipNameIndex tipNameIndex) {
   this->nvTipNameIndex = tipNameIndex;
   this->nvFlags        = 0;

   const InitialTipInfo &initInfo = initialTipInfo[tipNameIndex];
   switch(initInfo.type) {
      case IronType_T12:
         T12::initialiseSettings(this,  initInfo);
         break;
      case IronType_Weller:
         Weller::initialiseSettings(this,  initInfo);
         break;
      case IronType_JBC_C210:
         JBC_C210::initialiseSettings(this,  initInfo);
         break;
      case IronType_AttenTweezers:
         AttenTweezers::initialiseSettings(this,  initInfo);
         break;
      default:
         usbdm_assert(false, "Illegal iron type");
         break;
   }
}

/**
 * Report settings object
 *
 * @param io Where to write report
 */
void TipSettings::report(FormattedIO &io) {
   using namespace USBDM;
   io.write("name   = ").writeln(getTipName());
   io.write("Kp     = ").writeln(getKp());
   io.write("Ki     = ").writeln(getKi());
   io.write("Kd     = ").writeln(getKd());
   io.write("iLimit = ").writeln(getILimit());
   io.write("flags  = 0b").writeln((uint16_t)nvFlags, Radix_2);
   for (CalibrationIndex index=CalibrationIndex_250; index<=CalibrationIndex_400; ++index) {
      io.
         write("T = ").write(getCalibrationTempValue(index)).
         write(", M = ").writeln(getCalibrationMeasurementValue(index));
   }
}
