podonoghue/SolderingStation/Software/SolderingStation_V4_MK20M7/Sources/Channels.h

/*
 * Channels.h
 *
 *  Created on: 11 Jun. 2021
 *      Author: peter
 */

#ifndef SOURCES_CHANNELS_H_
#define SOURCES_CHANNELS_H_

#include "Channel.h"
#include "NonvolatileSettings.h"
#include "hardware.h"

/**
 * Holding class for the channels
 */
class Channels {

private:

   // Currently selected channel for front panel controls
   unsigned selectedChannel = 1;

   // Channel1
   Channel channel1{nvinit.ch1Settings, USBDM::ch1SelectedLed, USBDM::ch1Drive, USBDM::ch1VoltageSelect};

   // Channel2
   Channel channel2{nvinit.ch2Settings, USBDM::ch2SelectedLed, USBDM::ch2Drive, USBDM::ch2VoltageSelect};

public:

   Channels() {
      using namespace USBDM;

      ch1VoltageSelect.setOutput();
      ch2VoltageSelect.setOutput();

      ch1Drive.setOutput(PinDriveStrength_Low, PinDriveMode_PushPull, PinSlewRate_Fast);
      ch2Drive.setOutput(PinDriveStrength_Low, PinDriveMode_PushPull, PinSlewRate_Fast);

      ch1SelectedLed.setOutput(PinDriveStrength_High, PinDriveMode_PushPull, PinSlewRate_Slow);
      ch2SelectedLed.setOutput(PinDriveStrength_High, PinDriveMode_PushPull, PinSlewRate_Slow);
   }

   /**
    * Number of channels
    */
   static constexpr unsigned NUM_CHANNELS = 2;

   /**
    * Get channel by channel number
    *
    * @param channelNumber
    *
    * @return Reference to indicate channel
    */
   Channel &operator[](int channelNumber) {
      usbdm_assert((channelNumber == 1)||(channelNumber == 2), "Illegal channel");

      return (channelNumber==1)?*(Channel*)&channel1:*(Channel*)&channel2;
   }

   /**
    * Get the number of the selected channel
    *
    * @return Channel number (zero indicates no currently selected channel)
    */
   unsigned getSelectedChannelNumber() {
      return selectedChannel;
   }

   /**
    * Get currently selected channel for front panel controls
    *
    * @return Reference to currently selected channel
    */
   Channel &getSelectedChannel() {
      return this->operator[](selectedChannel);
   }

   /**
    * Set currently selected channel for front panel controls
    * Restarts the idle counter for the selected channel
    *
    * @param channel Channel to make selected
    */
   void setSelectedChannel(unsigned channel) {
      selectedChannel = channel;
      getSelectedChannel().restartIdleTimer();
   }

   /**
    * Restart idle timers on all channels
    */
   void restartIdleTimers() {
      channel1.restartIdleTimer();
      channel2.restartIdleTimer();
   }
};

/// The channel information
extern Channels channels;

#endif /* SOURCES_CHANNELS_H_ */
