podonoghue/SolderingStation/Software/SolderingStation_V4_MK20M7/Sources/Menus.h

/*
 * Menus.h
 *
 *  Created on: 17 Jun. 2021
 *      Author: peter
 */

#ifndef SOURCES_MENUS_H_
#define SOURCES_MENUS_H_
#include "SwitchPolling.h"
#include "SettingsData.h"
#include "TipSettings.h"
#include "Channel.h"

class TipSettings;

class Menus {

private:
   Menus(const Menus &other) = delete;
   Menus(Menus &&other) = delete;
   Menus& operator=(const Menus &other) = delete;
   Menus& operator=(Menus &&other) = delete;
   Menus() = delete;
   ~Menus() = delete;

public:
   /**
    * Confirm action from user
    *
    * @param prompt Prompt to display
    *
    * @return True if confirmed
    * @return false if cancelled
    */
   static bool confirmAction(const char *prompt);

   /**
    * Display and execute top-level menu
    */
   static void settingsMenu();

   /**
    * Edit a non-volatile time setting.
    *
    * @param data Data describing setting to change
    *
    * @return Exiting event
    */
   static EventType editTime(const SettingsData &data);

   /**
    * Edit a non-volatile floating point setting.
    *
    * @param data Data describing setting to change
    *
    * @return Exiting event
    */
   static EventType editFloat(const SettingsData &data);

   /**
    * Edit a non-volatile temperature setting.
    *
    * @param data Data describing setting to change
    *
    * @return Exiting event
    */
   static EventType editTemperature(const SettingsData &data);

   /**
    * Calibrate a tip
    *
    * @param [in]     ch            Channel being used
    * @param [inout]  tipsettings   Tipsettings being determined
    * @param [in]     stage         Stage is calibration sequence
    *
    * @note Channel settings may be altered
    *
    * @return  false - abort or failed
    * @return  true  - continue to next stage
    */
   static bool calibrateTipTemp(Channel &ch, TipSettings &tipsettings, CalibrationIndex stage);

   /**
    * Calculate a non-volatile tip calibration setting.
    *
    * @param data Data describing setting to change
    *
    * @return Exiting event
    */
   static EventType calibrateTipTemps(const SettingsData &data);

   /**
    * Edit a non-volatile tip calibration setting.
    *
    * @param tipSettings Data describing setting to change
    *
    * @return Exiting event
    */
   static bool editPidSetting(TipSettings &tipSettings);

   /**
    * Edit a non-volatile tip PID setting.
    *
    * @return Exiting event
    */
   static EventType editPidSettings(const SettingsData &);

   /**
    * Calculate a non-volatile tip PID settings.
    *
    * @return Exiting event
    */
   static EventType stepResponse(const SettingsData &);

   /**
    * Edit a available tips in non-volatile settings.
    *
    * @return Exiting event
    */
   static EventType selectAvailableTips(const SettingsData &);

   static EventType displayChannelStatuses(const SettingsData &);
   static EventType runHeater(const SettingsData &);

};

#endif /* SOURCES_MENUS_H_ */
