podonoghue/SolderingStation/Software/KinetisBootloaderApp/src/UsbdmSystem.h

/** \file
    \brief Header file for UsbdmSystem

    \verbatim
    Copyright (C) 2015  Peter O'Donoghue

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
    Change History
   +====================================================================
   |    May 2015 | Created
   +====================================================================
    \endverbatim
*/

#ifndef SRC_USBDMSYSTEM_H_
#define SRC_USBDMSYSTEM_H_

#if !defined(CPP_DLL_LOCAL)
   #ifdef _WIN32
      //! Functions exported from a library
      #define CPP_DLL_EXPORT __declspec(dllexport)
      //! Functions imported from a library
      #define CPP_DLL_IMPORT __declspec(dllimport)
      //! Functions local to a library
      #define CPP_DLL_LOCAL
   #else
      //! Functions exported from a library
      #define CPP_DLL_EXPORT __attribute__ ((visibility ("default")))
      //! Functions imported from a library
      #define CPP_DLL_IMPORT __attribute__ ((visibility ("default")))
      //! Functions local to a library
      #define CPP_DLL_LOCAL  __attribute__ ((visibility ("hidden")))
   #endif
#endif

//! Link to routines directly
#define USBDM_SYSTEM_DECLSPEC CPP_DLL_LOCAL

#include <stdint.h>
#include <string>


/**
 * System routines: Logging, paths
 */
class USBDM_SYSTEM_DECLSPEC UsbdmSystem {

private:

   /**
    * Private constructor
    */
   UsbdmSystem() {}
   virtual ~UsbdmSystem() = 0;

public:
   static bool fileExists(const std::string &path);
   /**
    *  Sleep for given number of milliseconds (or longer!)
    *
    *  @param milliSeconds - number of milliseconds to sleep
    */
   static void milliSleep(int milliSeconds);

   /**
    * Gets string describing a USBDM error code
    *
    * @param errorCode - error code returned from USBDM API routine.
    *
    * @return - ptr to static string describing the error.
    */
   static const char *getErrorString(unsigned errorCode);

   /**
    * Options for UsbdmSystem::Log::printDump
    */
   enum {
        BYTE_ADDRESS    = (0<<0),  //!< Addresses identify a byte in memory
        WORD_ADDRESS    = (1<<0),  //!< Addresses identify a word in memory
        BYTE_DISPLAY    = (0<<2),  //!< Display as bytes (8-bits)
        WORD_DISPLAY    = (1<<2),  //!< Display as words (16-bits)
        LONG_DISPLAY    = (2<<2),  //!< Display as longs (32-bits)
        DBIG_ENDIAN     = (0<<4),  //!< Big-endian order
        DLITTLE_ENDIAN  = (1<<4),  //!< Little-endian order
      };

#ifdef LOG
   class USBDM_SYSTEM_DECLSPEC Log {
   public:
      enum When      {neither, entry, exit, both};
      enum Timestamp {none, relative, incremental };

   private:
      static FILE       *logFile;
      static bool        loggingEnabled;
      static Timestamp   timestampMode;
      static int         indent;
      static int         currentLogLevel;
      static const char *currentName;
      const  char       *lastName;
      int                lastLogLevel;
      When               when;

   public:
      Log(const char *name, When when=both);
      ~Log();

      static void    openLogFile(const char *logFileName, const char *description="");
      static void    closeLogFile();
      static void    enableLogging(bool value = true);
      static void    enableTimestamp(Timestamp mode = incremental);
      static void    setLoggingLevel(int level);
      static int     getLoggingLevel();
      static double  getCurrentTime();
      static const char   *getTimeStamp();
      static void    error(const char *format, ...)   __attribute__ ((format (printf, 1, 2)));
      static void    warning(const char *format, ...) __attribute__ ((format (printf, 1, 2)));
      static void    print(const char *format, ...)   __attribute__ ((format (printf, 1, 2)));
      static void    printq(const char *format, ...)  __attribute__ ((format (printf, 1, 2)));
      static void    printDump(const uint8_t *data,
                               unsigned int size,
                               unsigned int startAddress=0x0000,
                               unsigned int organization=BYTE_ADDRESS|BYTE_DISPLAY);
      static void    setLogFileHandle(FILE *logFile);
      static FILE*   getLogFileHandle();
   };

#define LOGGING_Q UsbdmSystem::Log log(__PRETTY_FUNCTION__, UsbdmSystem::Log::neither)
#define LOGGING_E UsbdmSystem::Log log(__PRETTY_FUNCTION__, UsbdmSystem::Log::entry)
#define LOGGING_X UsbdmSystem::Log log(__PRETTY_FUNCTION__, UsbdmSystem::Log::exit)
#define LOGGING   UsbdmSystem::Log log(__PRETTY_FUNCTION__, UsbdmSystem::Log::both)

#else
   /**
    * Class providing logging features
    */
public:
   class USBDM_SYSTEM_DECLSPEC Log {
   public:
      enum When {neither, entry, exit, both};
      /**  \brief Object to allow logging the execution of a function
       *
       *  @param name Name of the function to use in messages
       *  @param when Whether to log entry/exit etc of this function
       */
      Log(const char *name, When when=both) { (void)name; (void)when; };
      Log() {};
      /**  \brief Record exit from a function
       *
       */
      ~Log() {};
      /**  \brief Open log file
       *
       *  @param logFileName - Name of log file
       *  @param description - Description written to log file
       *
       *  @note logging is enabled and timestamp disabled
       */
      static void openLogFile(const char *logFileName, const char *description="") {(void)logFileName; (void)description; }
      /**  \brief Close the log file
       *
       */
      static void closeLogFile() {}
      /** \brief Turns logging on or off
       *
       *  @param value - true/false => on/off logging
       */
      static void enableLogging(bool value) {(void)value;}
      /**  \brief Set logging level relative to current level
       *
       *  @param level - level to log below \n
       *         A 0 value suppresses logging below the current level.
       */
      static void setLoggingLevel(int level) {(void)level;}
      /**  \brief Get logging level relative to current level
       *
       */
      static int  getLoggingLevel() { return 0; }
      /** \brief Provides a print function which prints data into a log file.
       *
       *  @param format Format and parameters as for printf()
       */
      static void error(const char *format, ...) {(void)format;}
      /** \brief Provides a print function which prints data into a log file.
       *
       *  @param format Format and parameters as for printf()
       */
      static void print(const char *format, ...) {(void)format;}
      /** \brief Provides a print function which prints data into a log file.
       *
       *  @param format Format and parameters as for printf()
       */
      static void warning(const char *format, ...) {(void)format;}
      /** \brief Provides a print function which prints data into a log file.
       *
       *  @param format Format and parameters as for printf()
       */
      static void printq(const char *format, ...) {(void)format;}
      /** \brief Print a formatted dump of binary data in Hex
       *
       * @param data         Pointer to data to print
       * @param size         Number of bytes to print
       * @param startAddress Address to display against values
       * @param organisation Size of data & address increment
       */
      static void printDump(const uint8_t *data,
                            unsigned int size,
                            unsigned int startAddress=0x0000,
                            unsigned int organization=BYTE_ADDRESS|BYTE_DISPLAY) {(void)data;(void)size;(void)startAddress;(void)organization;}
      /**
       * Get logging handle
       *
       * @return file handle
       */
      static FILE* getLogFileHandle() { return (FILE*)0; }
      /**
       * Set logging handle
       *
       * @param newLogFile file handle to set
       */
      static void setLogFileHandle(FILE *logFile) {(void)logFile;}
      /** \brief Sets timestamping mode
       *
       *  @param mode - mode of timestamping
       */
      static void enableTimestamping(bool enable=true) {(void)enable;}
   };
   //! Enable logging in function
   #define LOGGING_Q UsbdmSystem::Log log
   //! Enable logging in function & log entry
   #define LOGGING_E UsbdmSystem::Log log
   //! Enable logging in function & log exit
   #define LOGGING_X UsbdmSystem::Log log
   //! Enable logging in function & log entry and exit
   #define LOGGING   UsbdmSystem::Log log
#endif

};

#endif /* SRC_USBDMSYSTEM_H_ */
