podonoghue/SolderingStation/Software/SolderingStation_V4_MK20M7/Sources/BootInformation.h

/*
 * BootInformation.h
 *
 *  Created on: 4 Jan. 2022
 *      Author: peter
 */

#ifndef SOURCES_BOOTINFORMATION_H_
#define SOURCES_BOOTINFORMATION_H_

#include <stdint.h>

#if defined(USBDM_ASSERT)
#include "crc.h"
#else
#include "crc32b.h"
#endif

// USB messages are packed data in LE (native) format
#pragma pack(push, 1)

/// Magic number used to reboot into ICP mode
static constexpr uint32_t MAGIC_NUMBER = 0xA55A1234;

/**
 * Structure of Boot information in Image Flash memory
 */
struct BootInformation {
   static constexpr uint32_t KEY_VALUE = 0xAA551234;

   const uint32_t *magicNumber;        ///< Pointer to magic number location used to force ICP
   const uint32_t softwareVersion;     ///< Version of this software image
   const uint32_t hardwareVersion;     ///< Identifies the hardware this image is intended for
   const uint32_t reserved[3]{0};      ///<
   const uint32_t key;                 ///< Key indicating valid Information

   bool isValid() const {
      return key == KEY_VALUE;
   }

   constexpr BootInformation(
         const uint32_t *magicNumber,
         const uint32_t softwareVersion,
         const uint32_t hardwareVersion ) :
            magicNumber(magicNumber),
            softwareVersion(softwareVersion),
            hardwareVersion(hardwareVersion),
            key(KEY_VALUE) {
   }
};

enum HardwareType : uint32_t {

   // Each unique hardware should define a new number here
   HW_UNKNOWN            = 0,
   HW_LOGIC_BOARD_V2     = 1, // MK20DX128VLF5
   HW_LOGIC_BOARD_V3     = 2, // MK20DX128VLF5
   HW_LOGIC_BOARD_V4     = 3, // MK20DX128VLF5
   HW_SOLDER_STATION_V3  = 4, // MK20DX128VLF5
   HW_LOGIC_BOARD_V4a    = 5, // As for V4 but smaller flash MK20DX32VLF5
   HW_SOLDER_STATION_V4  = 6, // MK20DX256VLH7
};

#if defined(USBDM_ASSERT)
/**
 * Get hardware type as string
 *
 * @param hardwareVersion Version being queried
 *
 * @return Name as string
 *
 * @note return value is a pointer to a STATIC object - do not free
 */
static inline const char *getHardwareType(HardwareType hardwareVersion) {
   static const char *names[] = {
         "Unknown",
         "LOGIC_BOARD_V2",
         "LOGIC_BOARD_V3",
         "LOGIC_BOARD_V4",
         "SOLDER_STATION_V3",
         "LOGIC_BOARD_V4a",
         "SOLDER_STATION_V4",
   };
   const char *name = "Unknown";
   if (hardwareVersion < (sizeof(names)/sizeof(names[0]))) {
      name = names[hardwareVersion];
   }
   return name;
}
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
