podonoghue/SolderingStation/(commit log)

2021-06-08 Work on PID
2021-06-09 Basic PID implemented and setback detection updated
2021-06-10 Work on settings
    [Thermister Measurement Methods.ods]
2021-06-11 Work on switch polling - added queue and changed to button release for actions
2021-06-11 Work on thermistor measurement alternatives.
    [Thermister Measurement Methods.ods]
2021-06-15 Replaced hardware decoder with interrupt based decode for rotary encode.
    [QuadDecoder.cpp, QuadDecoder.h, SwitchPolling.cpp, SwitchPolling.h]
2021-06-15 Lots of work on different things!
    [ThermocoupleCurveFit.ods]
2021-06-25 Work on V3 PCB. Simplified NTC cct. Added isolation.
    [SolderingStation.PrjPcb, SolderingStation_Control.SchDoc, SolderingStation_Power.SchDoc, SolderingStation_Processor.SchDoc]
2021-06-27 Work on PCB
    [SolderingStation.PrjPcb, SolderingStation_Control.SchDoc, SolderingStation_Power.SchDoc, SolderingStation_Processor.SchDoc]
2021-07-04 PCB work: Added clamps to prevent saturation of TC op-amps. Split connector inputs.
    [SolderingStation_Control.SchDoc, SolderingStation_Processor.SchDoc, SolderingStation_V6.PcbDoc]
2021-07-04 Added Resources
    [PWM_Sequence.ods, Thermister (ntc_mf58, 10k B3950) curve fit.ods, Thermister Measurement Methods.ods, Thermistor (ntc_mf58, 10k B3950) curve fit.ods, Thermistor Measurement Methods.ods, ThermocoupleCurveFit.ods]
2021-07-09 Software - Work on PTC temp measurement
    [Thermistor (ntc_mf58, 10k B3950) curve fit.ods, ThermocoupleCurveFit.ods]
2021-07-09 PCB work - Added switchable bias for PTC measurement
    [BOM.xlsx, PinOut.xlsx, SolderingStation-CS.PcbDoc, SolderingStation.PrjPcb, SolderingStation_Control.SchDoc, SolderingStation_Power.SchDoc, SolderingStation_Processor.SchDoc, SolderingStation_V6.PcbDoc]
2021-07-11 PCB work - Added protection
    [SolderingStation.PrjPcb, SolderingStation_Control.SchDoc, SolderingStation_Power.SchDoc, SolderingStation_Processor.SchDoc, Thermistor (ntc_mf58, 10k B3950) curve fit.ods]
2021-07-14 Software - Refactor. Curve fitting for Weller WT50
    [Thermistor (ntc_mf58, 10k B3950) curve fit.ods, ThermocoupleCurveFit.ods]
2021-07-15 Simulations - removed large file
    [ThermocoupleCurveFit.ods]
2021-07-19 Work on PCB - protection, component value changes, spare SMT places
    [SolderingStation.PrjPcb, SolderingStation_Control.SchDoc, SolderingStation_Power.SchDoc, SolderingStation_Processor.SchDoc]
2021-07-20 Work on PCB - Moved power tracks away from signal area.
    [SolderingStation_Control.SchDoc]
2021-07-20 Work on Software - Playing with NTC
    [K-Thermocouple.ods, K-Thermocouple.xlsx, NTC.xlsx, PWM_Sequence.ods, Sensor Curve Fitting.ods, Thermistor (ntc_mf58, 10k B3950) curve fit.ods, Thermistor Measurement Methods.ods, Variable Rate PWM Sequences.ods]
2021-07-23 Work on PCB - Reduced connector by 1 pin
    [SolderingStation.PrjPcb, SolderingStation_Control.SchDoc, SolderingStation_Power.SchDoc, SolderingStation_Processor.SchDoc]
2021-07-27 Work on PCB - Major rework in design
    [FrontPanel.GBL, FrontPanel.GBO, FrontPanel.GBS, FrontPanel.GKO, FrontPanel.GTL, FrontPanel.GTO, FrontPanel.GTP, FrontPanel.GTS]
2021-08-02 Trying different Amplifier gains
    [Sensor Curve Fitting.ods]
2021-08-03 Regressed PCB to separate pull-ups as it allows better timing than using Mux
    [Sensor Curve Fitting.ods, SolderingStation_Control - Using Mux for PUP.SchDoc, SolderingStation_Control.SchDoc, SolderingStation_Power.SchDoc, SolderingStation_Processor.SchDoc]
2021-08-08 Modified PCB to use IMD2AT108
    [Copy of SolderingStation_Control - PUMD2.SchDoc, Simulation Generator waveforms.ods, SolderingStation.PrjPcb, SolderingStation_Control - PUMD2.SchDoc, SolderingStation_Control.SchDoc, SolderingStation_Power.SchDoc, SolderingStation_Processor.SchDoc]
2021-08-12 Mostly cleanup
    [SolderingStation_Control.SchDoc, SolderingStation_Power.SchDoc, SolderingStation_Processor.SchDoc]
2021-08-18 PCB V3 production
    [Copy of SolderingStation_Control - PUMD2.SchDoc, Simulation Generator waveforms.ods, SolderingStation_Control - PUMD2.SchDoc, SolderingStation_Control - Using Mux for PUP.SchDoc]
2021-08-31 PCB V3 tweaks to schematic
    [SolderingStation.PrjPcb, SolderingStation_Control.SchDoc, SolderingStation_Power.SchDoc, SolderingStation_Processor.SchDoc]
2021-08-31 PCB - Started V4
    [SolderingStation_Control - PUMD2.SchDoc, SolderingStation_Control - Using Mux for PUP.SchDoc, SolderingStation_Control.SchDoc, SolderingStation_Power.SchDoc, SolderingStation_Processor.SchDoc, SolderingStation_V4.PrjPcb, TipWiring.SchDoc]
2021-09-04 Initial Work on V4
    [SolderingStation_Control.SchDoc, SolderingStation_Power.SchDoc, SolderingStation_Processor.SchDoc, SolderingStation_V4.PrjPcb, SynchronousRectifier.PcbDoc, SynchronousRectifier.PrjPcb, SynchronousRectifier.SchDoc]
2021-12-21 Software - Last work on V3
    [SolderingStation.PrjPcb, SolderingStation_Control.SchDoc, SolderingStation_Power.SchDoc, SolderingStation_Processor.SchDoc]
2021-12-21 Software - Production V4.0
    [Bill of Materials-SolderingStation.csv, Pick Place for SolderingStation.csv, PickAndPlace_SolderingStation_ASCII.PcbDoc_2021-12-18.csv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]
2021-12-21 Software - Added reference files
    [Sensor Curve Fitting.ods]
2021-12-23 Hardware - Ideas for connecting Irons
    [TipWiring.SchDoc, TipWiring_alt.SchDoc, TipWiring_alt2.SchDoc]
2021-12-23 Hardware - Added useful WMRT schematic
2022-01-08 Hardware - Fixed overlay errors
    [Bill of Materials-SolderingStation.csv, Pick Place for SolderingStation.csv, PickAndPlace_SolderingStation_ASCII.PcbDoc_2021-12-18.csv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]
2022-01-08 Hardware - Transformer overwind wire calculations
    [Sensor Curve Fitting.ods, Transformer wire calculations.ods]
2022-01-27 Software - Added Atten GT-N100 heated tweezers
2022-01-27 General files
    [Sensor Curve Fitting.ods, Transformer wire calculations.ods]
2022-02-02 Software - Some refactoring and tip selection is now restored after power cycle
2022-02-17 Software - Minor changes
    [Sensor Curve Fitting.ods, SolderingStation_Control.SchDoc, SolderingStation_Power.SchDoc, SolderingStation_Processor.SchDoc, SolderingStation_V4.PrjPcb]
